LLLIO400/PSoC-Potentiostat/实验记录/软件端到端测试_硬件联机_20261013.md

# 软件端到端测试(硬件联机)· 2026-10-13

> 方式:驱动**真实 GUI 页面按钮**(非底层协议脚本),10 mM CuSO₄ 溶液、
> 真实设备联机(COM8)。覆盖全部六页的完整软件链路。
> 脚本:`tests/hw_gui_e2e.py`;settings 测试前后自动备份/还原。

## 结果:20/20 PASS

| 页面 | 扫描完成 | 取数 | 自动存档 |
|---|---|---|---|
| CV(1 圈) | ✓ | 2801 点 | ✓ +1 |
| LS | ✓ | 1401 点 | ✓ +1 |
| SWV | ✓ | 281 点 | ✓ +1 |
| DPV | ✓ | 281 点 | ✓ +1 |
| CV 2 圈(超容量降级弹窗正确弹出,软件逐圈) | ✓ | 5601 点(≈2×2801) | — |
| ASV(清洗→搅拌沉积 60 s→静置→SWV 溶出) | ✓ | 380 点 | ✓ +1 |
| 计时电流(10 s 后停止) | ✓ 1400 点 | — | ✓ 停止时自动存档 |
| 中途停止(4 s 后点停止) | ✓ 恢复正常,发出 X 复位 | — | — |

## 结论

- 六个方法页的**真实按钮全链路**(参数发送→静置→扫描→取数→画图→自动存档→按钮恢复)全部正常;
- 多圈超容量降级在 GUI 里按设计工作(弹窗提示 + 软件逐圈跑满);
- 停止功能(X 复位、界面恢复、迟到回调丢弃)正常;
- 计时电流停止时自动存档正常(当天新增功能);
- 测试期间无未处理弹窗阻塞、无 bgerror/TclError 噪音。

## 备注

- 首轮 5 个 FAIL 均为测试脚本自身问题(数据读取方式取反、CV2 超时余量不足),与被测软件无关,已修正后 20/20。
- 串口曾因残留进程句柄锁死(PermissionError),拔插 USB 复位后恢复——开发机注意事项,与固件/软件无关。
- 同日全量离线套件 80/80 通过(`test_report.txt`)。
