LLLIO400/PSoC-Potentiostat/layout_preview/about.png

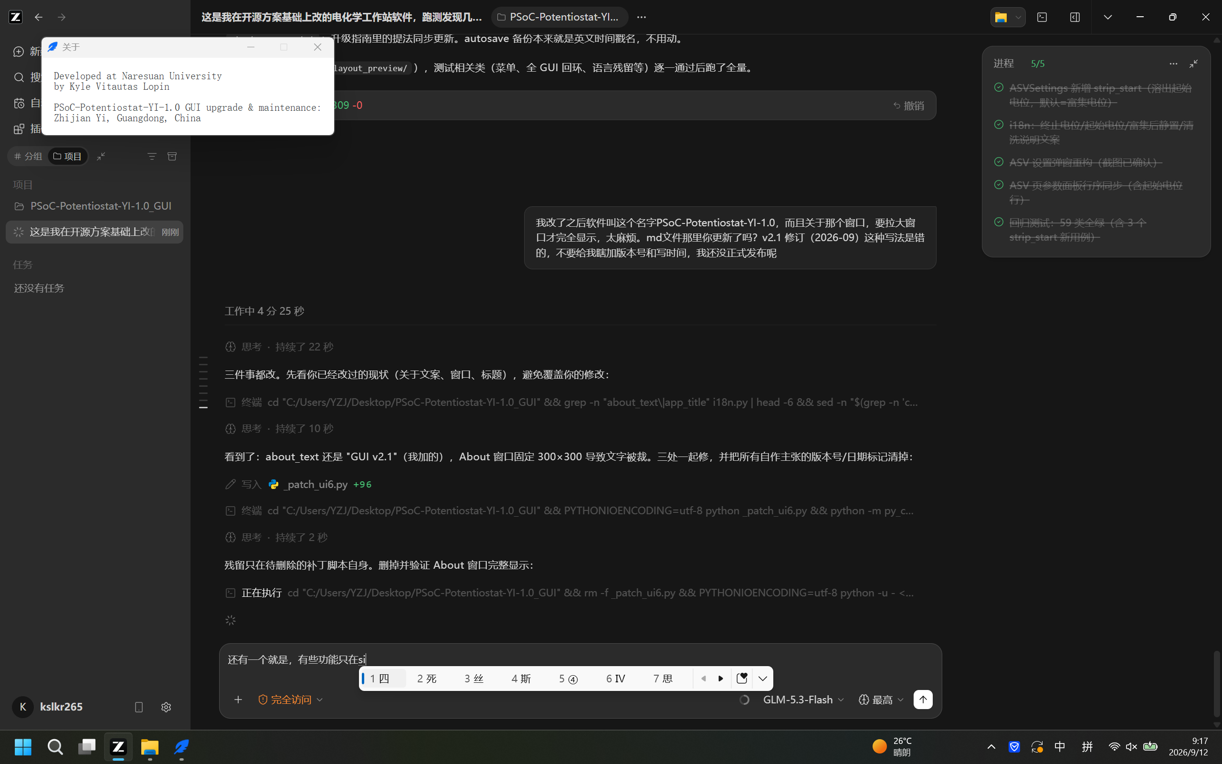
layout_preview/about.png
