LLLIO400/PSoC-Potentiostat/layout_preview/amp.png

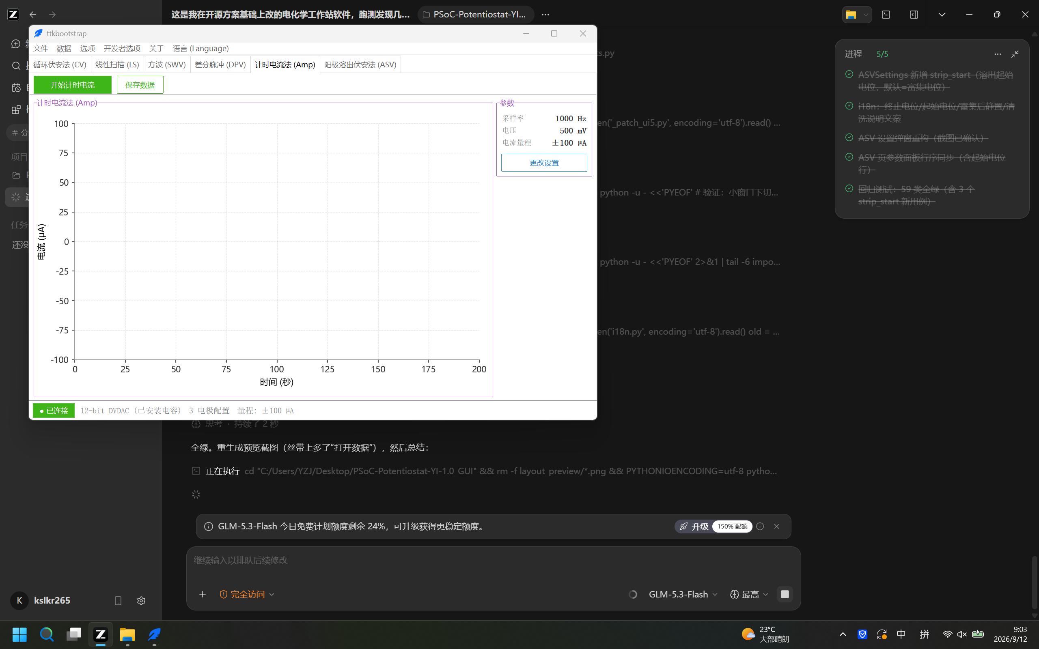
layout_preview/amp.png
