LLLIO400/PSoC-Potentiostat/实验记录/ASV_1000ppb_Bi.png

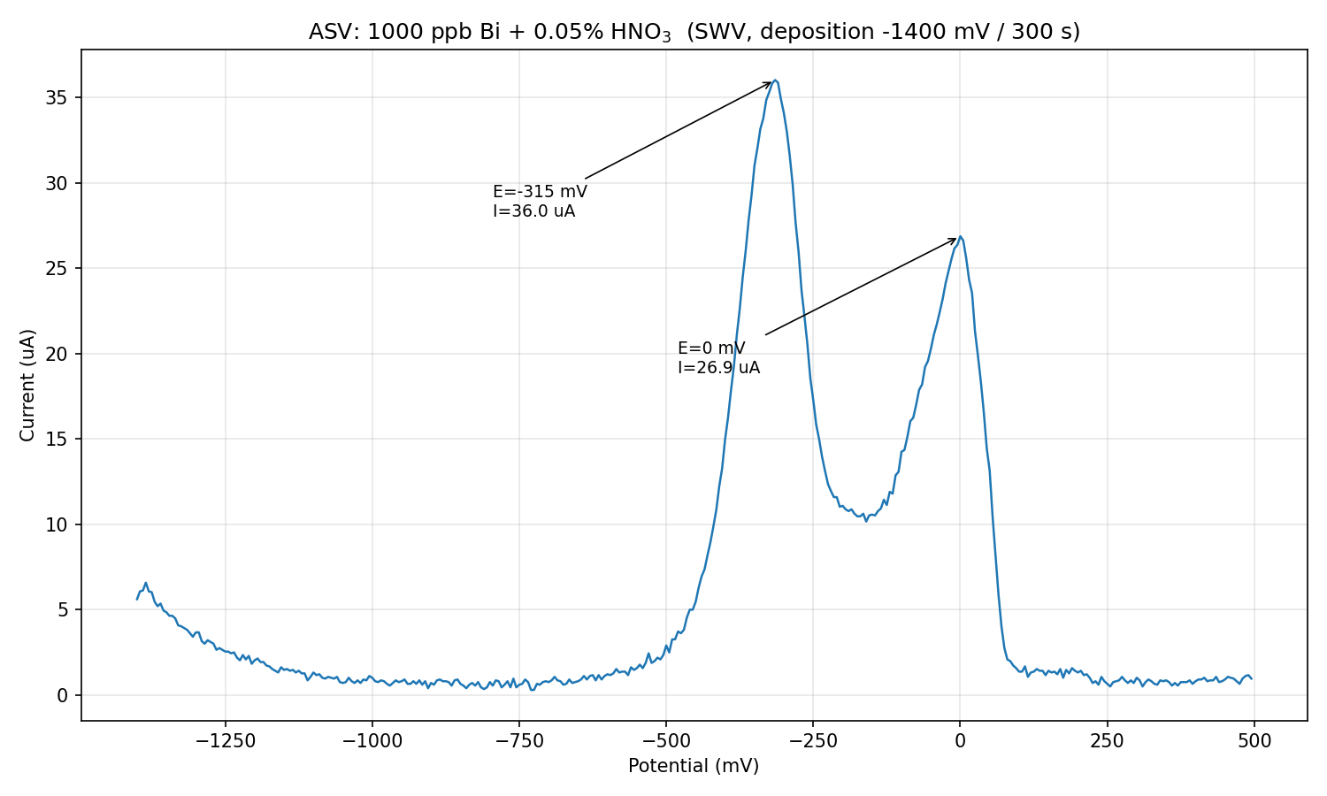
实验记录/ASV_1000ppb_Bi.png
