LLLIO400/PSoC-Potentiostat/实验记录/asv_panel_zoom.png

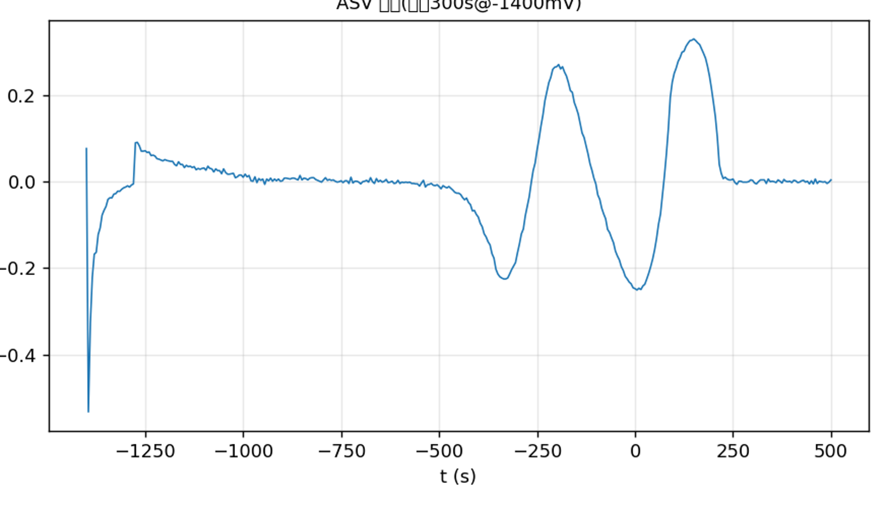
实验记录/asv_panel_zoom.png
