LLLIO400/PSoC-Potentiostat/实验记录/Bi200ppb_ASV寻峰复测.png

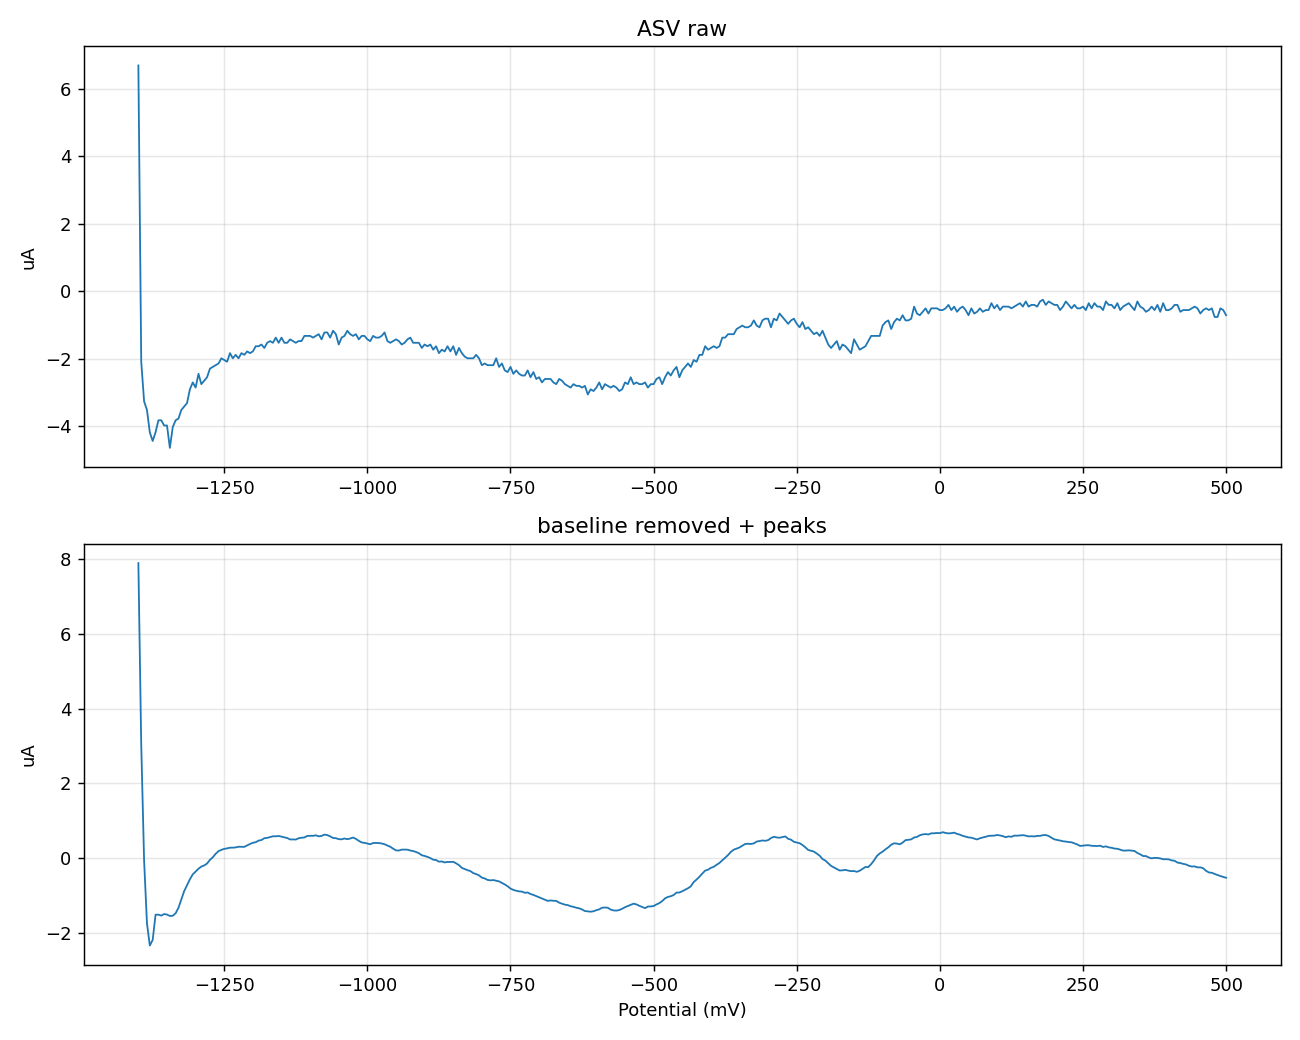
实验记录/Bi200ppb_ASV寻峰复测.png
