LLLIO400/PSoC-Potentiostat/实验记录/Bi200ppb_全功能验证_20261013.png

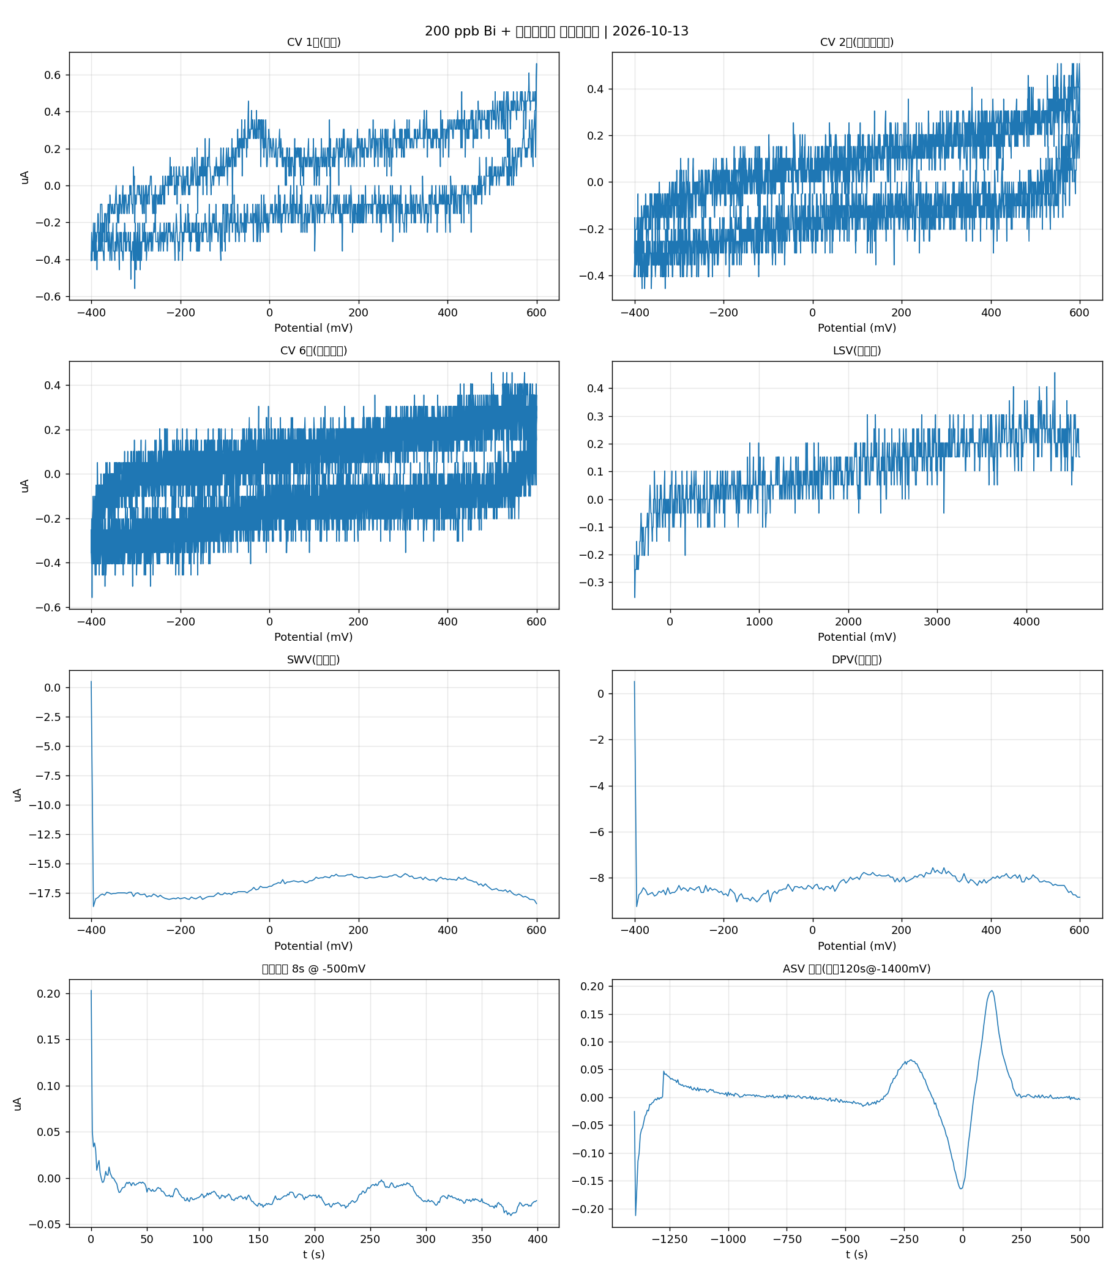
实验记录/Bi200ppb_全功能验证_20261013.png
