LLLIO400/PSoC-Potentiostat/实验记录/cu_swv_deposition_compare.png

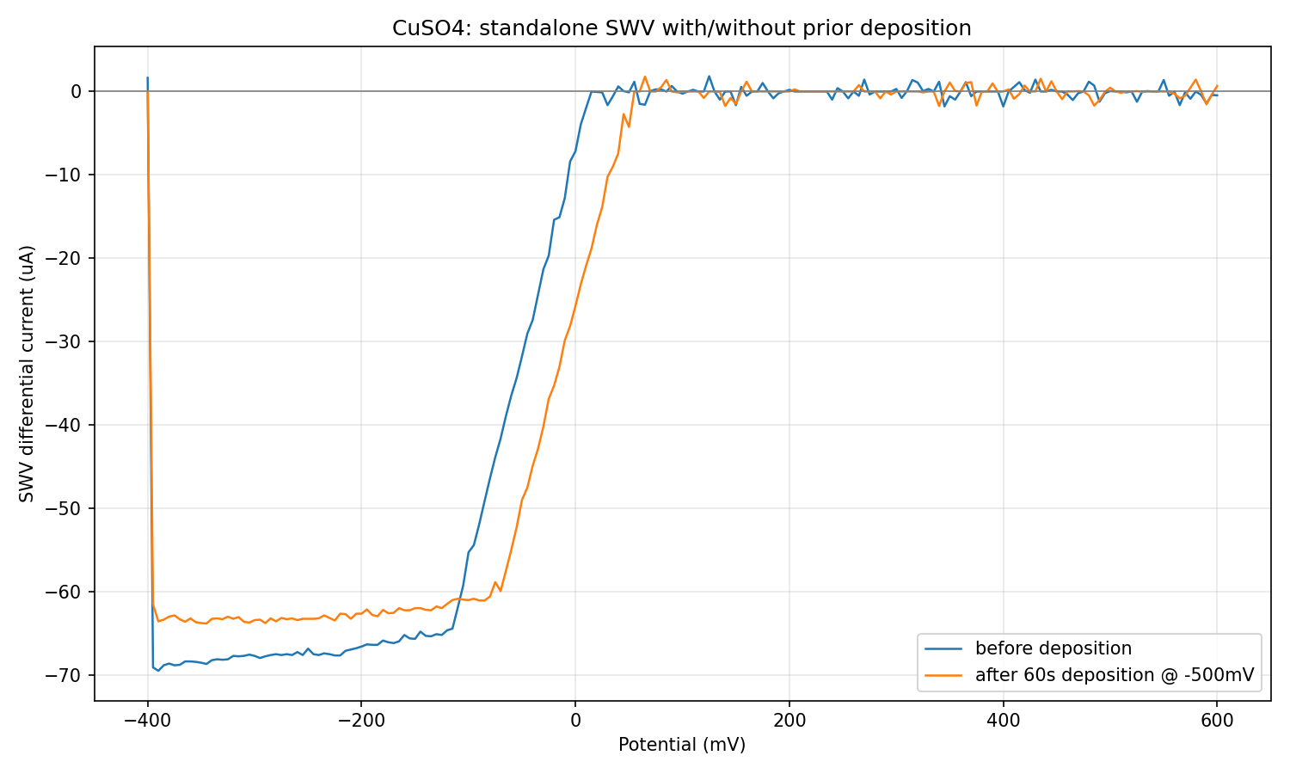
实验记录/cu_swv_deposition_compare.png
