LLLIO400/PSoC-Potentiostat/实验记录/全技术链路验证_20261013.png

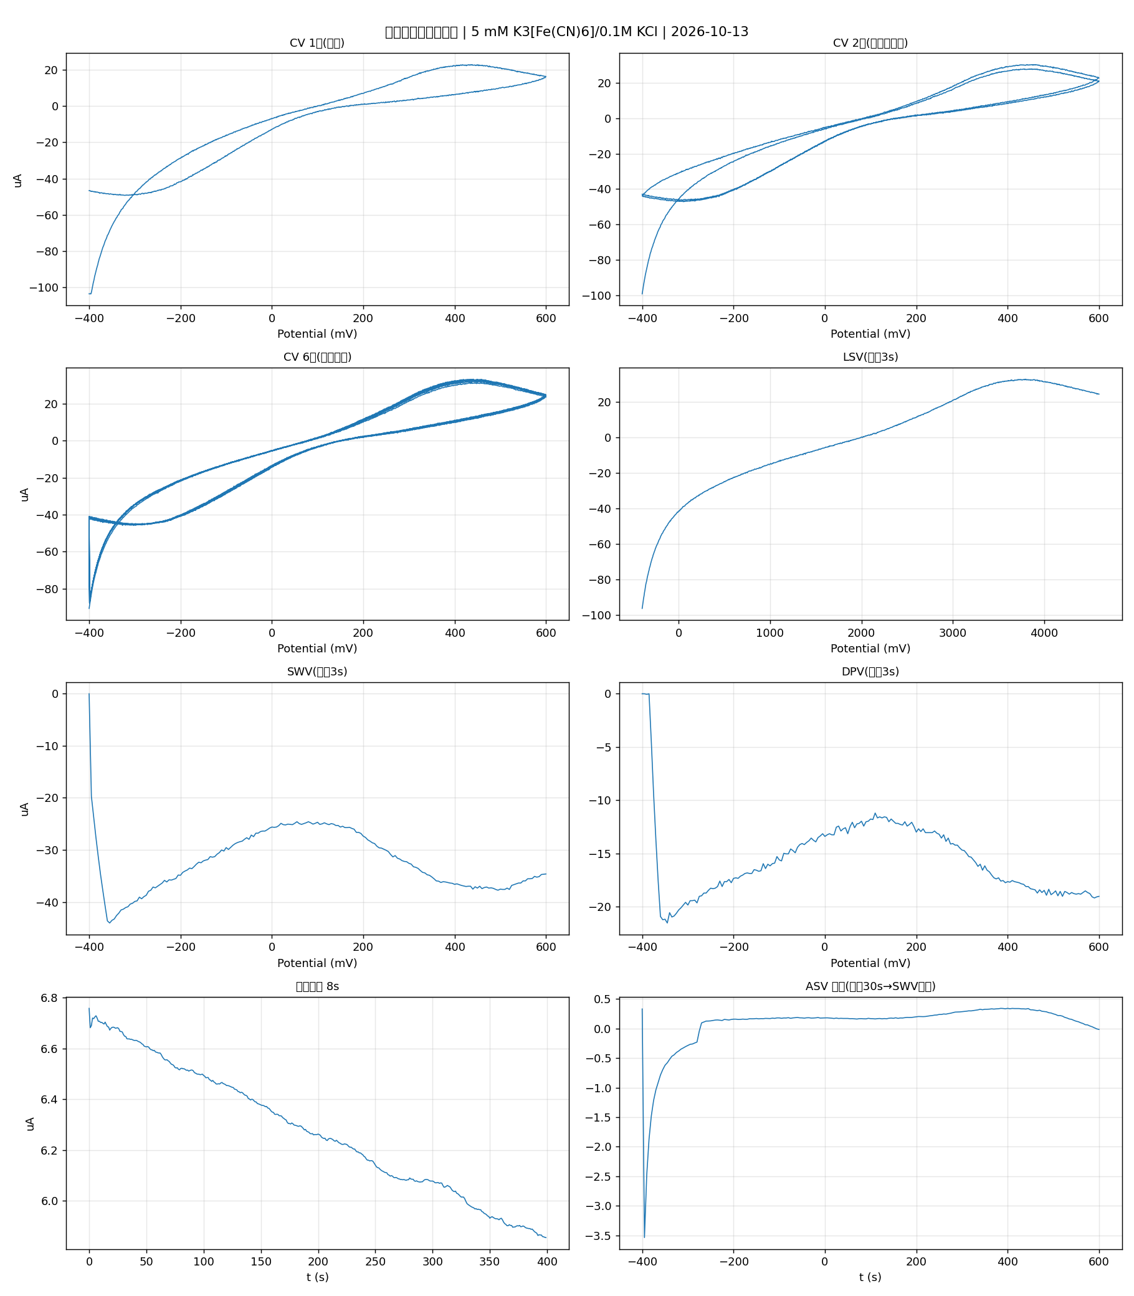
实验记录/全技术链路验证_20261013.png
