LLLIO400/PSoC-Potentiostat/硬件/PCB转接板打板文件/仿真图_(顶层).png

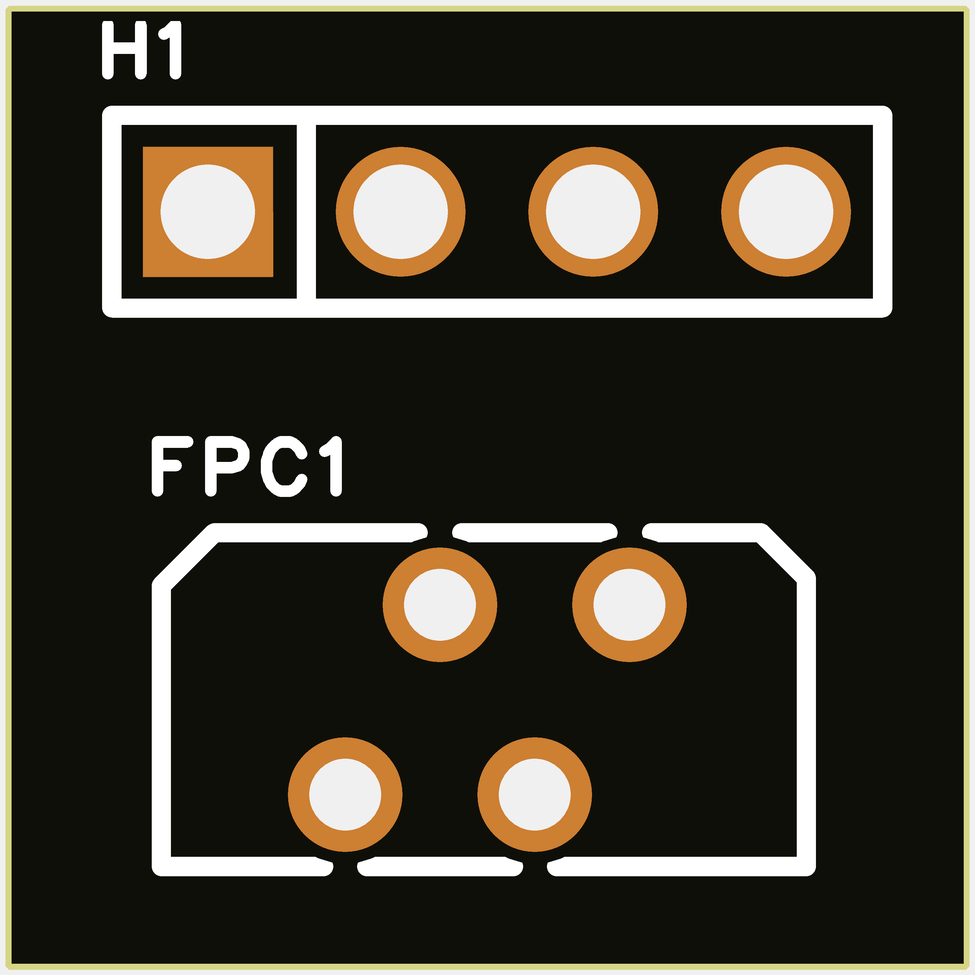
硬件/PCB转接板打板文件/仿真图_(顶层).png
