LLLIO400/PSoC-Potentiostat/硬件/PCB转接板打板文件/用来转接这种4pin的FPC座（插电极）和排针（接电线）.png

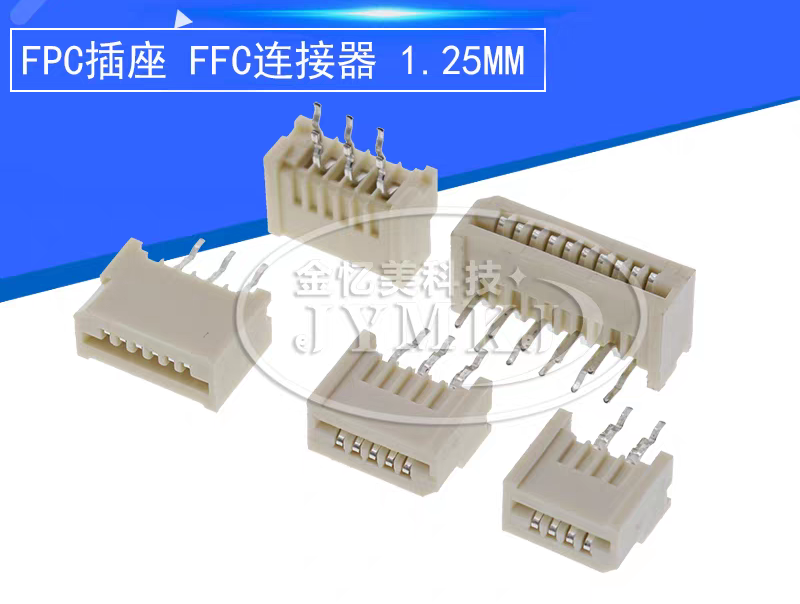
硬件/PCB转接板打板文件/用来转接这种4pin的FPC座（插电极）和排针（接电线）.png
