LLLIO400/PSoC-Potentiostat/硬件/3D打印外壳/ep管支架.step

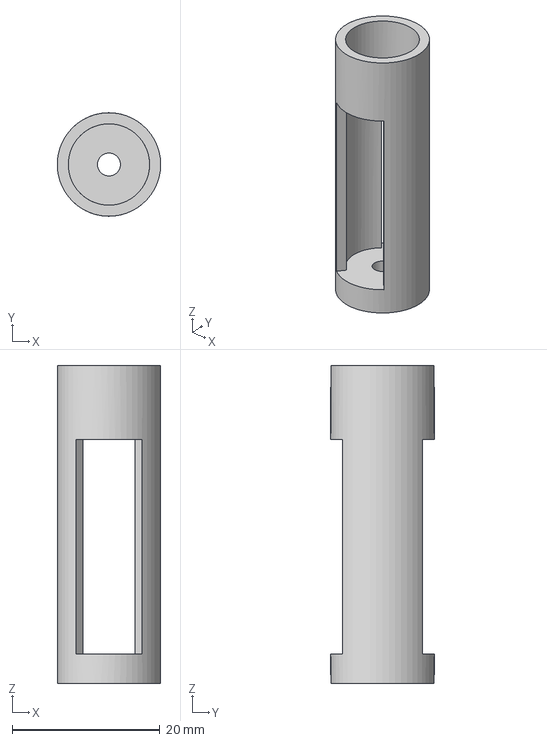
[picture p15: CAD file, 2026-11-03]
硬件/3D打印外壳/ep管支架.step
14.0 x 14.0 x 43.0 mm
