LLLIO400/PSoC-Potentiostat/硬件/3D打印外壳/恒电位仪电极转接板支架2.step

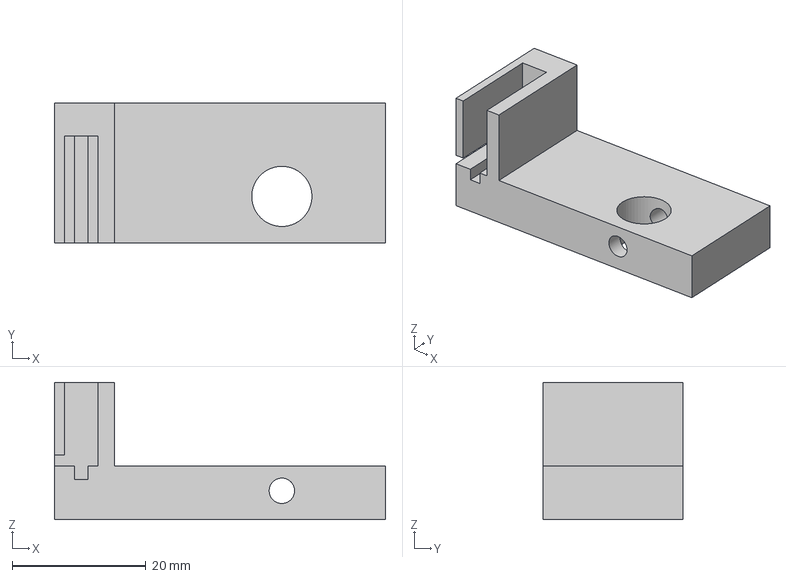
[picture p16: CAD file, 2026-11-03]
硬件/3D打印外壳/恒电位仪电极转接板支架2.step
49.5 x 21.0 x 20.5 mm
