LLLIO400/PSoC-Potentiostat/硬件/3D打印外壳/恒电位仪电极转接板支架1.step

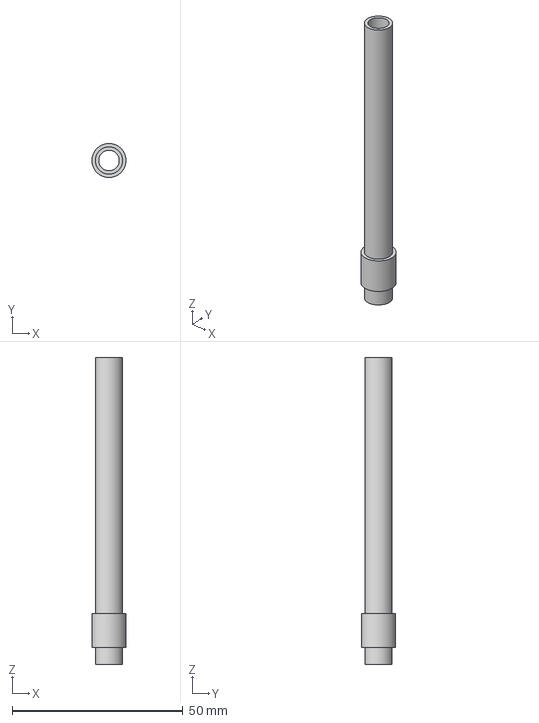
[picture p17: CAD file, 2026-11-03]
硬件/3D打印外壳/恒电位仪电极转接板支架1.step
9.99 x 10.00 x 90.0 mm
