LLLIO400/PSoC-Potentiostat/硬件/3D打印外壳/恒电位仪上盖.step

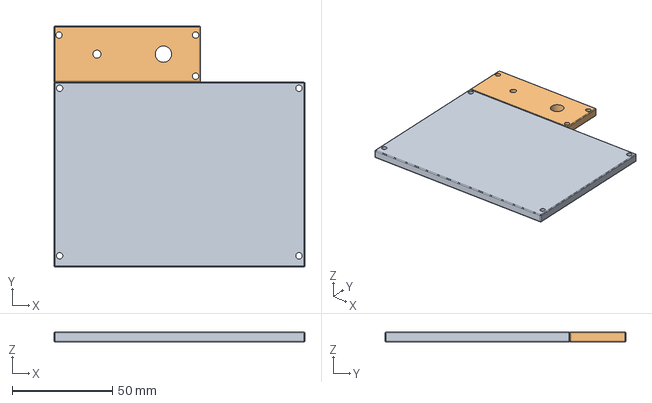
[picture p18: CAD file, 2026-11-03]
硬件/3D打印外壳/恒电位仪上盖.step
125.0 x 120.0 x 5.00 mm
