LLLIO400/PSoC-Potentiostat/硬件/3D打印外壳/恒电位仪外壳.step

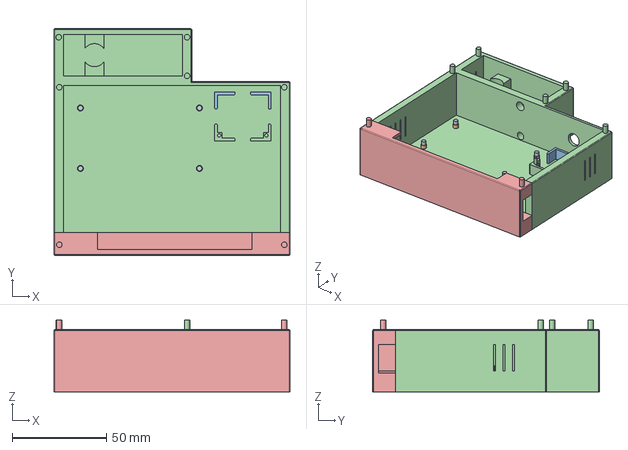
[picture p19: CAD file, 2026-11-03]
硬件/3D打印外壳/恒电位仪外壳.step
125.0 x 120.0 x 38.0 mm
