LLLIO400/PSoC-Potentiostat/PSoC-Potentiostat-YI-1.0_upgrade_guide.md

# PSoC-Potentiostat-YI-1.0 说明文档

> 基于 [Kyle Lopin 的 PSoC-Potentiostat](https://github.com/KyleLopin/PSoC-Potentiostat)（PSoC 5LP / CY8CKIT-059）的开源分支，原作者 Kyle Vitautas Lopin（Naresuan University），上游许可证 CC BY-SA 3.0。
> 本分支维护者：Zhijian Yi（中国广东），新增与修改部分沿用同一许可证。

## 一、项目概览

一套完整的三电极电化学工作站：上位机（Python 3）+ 固件（PSoC 5LP）+ 自动搅拌，围绕**阳极溶出伏安法（ASV）重金属检测**构建，同时覆盖 CV / LSV / SWV / DPV / 计时电流等常规方法。

| 类别 | 功能 |
|---|---|
| 实验方法 | CV（1–9 圈连续循环）、LSV、SWV、DPV、ASV（清洗→富集→静置→溶出→后清洗全流程，自动搅拌）、计时电流 |
| 数据分析 | Savitzky-Golay 平滑、多项式基线扣除、自动寻峰（峰位/峰高/半峰宽/峰面积/电量）、曲线运算（相减/平均/归一化）、峰结果导出 CSV、标准曲线定量（外标法 + 标准加入法） |
| 参数管理 | 方法文件：整套实验参数存为 .json 一键恢复；设置持久化 |
| 无硬件使用 | 模拟模式：内置模拟器跑全套界面（教学/演示/回归）；合成回归数据集 |
| 界面 | 中英双语、命令丝带 + 图区卡片 + 参数卡片、深浅主题、单行状态栏 |
| 质量保障 | 72 类软件测试（模拟器回归）、真机自动判定实测、统一测试报告 |

### 发布包结构

| 包 | 内容 | 用途 |
|---|---|---|
| `PSoC-Potentiostat-YI-1.0_GUI.zip` | 运行包：9 个核心 py、settings.txt、start_gui.bat、install_env.bat、本文档 | 只做实验，下这个 |
| `PSoC-Potentiostat-YI-1.0_test_pack.zip` | 测试包：`tests/` 文件夹（run_tests.bat 入口、run_tests.py、test_refactored.py、fake_device.py、hardware_tests.py、test_data/ 合成数据）+ `tools/`（界面预览脚本）+ **固件** `firmware_patch/`（含搅拌、真 DPV、CV 多圈三个功能增强，详见其内 firmware_guide.md） | 测试或刷固件，下这个 |

---

## 二、硬件方案

### 2.1 核心与信号链

| 功能 | 方案 | 说明 |
|---|---|---|
| 主控 | CY8CKIT-059 (PSoC 5LP) | 沿用原开发板 |
| 电位输出 | 内部 **DVDAC 12-bit**（~1 mV 步进） | P3.1↔GND 焊 100 nF 电容；发 `VS2` 切换量程 |
| 双极性偏置 | **内部 OpAmp 自动完成** | 不需要外部 LM358 偏移小板 |
| 电流测量 | 内部 TIA，8 档反馈电阻（20k~1MΩ） | 命令 `'A'` 配置，固定量程 |
| ADC | Delta-Sigma，**12 位 @ 50 kSPS** | Config1 ±2.048 V / Config2 ±1.024 V；20 位模式采样率过低，不采用 |
| SPE 接口 | 1.25 mm FPC 插座 + 自制转接板 | 引出 WE / RE / CE |

> 结论：**不外接 MCP4725 DAC、不外接 ADS1115 ADC**——内部 DVDAC + DelSig ADC 精度够用，外部模块属于多余。

### 2.2 搅拌系统（ASV 用）

**需求**：ASV 的富集阶段需要搅拌，且**搅拌时长必须严格等于程序设定的沉积时间**（如 60 s），沉积结束后立刻停止——搅拌必须由软件时序自动控制，不能靠手动开关。

**为什么用 ZK-TD2 延时继电器**：PSoC 的 GPIO 引脚（P2.0，3.3 V）电流很小，**不足以直接驱动电机**，必须有一个由 GPIO 控制的电子开关来通断电机回路；选用高电平触发的延时继电器，正好把"电机通断"与"沉积计时"解耦——程序只需给出高/低电平，继电器负责实际的功率切换。

**为什么加 PWM 调速器**：直流马达（GA12-N20）需要可调的驱动电源来设定转速；用现成的 PWM 调速模块可以**一次性旋钮设好转速**，PSoC 侧只输出开关信号，无需另写 PWM 固件或外加驱动三极管，是复用现成模块的最简方案。

**最终方案**：ZK-TD2（P2.0 直驱）+ PWM 调速器 + GA12-N20 电机。

**继电器工作模式**：设为 **P13（信号保持）**——P2.0 高电平期间继电器吸合，信号消失后经 OP（设为最小 0.1 s）断开。**搅拌时长完全由程序沉积时间决定**，改参数不用动模块；调速器的转速则靠模块上的电位器一次性设定，运行中不变。

### 2.3 EIS（预留，未实现）

AD9850 DDS 模块 + PSoC DFB 或 PC 端 FFT 锁相检测，列为下一阶段，暂无计划采购。

---

## 三、固件功能与刷机

### 3.1 命令总表

| 命令 | 功能 | 来源 |
|---|---|---|
| `'S\|XXXX\|YYYY\|ZZZZZ\|AB'` | CV / LSV 波形表（LUT） | 上游 |
| `'S\|…\|AB\|N'` | **CV 多圈**：LUT 生成 N 圈连续三角波（N = 1–9），零间隙循环 | 本分支 |
| `'G'` | SWV 波形表 | 上游 |
| `'P'` | **真 DPV** 波形表（上游无真 DPV，相关函数被注释） | 本分支 |
| `'O\|1'` / `'O\|0'` | 搅拌开关（P2.0 → 继电器） | 本分支 |
| `'g'` | 回读波形表长度（GUI 用于多圈能力探测） | 上游 |
| `'M'` / `'F'` | 计时电流采集 / 流式导出 | 上游 |
| `'B'` `'A'` `'C'` `'T'` `'D'` `'E'` `'H'` `'s'` `'d'` `'X'` | 标定 / TIA 配置 / PWM / 采样率 / 电位 / 数据导出 / 唤醒 / TIA 短接 / 复位 | 上游 |

> **CV 多圈兼容性**：GUI 发参数后用 `'g'` 回读 LUT 长度自动判断固件能力——新固件（含多圈补丁）零间隙连续循环；旧固件自动改用软件逐圈调度（圈间电极停在起始电位约 0.2–1 s，对 CV 无碍）。**不刷新固件也能做多圈 CV**。

### 3.2 实验方法与固件命令对照

| 方法 | 固件命令 | 来源 | 状态 |
|---|---|---|---|
| CV / LSV | `'S'`（多圈：尾缀 `\|N`） | 上游 + 本分支 | ✅ 可用 |
| 计时电流 CA | `'M'` / `'F0'` 流式 | 上游 | ✅ 可用 |
| SWV | `'G'`（LUT 生成器） | 上游自带 | ✅ 可用 |
| DPV | `'P'` | 本分支 | ✅ 已烧录 |
| ASV | 原始 + `'O'` 搅拌 | 上游 + 本分支 | ✅ 可用 |
| EIS | — | — | 未开始 |

### 3.3 时序与数据格式约定

- **SWV / DPV**：每步 2 个采样点成对输出。SWV 为 [E−h, E+h] 两个半周；DPV 为 [脉冲电平, 基线电平]（50% 占空比）。上位机按扫描方向成对差分（上行"后减前"、下行"前减后"），保证阳极峰朝上（IUPAC：氧化电流为正）。
- **扫描分段**：`'L'` 型（LS/SWV/DPV）单段 start→end；`'C'` 型（CV）按圈数分段。上位机的时间估算、采样点数、x 轴均按此对齐。
- **终止码**：数据流以 `-16384`（0xC000）结尾，上位机据此截断。
- **电流符号约定**：遵循 IUPAC（氧化电流为正）。个别焊装反相的机器可在 开发者选项 → 电流符号（诊断） 一键反相，无需改代码。
- **峰方向由反应种类决定**：上行扫过**还原**区（如直接 SWV/DPV 扫 Cu²⁺ 溶液）得到**向下**的还原峰；扫过**氧化**区（ASV 溶出，或电极上已有沉积金属时经过溶出电位）得到**向上**的氧化峰。两者同现属正常，与 CHI 规则一致（2026-10-13 CuSO₄ 实测确认）。

### 3.4 刷机

J10 接 KitProg + PSoC Programmer 烧录；目标芯片刷坏不影响 KitProg，可随时重刷。合并固件（搅拌 + 真 DPV + CV 多圈一次生效）、`Pin_Stir` 引脚添加、时钟配置排错等完整步骤见 `firmware_patch/firmware_guide.md`；手把手图文版见同仓库 `刷固件图文说明`（2026-10-13 按此流程真机刷入并验证：CV 多圈连续循环、波形表长度探测、全链路数据均正常）。

---

## 四、上位机功能

### 4.1 界面布局

- 每页自上而下：**顶部命令丝带**（运行 | 保存/删除 | 数据分析组：框选峰区域/平滑/基线扣除/自动寻峰/还原曲线 | 右侧：打开数据/更改数据样式/添加工具栏）→ 分隔线 → **图区卡片**（带技术名标题）+ 右侧**两列参数卡片**；
- matplotlib 图区与界面主题联动（浅色白底/深色深底浅字），坐标轴去顶右脊线、虚线网格；
- 底部**单行状态栏**：`● 连接状态`（绿/黄/红）│ 电压源 │ 电极制式 │ 电流量程；
- 扫描运行中"运行"按钮变红色"停止"，结束恢复绿色；有扫描进行中时切换模拟模式会被拒绝并提示；
- **界面主题**（选项 → 主题）：浅色 Cosmo / 深色 Darkly / 深色 Superhero，即时切换并记住选择；
- 语言：中英双语全界面覆盖（含图区标题、丝带、弹窗），菜单重建式刷新；
- 预览截图：`python tools\layout_preview.py` 生成四页截图到 `layout_preview/`。

### 4.2 实验方法

- **CV**：起始/终止电位、扫速、起始方式（起点/零点）、**循环圈数 1–9**——容量内由固件波形表零间隙连续循环；超出波形表容量（约 5000 点）时自动改用软件逐圈调度跑满设定圈数（弹窗提示，圈间约停 1 秒），不会拒绝设置；
- **扫描前静置**：CV/LS/SWV/DPV 四页通用，运行时先跳到起始电位等待"静置时间"（默认 3 秒，设置窗口可调，0 = 关闭）再开始扫描——消除电位跳变暂态造成的起点负漂/削顶（等效 CHI 静置时间；ASV 页由富集后静置覆盖）；
- **LS / SWV / DPV**：独立页，脉冲参数（高度/增量/周期）三页同一套含义——周期 = 每一步总时长（脉冲与基底各占一半）；
- **ASV**：设置按实验流程分组——
  - 清洗步骤：清洗电压、清洗时间、启用开关、**溶出后自动清洗**（沿用本组清洗参数）；
  - 富集步骤：富集电压、富集时间、搅拌开关、**富集后静置**；
  - 溶出步骤：溶出方式（LS/DPV/SWV）、**起始电位与终止电位**（电位范围，起始缺省等于富集电位）、扫描速率；
  - 运行时序自动执行：清洗（可选搅拌）→ 富集（搅拌）→ 静置 → 溶出扫描 →（可选）后清洗；
- **计时电流**：电位、采样率，流式接收绘图。

### 4.3 数据分析工具

- **寻峰**：平滑 → 基线扣除（框选区域或自动）→ 峰检测，结果含峰位/峰高/半峰宽/**峰面积（µA·mV）/电量（µC = 面积÷1000÷扫速）**，可在图上标注并**导出峰结果 CSV**；
- **曲线运算**：当前页多条曲线相减（A−B，如扣背景）、平均、归一化，结果作为新曲线叠加；
- **标准曲线 / 定量分析**：标准点可手动录入或从曲线 CSV 批量导入（自动寻峰取峰面积/峰高）；最小二乘拟合 y = k·x + b（R²）；**外标法**由未知样信号反算浓度，可选**标准加入法**（外推信号 0，抗基体干扰）——替代 Origin 手工拟合；
- **采样饱和提示**：数据触及 ADC 量程极限（曲线平头）时自动弹窗，提示更换更大量程重扫（调显示范围无法恢复削顶数据）。

### 4.4 方法文件与数据存取

- **方法文件**（文件 → 保存/加载方法文件…）：整套 CV / ASV / 计时电流参数 + 电流量程 + 模拟模式存为 .json；加载后所有页面参数与横轴立即刷新，并在下次运行强制重发固件参数；
- **CSV 存取**：保存带 `# key: value` 元数据头（实验类型/参数），打开时自动路由到对应实验页（CV/LS/SWV/DPV/ASV/计时电流），老文件无元数据按表头推断；编码 utf-8-sig 保存、读取失败自动回退 GBK；
- **自动备份**：每次扫描完成（或手动停止）自动备份到 `autosave_backup/`，全部方法页覆盖——含计时电流（`_AMP.csv`，time/current 两列，可直接载回）；
- **数据菜单与丝带对齐**：删除当前页、曲线运算、导出峰结果、更改样式、标准曲线均可从菜单进入。

### 4.5 模拟模式（无需硬件）

选项 → 模拟模式（勾选即时生效）：整套界面跑在内置模拟器上，包含 CV 多圈与各方法合成峰形，连接状态显示"● 模拟模式"。用途：教学演示、无硬件核对参数与流程、截图写文档、回归验证。需测试包的 `tests/fake_device.py`；有扫描进行中时不可切换。

### 4.6 开发者选项

ADC 通道选择、数据类型（换算电流/原始计数）、导出 LUT、PWM 比较值、**电流符号（诊断）反相开关**（模拟前端输出反相的机器用）。

---

## 五、接线总表

### 5.1 电极与电容

- **WE → P0.0 (J2_11)，RE → P3.4 (J2_21)，CE → P3.6 (J2_19)**；SPE 三合一电极触点对应接。
- 三电极对照：WE = Working Electrode = 工作电极；RE = Reference Electrode = 参比电极；CE = Counter Electrode = 对电极/辅助电极。**液滴必须覆盖 SPE 三段，参比段最易漏。**
- DVDAC 需在 **P3.1↔GND 焊 100 nF**。
- 避开 KitProg 占用脚：P12.0 / P12.1 (I2C)、P12.6 / P12.7 (UART)。

### 5.2 搅拌接线

| 从 | 到 | 说明 |
|---|---|---|
| J2_01 (VDD) | ZK-TD2 左侧 DC+ | 5 V |
| J1_25 (GND) | ZK-TD2 左侧 DC- | 地 |
| J1_01 (P2.0) | ZK-TD2 左侧 SIGN | 触发信号 |
| J1_26 (VDDIO) | ZK-TD2 右侧 COM | 第二路 5 V（一脚只接一线） |
| ZK-TD2 右侧 NO | 调速器 V+ → 马达 | 开关输出串入马达回路 |
| J2_02 (GND) | 调速器 V- | J2_26 已焊电容，勿用 |

> **接线要点**：高电平触发须 **SIGN + DC- 两根线**（共地线回路），只接一根不工作；马达接继电器 **COM/NO**（开关输出），**不可接 DC+/DC-**（模块电源）。

---

## 六、使用方式

```bat
install_env.bat        :: 安装依赖（pyserial / ttkbootstrap / scipy / matplotlib）
start_gui.bat          :: 启动 GUI
tests\run_tests.bat    :: 环境诊断 + 全量测试（可选真机实测）
```

**ASV 典型流程**：清洗（可选）→ 富集（搅拌）→ 静置 10–15 s → 溶出（LS/DPV/SWV）→ 可选溶出后清洗。富集即恒电位电解（非 CV），溶出用扫描法。

**定量流程**：标准曲线（数据 → 标准曲线 / 定量分析）→ 从曲线文件导入各浓度标准点 → 拟合（看 R²）→ 测未知样 → 输入信号反算浓度。

**推荐验证试剂**（已配制）：

| 用途 | 配方 | 建议条件 |
|---|---|---|
| CV 验证 | 5 mM K₃[Fe(CN)₆] + 0.1 M KCl（82 mg + 0.373 g，定容 50 mL） | −0.2~+0.6 V，峰电位差应趋近 59 mV |
| ASV 验证 | CuSO₄ 100 mM 母液（0.80 g / 50 mL），0.1 M 乙酸缓冲液 pH 4.5 稀释 | 富集 −600 mV / 60 s 开搅拌，静置 15 s，LS 溶出峰约 0 V；1 µM Cu²⁺ ≈ 0.064 ppm |

---

## 七、测试与质量保障

- **软件测试**：`tests/fake_device.py` 模拟固件（覆盖 LS/CV 分段与多圈、`Done\x00` 结尾、首点、终止码、CA 流式协议等），共 **80 个测试类**（位于 `tests/`），逐类独立子进程运行（单类超时保护）。真机复检脚本：`tests/verify_multicycle_cv.py`（多圈全链路）与 `tests/verify_patched_multicycle.py`（多圈固件 LUT 连续循环），结果与图输出到 `实验记录/`。
- **真机实测**：可选 9 项自动判定——连接识别、标定合理性、小 LS 全链路、大 LUT CV、小 SWV、小 DPV、连续 3 次重复扫描、中途 X 复位恢复、计时电流；实测与理论耗时偏差过大记 WARN，超时/无 Done/点数异常判 FAIL。
- **统一报告**：环境诊断 + 全部测试汇总输出 `test_report.txt`（utf-8-sig + CRLF，记事本可直接读），失败时提示附报告给开发者。

---

## 八、已知局限与注意事项

- **CA 计时电流（上游 4 通道轮采设计）**：固件让 ADC 在 4 个通道间轮流各采一段，本机只接 1 个通道，GUI 只取自己那 1/4 的数据。因此：① 有效采样率是固件标称值的 1/4，图中折线只是把离散采样点连起来，段与段之间的连线不代表中间有测量（慢信号无影响，信号突变瞬间有微小失真）；② 通道通知消息偶尔会丢一条——丢别的通道无影响，丢自己通道就缺一小段数据、下一段自动接上，不会错位或崩溃。根治需改固件为单通道采集（上游核心设计，暂不动）。
- **EIS**：尚未实现，列为下一阶段。
- **固件 Sleep/Wakeup（已修复并已刷入，2026-10-13 真机验证）**：上游 `'X'`（停止/复位）会让硬件休眠且无对应唤醒，导致"停止后重连标定失败、扫描无响应"。本分支固件已改为 `'X'` 只关中断不休眠硬件（见 `firmware_patch/firmware_guide.md` 功能 4）；当日实测：多次 `'X'`/扫描收尾后重连，标定正常、扫描正常，验证清单 4 步闭环。GUI 侧的 `'H'` 唤醒与自然收尾规避保留，用于兼容未重刷的旧固件。
- **自定义 TIA 电阻**（选项菜单，默认置灰前的旧入口）：需配合外部电阻硬件实测后再启用，当前不建议作为准确量程使用。
- **模拟模式**：依赖测试包的 `tests/fake_device.py`；扫描进行中不可切换。

---

## 九、开源链接与许可

- 上游固件：https://github.com/KyleLopin/PSoC-Potentiostat
- 上游 GUI：https://github.com/KyleLopin/Potentiostat_GUI
- 原始论文：Lopin, P.; Lopin, K. V. *PLoS ONE* **2018**, *13*(7), e0201353（DOI: 10.1371/journal.pone.0201353）

**许可**：上游代码 Copyright (c) 2015-2023 Kyle Lopin，CC BY-SA 3.0；本分支新增与修改文件 Copyright (c) Zhijian Yi，同一许可证。再分发请保留上游版权头。
