LLLIO400/PSoC-Potentiostat/实验记录/实拍素材_20261103/装配内部_数显与继电器模块.jpg

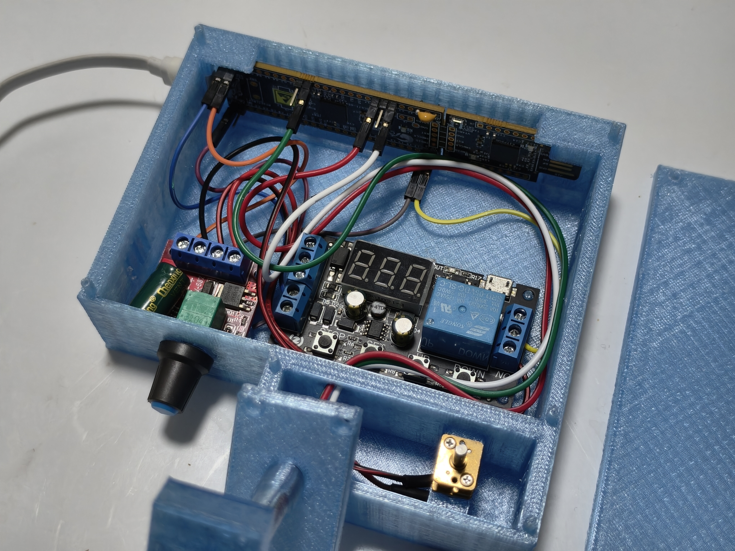
实验记录/实拍素材_20261103/装配内部_数显与继电器模块.jpg
