LLLIO400/PSoC-Potentiostat/实验记录/实拍素材_20261103/装配内部_电路模块与接线.jpg

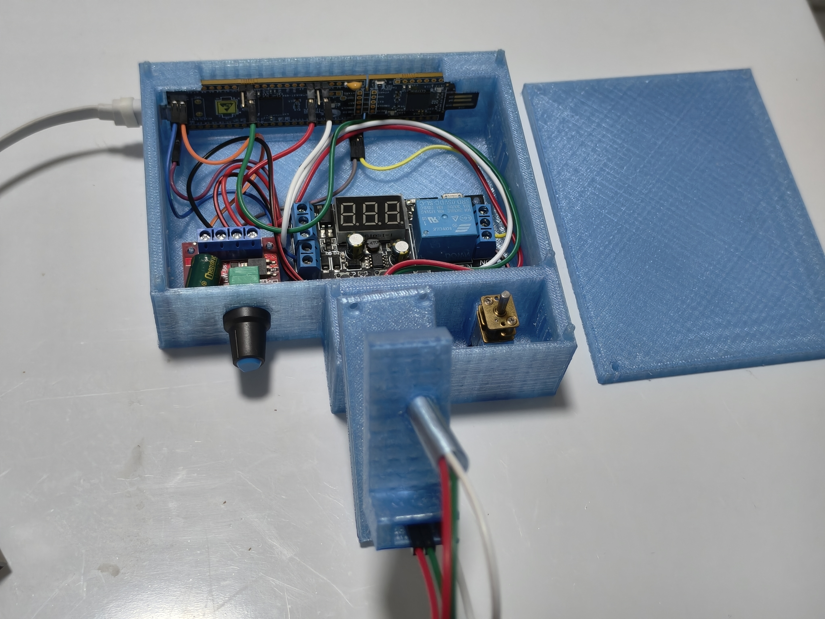
实验记录/实拍素材_20261103/装配内部_电路模块与接线.jpg
