LLLIO400/PSoC-Potentiostat/tests/test_data/AMP_cottrell_120s.csv

# experiment: AMP
# sampling_rate_Hz: 20
# voltage_mV: 500
time | current (合成数据)
0.05 | 19.9107
0.1 | 14.5371
0.15 | 12.0996
0.2 | 10.6963
0.25 | 9.5057
0.3 | 8.7873
0.35 | 8.1934
0.4 | 7.7583
0.45 | 7.5312
0.5 | 7.0288
0.55 | 6.8727
0.6 | 6.5363
0.65 | 6.3479
0.7 | 6.1994
0.75 | 6.151
0.8 | 5.9283
0.85 | 5.6099
0.9 | 5.5599
0.95 | 5.4031
1.0 | 5.5114
1.05 | 5.3917
1.1 | 5.2964
1.15 | 5.2144
1.2 | 5.1075
1.25 | 5.0914
1.3 | 4.9718
1.35 | 4.7418
1.4 | 4.8546
1.45 | 4.6839
1.5 | 4.7058
1.55 | 4.5928
1.6 | 4.4993
1.65 | 4.429
1.7 | 4.4002
1.75 | 4.319
1.8 | 4.2157
1.85 | 4.3838
1.9 | 4.3365
1.95 | 4.3534
2.0 | 4.2271
2.05 | 4.1497
2.1 | 4.1728
2.15 | 3.9548
2.2 | 4.0847
2.25 | 3.983
2.3 | 3.8724
2.35 | 3.8506
2.4 | 3.9179
2.45 | 3.8093
2.5 | 3.8442
2.55 | 3.8618
2.6 | 3.7735
2.65 | 3.6693
2.7 | 3.7533
2.75 | 3.6533
2.8 | 3.6307
2.85 | 3.5962
2.9 | 3.6263
2.95 | 3.5173
3.0 | 3.6702
3.05 | 3.741
3.1 | 3.5523
3.15 | 3.6321
3.2 | 3.6778
3.25 | 3.3927
3.3 | 3.4045
3.35 | 3.5865
3.4 | 3.5792
3.45 | 3.5029
3.5 | 3.3429
3.55 | 3.4032
3.6 | 3.5241
3.65 | 3.5142
3.7 | 3.4744
3.75 | 3.2798
3.8 | 3.4607
3.85 | 3.3029
3.9 | 3.3917
3.95 | 3.2044
4.0 | 3.4414
4.05 | 3.318
4.1 | 3.341
4.15 | 3.1752
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
