LLLIO400/PSoC-Potentiostat/tests/test_data/CV_K3FeCN6_3cycles.csv

# experiment: CV
# start_voltage_mV: -400
# end_voltage_mV: 700
# sweep_rate_V/s: 0.1
# cycles: 3
voltage | CV (合成数据)
 | regression mock
-400 | -0.2114
-395 | -0.419
-390 | 0.1811
-385 | -0.5131
-380 | 0.0431
-375 | -0.1612
-370 | -0.5304
-365 | 0.0089
-360 | -0.555
-355 | -0.0796
-350 | -0.5162
-345 | -0.4911
-340 | -0.0906
-335 | 0.3922
-330 | -0.4514
-325 | -0.3321
-320 | 0.1529
-315 | 0.5373
-310 | 0.0925
-305 | -0.124
-300 | 0.5715
-295 | -0.5441
-290 | 0.4302
-285 | -0.2525
-280 | -0.4269
-275 | -0.4586
-270 | -0.2298
-265 | 0.3794
-260 | -0.3831
-255 | 0.0979
-250 | 0.1667
-245 | -0.1531
-240 | 0.0573
-235 | -0.5247
-230 | -0.5285
-225 | -0.3528
-220 | 0.2165
-215 | -0.0869
-210 | -0.223
-205 | 0.1027
-200 | -0.0562
-195 | -0.2403
-190 | 0.3533
-185 | 0.2388
-180 | -0.3071
-175 | 0.0893
-170 | 0.0302
-165 | 0.4502
-160 | 0.2753
-155 | -0.2545
-150 | 0.5761
-145 | -0.4584
-140 | -0.0985
-135 | 0.3082
-130 | -0.4183
-125 | -0.0143
-120 | -0.5547
-115 | 0.199
-110 | 0.3129
-105 | 0.0804
-100 | 0.4392
-95 | -0.2412
-90 | 0.2073
-85 | 0.0723
-80 | 0.0347
-75 | -0.1428
-70 | 0.2765
-65 | 0.3444
-60 | -0.3001
-55 | -0.1807
-50 | -1.0511
-45 | -0.4759
-40 | -0.7946
-35 | -0.7064
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
