LLLIO400/PSoC-Potentiostat/tests/test_data/DPV_ferri_pulse.csv

# experiment: DPV
# pulse_height_mV: 50
# pulse_inc_mV: 5
# pulse_period_ms: 100
voltage | DPV (合成数据)
 | regression mock
-600 | 0.3286
-595 | 0.2412
-590 | 0.2051
-585 | 0.6565
-580 | 0.4577
-575 | 0.5277
-570 | 0.4482
-565 | 0.3492
-560 | 0.5608
-555 | 0.4704
-550 | 0.596
-545 | 0.5269
-540 | 0.6363
-535 | 0.3991
-530 | 0.2312
-525 | 0.2308
-520 | 0.5775
-515 | 0.2469
-510 | 0.5419
-505 | 0.5243
-500 | 0.1902
-495 | 0.6279
-490 | 0.1798
-485 | 0.6829
-480 | 0.6701
-475 | 0.2977
-470 | 0.6067
-465 | 0.613
-460 | 0.2514
-455 | 0.5811
-450 | 0.2561
-445 | 0.7325
-440 | 0.6006
-435 | 0.778
-430 | 0.2248
-425 | 0.3861
-420 | 0.5701
-415 | 0.5658
-410 | 0.3129
-405 | 0.739
-400 | 0.717
-395 | 0.3927
-390 | 0.3021
-385 | 0.6179
-380 | 0.4643
-375 | 0.6207
-370 | 0.5214
-365 | 0.4651
-360 | 0.2439
-355 | 0.3146
-350 | 0.5114
-345 | 0.676
-340 | 0.4972
-335 | 0.6912
-330 | 0.5711
-325 | 0.7782
-320 | 0.6458
-315 | 0.4486
-310 | 0.3415
-305 | 0.3003
-300 | 0.2874
-295 | 0.7839
-290 | 0.7938
-285 | 0.7226
-280 | 0.3401
-275 | 0.6736
-270 | 0.3566
-265 | 0.8162
-260 | 0.6787
-255 | 0.738
-250 | 0.6564
-245 | 0.5447
-240 | 0.8054
-235 | 0.8761
-230 | 0.4469
-225 | 0.567
-220 | 0.7474
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
