LLLIO400/PSoC-Potentiostat/tests/test_data/LS-ASV_Pb_100ppb.csv

# experiment: ASV
# sweep_type: LS
# low_voltage_mV: -1500
# high_voltage_mV: 500
# plate_volt_mV: -1500
# plate_time_s: 60
# conc_ppb: 100
voltage | ASV (合成数据)
 | regression mock
-1500 | 0.4148
-1484 | 0.3539
-1468 | 0.2413
-1452 | 0.3157
-1436 | 0.3844
-1420 | 0.2325
-1404 | 0.4279
-1388 | 0.2397
-1372 | 0.2573
-1356 | 0.3626
-1340 | 0.3547
-1324 | 0.4133
-1308 | 0.3954
-1292 | 0.329
-1276 | 0.3531
-1260 | 0.2965
-1244 | 0.2527
-1228 | 0.4761
-1212 | 0.3227
-1196 | 0.3706
-1180 | 0.4597
-1164 | 0.3242
-1148 | 0.2984
-1132 | 0.3858
-1116 | 0.4885
-1100 | 0.4974
-1084 | 0.3551
-1068 | 0.5076
-1052 | 0.4349
-1036 | 0.4949
-1020 | 0.3485
-1004 | 0.3069
-988 | 0.4286
-972 | 0.4745
-956 | 0.3809
-940 | 0.5564
-924 | 0.3638
-908 | 0.5619
-892 | 0.4487
-876 | 0.5106
-860 | 0.4025
-844 | 0.4041
-828 | 0.3739
-812 | 0.5856
-796 | 0.562
-780 | 0.4435
-764 | 0.592
-748 | 0.5058
-732 | 0.391
-716 | 0.5787
-700 | 0.4269
-684 | 0.4142
-668 | 0.5167
-652 | 0.4513
-636 | 0.6049
-620 | 0.5026
-604 | 0.4882
-588 | 0.5583
-572 | 0.4356
-556 | 0.4437
-540 | 0.5257
-524 | 0.5795
-508 | 0.5333
-492 | 0.6766
-476 | 0.8888
-460 | 1.2272
-444 | 1.6482
-428 | 2.7165
-412 | 3.9901
-396 | 6.1138
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
