LLLIO400/PSoC-Potentiostat/tests/test_data/LS-ASV_Pb_20ppb.csv

# experiment: ASV
# sweep_type: LS
# low_voltage_mV: -1500
# high_voltage_mV: 500
# plate_volt_mV: -1500
# plate_time_s: 60
# conc_ppb: 20
voltage | ASV (合成数据)
 | regression mock
-1500 | 0.207
-1484 | 0.2949
-1468 | 0.2853
-1452 | 0.2351
-1436 | 0.3833
-1420 | 0.3443
-1404 | 0.2915
-1388 | 0.3331
-1372 | 0.2782
-1356 | 0.2897
-1340 | 0.3183
-1324 | 0.3317
-1308 | 0.2389
-1292 | 0.4107
-1276 | 0.2802
-1260 | 0.3807
-1244 | 0.2739
-1228 | 0.2848
-1212 | 0.4395
-1196 | 0.3819
-1180 | 0.4104
-1164 | 0.264
-1148 | 0.3633
-1132 | 0.3142
-1116 | 0.3025
-1100 | 0.493
-1084 | 0.4785
-1068 | 0.5088
-1052 | 0.3476
-1036 | 0.3854
-1020 | 0.5097
-1004 | 0.4345
-988 | 0.3545
-972 | 0.3334
-956 | 0.4413
-940 | 0.4634
-924 | 0.367
-908 | 0.5651
-892 | 0.5598
-876 | 0.5519
-860 | 0.4041
-844 | 0.4432
-828 | 0.5325
-812 | 0.3897
-796 | 0.4279
-780 | 0.3868
-764 | 0.4489
-748 | 0.4468
-732 | 0.3986
-716 | 0.4031
-700 | 0.6141
-684 | 0.5178
-668 | 0.427
-652 | 0.4709
-636 | 0.543
-620 | 0.6153
-604 | 0.5828
-588 | 0.5983
-572 | 0.5326
-556 | 0.6028
-540 | 0.546
-524 | 0.5849
-508 | 0.5481
-492 | 0.6661
-476 | 0.6117
-460 | 0.5597
-444 | 0.7876
-428 | 1.0919
-412 | 1.3527
-396 | 1.7835
-380 | 2.1921
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
