LLLIO400/PSoC-Potentiostat/tests/test_data/LS-ASV_Pb_50ppb.csv

# experiment: ASV
# sweep_type: LS
# low_voltage_mV: -1500
# high_voltage_mV: 500
# plate_volt_mV: -1500
# plate_time_s: 60
# conc_ppb: 50
voltage | ASV (合成数据)
 | regression mock
-1500 | 0.2573
-1484 | 0.3305
-1468 | 0.2958
-1452 | 0.2753
-1436 | 0.3944
-1420 | 0.4102
-1404 | 0.2451
-1388 | 0.3935
-1372 | 0.4087
-1356 | 0.3185
-1340 | 0.4476
-1324 | 0.368
-1308 | 0.2468
-1292 | 0.2553
-1276 | 0.4661
-1260 | 0.3537
-1244 | 0.3514
-1228 | 0.432
-1212 | 0.4474
-1196 | 0.3323
-1180 | 0.4582
-1164 | 0.3117
-1148 | 0.4027
-1132 | 0.387
-1116 | 0.3927
-1100 | 0.511
-1084 | 0.3472
-1068 | 0.4799
-1052 | 0.532
-1036 | 0.5083
-1020 | 0.4087
-1004 | 0.5416
-988 | 0.3239
-972 | 0.4347
-956 | 0.4595
-940 | 0.5018
-924 | 0.5627
-908 | 0.409
-892 | 0.5343
-876 | 0.4823
-860 | 0.4289
-844 | 0.4374
-828 | 0.4814
-812 | 0.5503
-796 | 0.4762
-780 | 0.5405
-764 | 0.4257
-748 | 0.4731
-732 | 0.6008
-716 | 0.4382
-700 | 0.3953
-684 | 0.5464
-668 | 0.6182
-652 | 0.6076
-636 | 0.412
-620 | 0.5785
-604 | 0.5475
-588 | 0.5968
-572 | 0.5722
-556 | 0.4323
-540 | 0.5165
-524 | 0.4943
-508 | 0.5652
-492 | 0.7103
-476 | 0.7164
-460 | 0.814
-444 | 1.0549
-428 | 1.6584
-412 | 2.3959
-396 | 3.4479
-380 | 4.591
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
