LLLIO400/PSoC-Potentiostat/layout_preview/calibration.png

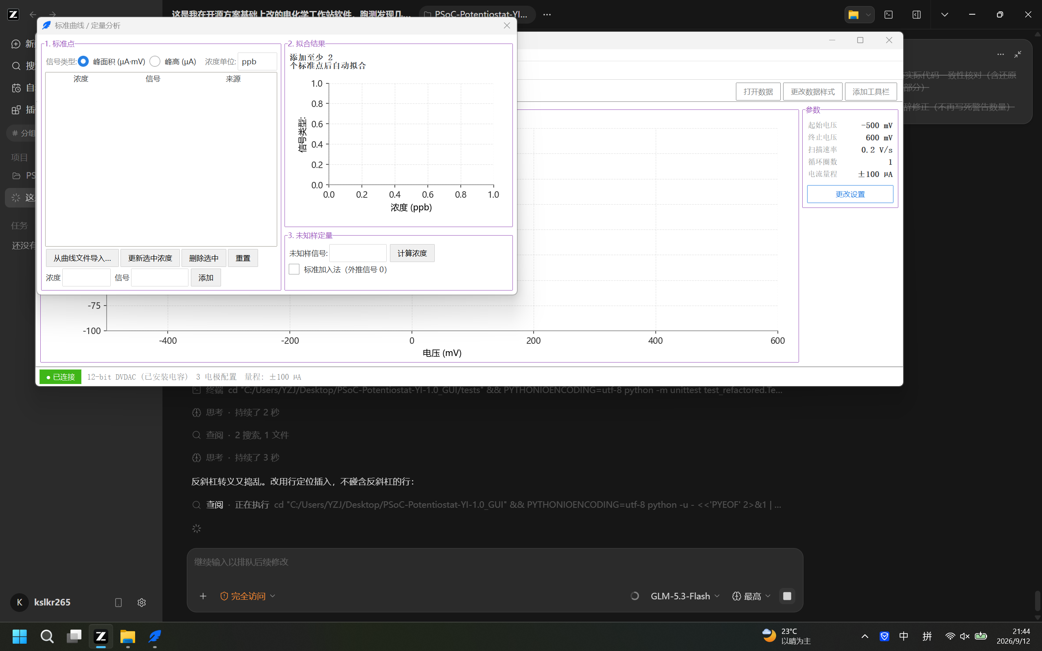
layout_preview/calibration.png
