LLLIO400/PSoC-Potentiostat/实验记录/verify_multicycle_20261013_111652.png

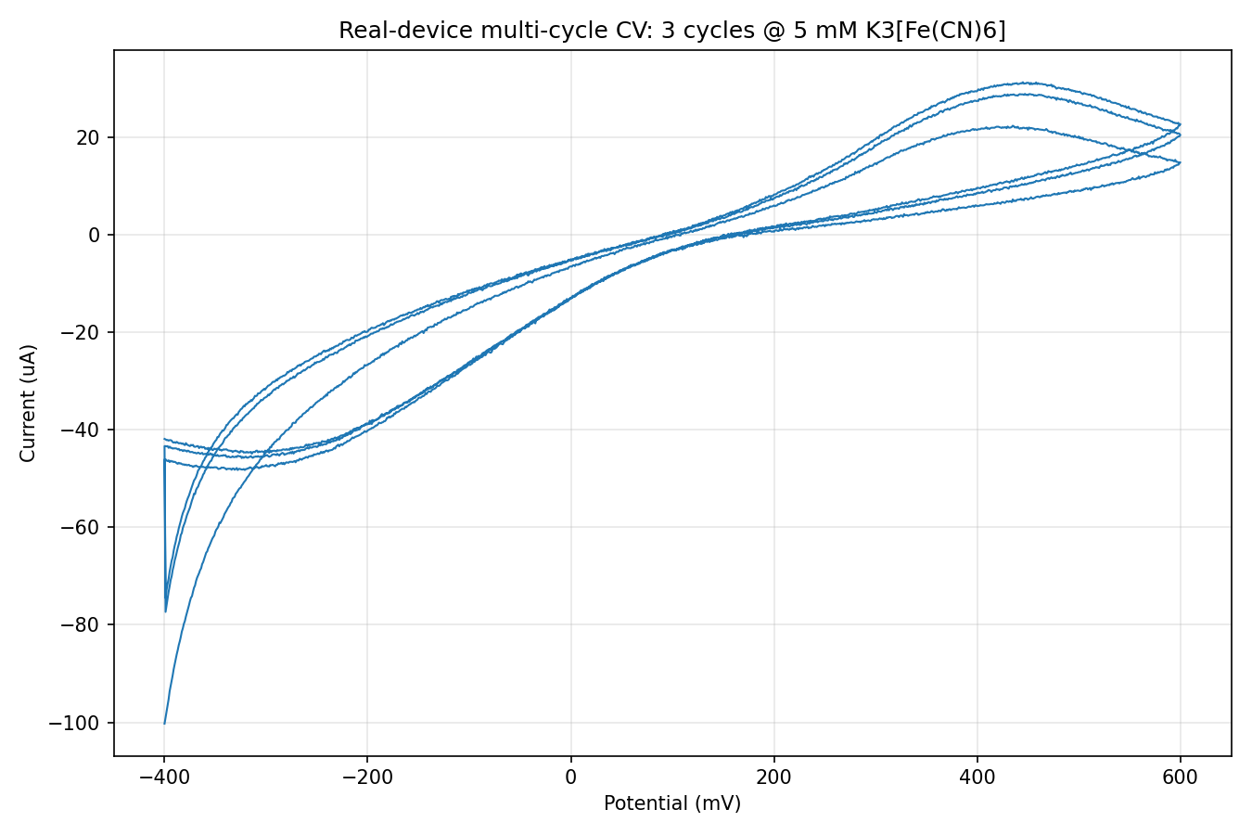
实验记录/verify_multicycle_20261013_111652.png
