LLLIO400/PSoC-Potentiostat/实验记录/verify_patched_20261013_123048.png

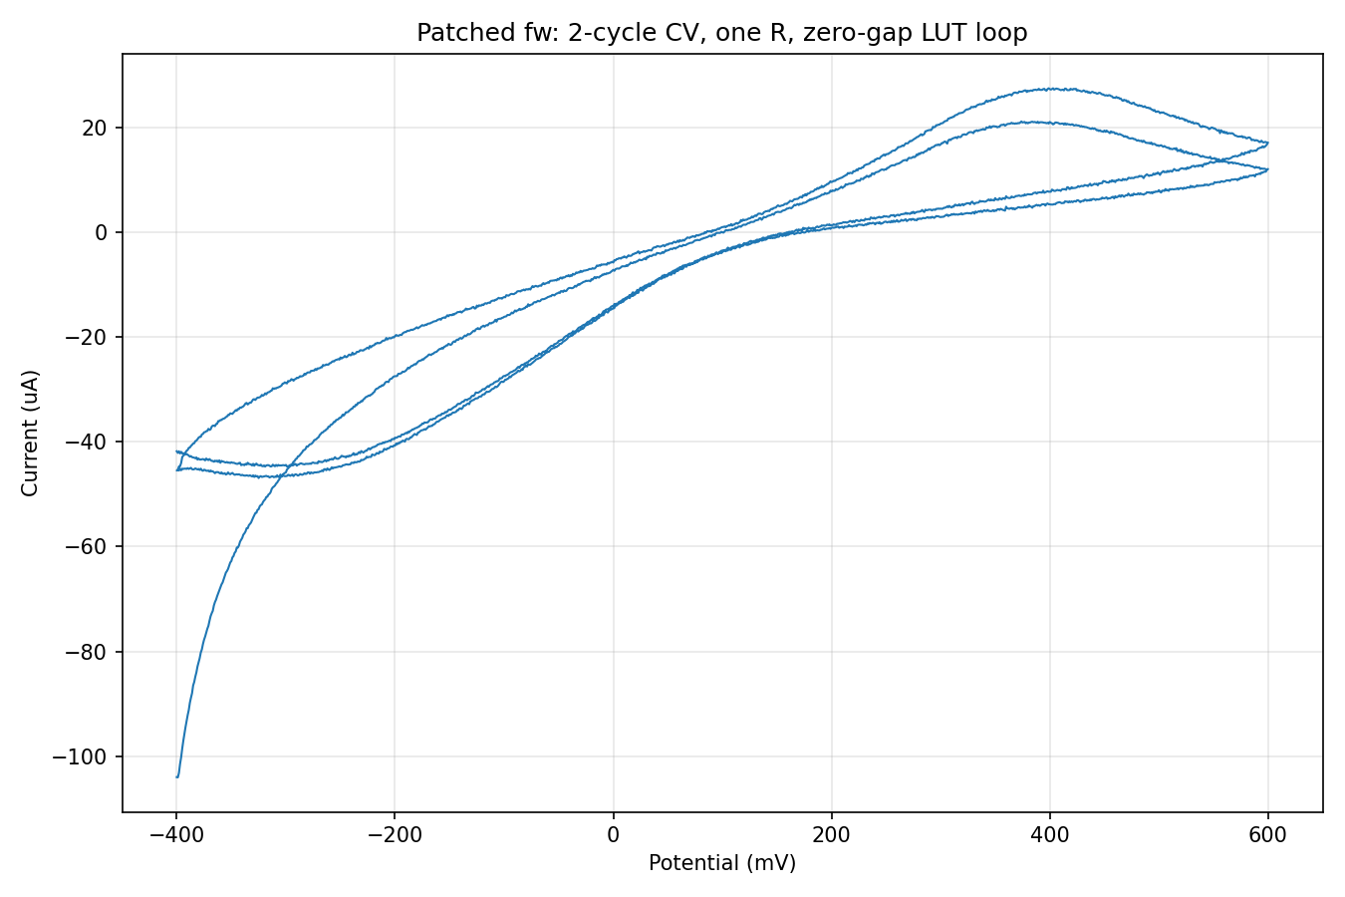
实验记录/verify_patched_20261013_123048.png
