LLLIO400/PSoC-Potentiostat/firmware_patch/globals.h

/*******************************************************************************
* File Name: globals.h
*
* Description:
*  Global variables, unions and structures to use in the project
*
**********************************************************************************
 * Copyright Naresuan University, Phitsanulok Thailand
 * Released under Creative Commons Attribution-ShareAlike  3.0 (CC BY-SA 3.0 US)
*********************************************************************************/

#if !defined(GLOBALS_H)
#define GLOBALS_H
    
#include "cytypes.h"
#include "stdio.h"  // gets rid of the type errors

/**************************************
*        USB INPUT OPTIONS
**************************************/ 
    
#define EXPORT_LUT_LENGTH               'g'
#define EXPORT_LUT                      'l'
#define EXPORT_STREAMING_DATA           'F'
#define EXPORT_ADC_ARRAY                'E'
#define CALIBRATE_TIA_ADC               'B'
#define SET_PWM_TIMER_COMPARE           'C'
#define SET_PWM_TIMER_PERIOD            'T'
#define SET_TIA_ADC                     'A'
#define CHECK_VOLTAGE_SOURCE            'V'
#define START_CYCLIC_VOLTAMMETRY        'R'
#define RESET_DEVICE                    'X'
#define DEVICE_IDENTIFY                 'I'
#define CHANGE_NUMBER_ELECTRODES        'L'
#define CHRONOAMPEROMETRY_HACK          'Q'
#define MAKE_LOOK_UP_TABLE              'S'
#define SET_DAC_VALUE                   'D'
#define RUN_AMPEROMETRY                 'M'
#define START_HARDWARE                  'H'
#define SHORT_TIA                       's'
#define STOP_SHORTING_TIA               'd'
#define DPV_LUT                         'G'
#define STIRRING_CONTROL                'O'
#define DPV_PULSE_LUT                   'P'
    
// index of start of different parts of input string
#define INDEX_START_VALUE               2
#define INDEX_END_VALUE                 7
#define INDEX_TIMER_VALUE               12
#define INDEX_SWEEP_TYPE                18
#define INDEX_START_VOLT_TYPE           19
// Square wave voltammertry options
#define INDEX_SWV_INC                   12
#define INDEX_SWV_PULSE_HEIGHT          17
#define INDEX_SWV_TIMER_VALUE           23
#define INDEX_SWV_SWEEP_TYPE            28
#define INDEX_SWV_START_VOLT_TYPE       29


/**************************************
*           ADC Constants
**************************************/  
    
// define how big to make the arrays for the lut for dac and how big
// to make the adc data array     
#define MAX_LUT_SIZE 5000
#define ADC_CHANNELS 4
 
    
/**************************************
*           API Constants
**************************************/
#define true                        1
#define false                       0
    
#define VIRTUAL_GROUND              2048  // TODO: make variable

// Define the AMux channels
#define two_electrode_config_ch     0
#define three_electrode_config_ch   1 
#define AMux_V_VDAC_source_ch       0
#define AMux_V_DVDAC_source_ch      1
#define AMux_TIA_working_electrode_ch 1

/**************************************
*        EEPROM API Constants
**************************************/

#define VDAC_NOT_SET 0
#define VDAC_IS_VDAC 1
#define VDAC_IS_DVDAC 2
    
#define VDAC_ADDRESS 0
    
#define EEPROM_READ_TEMPERATURE_CORRECT        0
    
    
/**************************************
*        AMuX API Constants
**************************************/
    
//#define DVDAC_channel 1
//#define VDAC_channel 0
    
    
/**************************************
*        Global Variables
**************************************/   
    
uint16_t dac_ground_value;  // value to load in the DAC
    
/* Make global variables needed for the DAC/ADC interrupt service routines */
uint16_t lut_value;  // value need to load DAC
// add 5 to the lut to add a buffer cause a few functions go over the MAX_LUT_SIZE
// by 1, and will use MAX_LUT_SIZE to check for over runs
uint16_t waveform_lut[MAX_LUT_SIZE+5];  // look up table to store waveform for variable potential experiments
union waveform_lut_union {
    uint8_t usb[2*(MAX_LUT_SIZE+5)];
    int16_t data[MAX_LUT_SIZE+5];
};
    
uint16_t lut_index;  // look up table index

/* Global structs */

union data_usb_union {
    uint8_t usb[2*MAX_LUT_SIZE];
    int16_t data[MAX_LUT_SIZE];
};
union data_usb_union ADC_array[ADC_CHANNELS];  // allocate space to put adc measurements
    
struct TIAMux {  // not used currently
    uint8_t use_extra_resistor;
    uint8_t user_channel;
};
struct TIAMux tia_mux;

//struct RunParams {
//    uint16_t start_value;
//    uint16_t end_value;
//    uint8 sweep_type;  // Can be C - cyclic voltammetry, or L for linear sweep
//    // Can be S for start voltage (triange shape sweep) or Z for starting at zero volts
//    uint8 start_volt_type;  
//    uint8 use_swv;
//    uint16_t swv_inc;
//    uint16_t swv_pulse_height;
//    uint16_t timer_period;
//};// run_params_default = {500, 1000, 'C', 'S', false, 10, 100, 20000};
//
//struct RunParams run_params;

struct RunParams {
    uint16_t start_value;
    uint16_t end_value;
    uint8_t sweep_type;  // Can be C - cyclic voltammetry, or L for linear sweep
    // Can be S for start voltage (triange shape sweep) or Z for starting at zero volts
    uint8_t start_volt_type;
    uint8_t use_swv;
    uint16_t swv_inc;
    uint16_t swv_pulse_height;
    uint16_t timer_period;
};

struct RunParams run_params;

// Use the print statements in the tests, but not on the hardware
#ifndef TESTING
    #define printf(fmt, ...) (0)
#endif


#endif    
/* [] END OF FILE */
