LLLIO400/PSoC-Potentiostat/i18n.py

# Copyright (c) 2026 Zhijian Yi (Guangdong, China) — PSoC-Potentiostat-YI-1.0
# Licensed under CC BY-SA 3.0 (same as the upstream PSoC-Potentiostat project)

"""Internationalization (i18n) support
Default language: Chinese (zh)
Supported: Chinese (zh), English (en)
"""

TEXTS = {
    "zh": {
        # 应用
        "app_title": "电化学工作站",

        # 菜单
        "menu_file": "文件",
        "menu_data": "数据",
        "menu_options": "选项",
        "menu_developers": "开发者选项",
        "menu_about": "关于",
        "menu_language": "语言 (Language)",
        "menu_language_zh": "中文",
        "menu_language_en": "English",

        # 文件菜单
        "file_open": "打开",
        "file_save_all": "保存当前页所有数据",
        "file_select_save": "选择数据保存",
        "file_quit": "退出",
        "file_csv": "逗号分隔值",
        "file_all": "所有文件",
        "open_failed_title": "无法打开文件",
        "open_failed_msg": "无法识别该文件的数据格式。\n请打开本软件保存的 CSV 数据文件，\n或包含 voltage/current 两列表头的 CSV 文件。",

        # 数据菜单
        "data_delete_all": "删除当前页数据轨迹",
        "data_set_label": "扫描后设置数据标签",

        # 选项菜单
        "options_add_tia": "添加自定义 TIA 电阻",

        # 标签页
        "tab_cv": "循环伏安法 (CV)",
        "tab_ls": "线性扫描 (LS)",
        "tab_swv": "方波 (SWV)",
        "tab_dpv": "差分脉冲 (DPV)",
        "tab_amp": "计时电流法 (Amp)",
        "tab_asv": "阳极溶出伏安法 (ASV)",

        # CV 面板
        "cv_title": "循环伏安法设置:",
        "ls_title": "线性扫描设置:",
        "cv_run": "运行 CV 扫描",
        "ls_run": "运行 LS 扫描",
        "swv_run": "运行 SWV 扫描",
        "dpv_run": "运行 DPV 扫描",
        # 扫描进行中的通用「停止」按钮（各页共用，勿用 asv_stop——那是 ASV 页专属）
        "stop": "停止",
        "cv_save": "保存数据",
        "cv_change_style": "更改数据样式",
        "cv_delete": "删除数据",
        "cv_add_toolbar": "添加工具栏",
        "cv_read_msg": "读取消息",
        "cv_chronoamp": "计时电流",
        "cv_change_settings": "更改设置",

        # Amp 面板
        "amp_title": "计时电流法设置:",
        "amp_start": "开始计时电流",
        "amp_stop": "停止计时电流",
        "amp_save": "保存数据",
        "amp_change_settings": "更改设置",

        # ASV 面板
        "asv_title": "阳极溶出伏安法设置:",
        "asv_run": "运行 ASV",
        "asv_stop": "停止 ASV",
        "asv_change_settings": "更改设置",

        # 设置对话框
        "settings_title": "设置",
        "settings_sweep_type": "扫描类型",
        "settings_sweep_ls": "线性扫描 (LS)",
        "settings_sweep_dpv": "差分脉冲 (DPV)",
        "settings_sweep_swv": "方波 (SWV)",
        "settings_start_voltage": "起始电压 (mV)",
        "settings_end_voltage": "终止电压 (mV)",
        "settings_sweep_rate": "扫描速率 (V/s)",
        "settings_sample_rate": "采样率 (Hz)",
        "settings_ok": "确定",
        "settings_cancel": "取消",

        # 电压源
        "vsource_vdac": "8-bit VDAC (未安装电容)",
        "vsource_dvdac": "12-bit DVDAC (已安装电容)",
        "vsource_unknown": "不确定 (默认)",

        # 电极配置
        "electrode_3": "3 电极配置",
        "electrode_2": "2 电极配置",
        "electrode_config_msg": "{0} 电极配置",

        # 状态
        "status_connected": "已连接",
        "status_found_not_connected": "找到但未连接",
        "status_not_found": "未找到设备",
        "status_no_device": "无设备",

        # 时间提示
        "time_cleaning_left": "清洗时间剩余: {0}（搅拌中）",
        "time_plating_left": "富集时间剩余: {0}（搅拌中）",
        "time_resting_left": "静置时间剩余: {0}（搅拌已停止）",
        "time_total_left": "总时间剩余: {0}",

        # 数据标签
        "data_label": "数据 {}",
        "data_no_voltage": "尚未选择电压",
        "data_default": "默认",
        "data_save_options": "保存数据选项",
        "data_series_title": "数据系列",
        "data_select_delete": "选择要删除的数据",
        "confirm_delete": "删除选中的数据?",

        # 其他
        "toplevel": "顶层窗口",
        "true": "是",
        "false": "否",

        # 开发者菜单
        "dev_choose_channel": "选择导出通道",
        "dev_choose_data": "选择数据导出",
        "dev_converted_data": "转换后数据",
        "dev_raw_data": "原始 ADC 数据",
        "dev_get_channel": "获取通道数据（未启用）",
        "lut_title": "查找表 (LUT) 内容",
        "lut_empty": "未读到 LUT 数据（设备未连接或固件未应答）",
        "dev_channel": "通道 ",
        "dev_export_lut": "导出查找表",
        "dev_change_pwm": "更改 PWM 比较值",

        # 选项菜单
        "opt_electrode_config": "设置电极配置",
        "opt_2electrode": "双电极模式",
        "opt_3electrode": "三电极模式",
        "opt_voltage_source": "设置电压源",
        "opt_vdac": "VDAC (无外部电容)",
        "opt_dvdac": "DVDAC (已安装外部电容)",
        "opt_logging_comments": "输入日志注释",
        "opt_smooth_data": "平滑数据",
        "opt_values": "{0} 个值",

        # ASV 面板参数
        "asv_clean_volt": "清洗电压",
        "asv_clean_time": "清洗时间",
        "asv_plate_volt": "富集电压",
        "asv_plate_time": "富集时间",
        "asv_peak_volt": "终止电位",
        "asv_strip_start": "起始电位",
        "asv_sweep_rate": "扫描速率",
        "asv_rest_time": "富集后静置",
        "asv_stirring": "自动搅拌",
        "asv_stirring_on": "开",
        "asv_stirring_off": "关",
        "asv_enable_clean": "启用清洗步骤（一次性电极可不选）",
        "asv_clean_off": "清洗步骤: 已关闭",
        "asv_enable_stirring": "富集/清洗时搅拌 (P2.0)",
        "asv_clean_after_strip": "溶出后自动清洗（沿用上方清洗电压/时间）",
        "btn_select_region": "框选峰区域",
        "btn_smooth": "平滑 (SG)",
        "btn_baseline": "基线扣除",
        "btn_find_peaks": "自动寻峰",
        "title_peak_analysis": "峰分析结果",
        "peak_result": "峰位: {0} mV，峰高: {1} µA，半峰宽: {2} mV",
        "peak_result_full": "峰{0}: 峰位 {1} mV，峰高 {2} µA，半峰宽 {3} mV，面积 {4:.3g} µA·mV，电量 {5:.3g} µC",
        "curve_math": "曲线运算…",
        "curve_op_subtract": "相减 (A − B)",
        "curve_op_average": "平均 ((A + B) / 2)",
        "curve_op_normalize": "归一化 (A / max|A|)",
        "curve_a": "曲线 A:",
        "curve_b": "曲线 B:",
        "curve_need": "该运算需要当前页至少 {0} 条曲线",
        "curve_result": "结果",
        "no_peak_found": "未检测到峰",
        "btn_restore": "还原曲线",
        "restore_none": "当前曲线没有被修改过，无需还原。\n（只有对最新一条曲线做过平滑/基线扣除后才能还原）",
        "restore_done": "已还原为原始数据。",
        "region_hint_title": "框选峰区域",
        "region_hint": "已进入框选模式：在图上按住左键横向拖出峰所在的电压区间，\n"
                       "松开后区间即生效（蓝色阴影区域）。\n\n"
                       "该区间的作用：\n"
                       "• 基线扣除：只用区间外的数据拟合基线，峰不会被当成基线\n"
                       "• 自动寻峰：只在区间内找峰\n\n"
                       "再点一次“框选峰区域”按钮可退出框选模式。",
        "data_delete_hint": "勾选要删除的曲线，再点“是”确认删除：",
        "grp_basic": "基本参数",
        "grp_sweep": "扫描设置",
        "grp_swv": "方波参数",
        "grp_clean": "清洗步骤",
        "grp_plate": "富集步骤",
        "grp_strip": "溶出步骤",
        "grp_pulse": "脉冲参数（DPV/SWV）",
        "grp_general": "通用",
        "scan_progress_title": "扫描进行中",
        "scan_progress_msg": "正在扫描，请稍候（约 {0} 秒）…\n扫描完成后曲线将自动显示。",
        "scan_progress_left": "正在扫描，剩余约 {0} 秒",
        "scan_finishing": "扫描完成，正在处理数据…",
        "asv_data_error_title": "数据读取失败",
        "asv_data_error_msg": "读取或显示扫描数据时出错：\n{0}\n\n请检查设备连接后重试。",
        "title_invalid_params": "参数无效",
        "err_pulse_height": "脉冲高度必须大于 0 mV",
        "err_pulse_inc": "脉冲增量必须大于 0 mV",
        "err_pulse_width": "脉冲周期必须不小于 10 ms",
        "err_scan_range": "扫描范围（|峰值电压 − 富集电压|）必须不小于脉冲增量",
        "err_invalid_number": "存在无法解析的数字输入，请检查各参数",
        "asv_current_range": "电流范围",
        "asv_sweep_type": "扫描类型",

        # CV 面板参数
        "cv_start_volt": "起始电压",
        "cv_end_volt": "终止电压",
        "cv_sweep_rate": "扫描速率",
        "cv_sample_rate": "采样率",

        # Amp 面板参数
        "amp_voltage": "电压",
        "amp_sample_rate": "采样率",

        # 图表标题
        "chart_cv_title": "循环伏安法",
        "chart_ls_title": "线性扫描",
        "chart_swv_title": "方波伏安法",
        "chart_amp_title": "计时电流法",
        "chart_asv_title": "阳极溶出伏安法",

        # 坐标轴
        "axis_current": "电流 (μA)",
        "axis_voltage": "电压 (mV)",
        "axis_time": "时间 (秒)",
        "cv_current_range": "电流范围: ± {0:.1f} μA",
        "cv_use_swv": "使用方波伏安法: {0}",
        "cv_pulse_height": "脉冲高度: {0} mV",
        "cv_step_increment": "步进增量: {0} mV",
        "cv_pulse_period": "脉冲周期: {0} ms",
        "cv_settings_title": "更改循环伏安法设置",
        "ls_settings_title": "更改线性扫描设置",
        "swv_settings_title": "更改方波伏安法设置",
        "dpv_settings_title": "更改差分脉冲伏安法设置",
        "swv_title": "方波伏安法设置:",
        "dpv_title": "差分脉冲伏安法设置:",
        "amp_current_range": "电流范围: ± {0:.1f} μA",
        "amp_settings_title": "更改计时电流法设置",
        "asv_change_settings_btn": "更改设置",
        "amp_change_settings_btn": "更改设置",
        "asv_settings_title": "更改阳极溶出伏安法设置",
        "asv_stripping_ls": "扫描类型: 线性扫描",
        "asv_stripping_dpv": "扫描类型: 差分脉冲",
        "asv_stripping_swv": "扫描类型: 方波",
        "settings_current_range": "电流范围: ",
        "settings_use_swv": "使用方波",
        "settings_swv_height": "方波高度: ",
        "settings_swv_increment": "方波增量: ",
        "settings_swv_period": "方波周期: ",
        "settings_preview": "预览电压波形",
        "settings_save": "保存更改",
        "settings_exit": "退出",
        "settings_sweep_type_label": "扫描类型: ",
        "settings_start_zero": "0 V",
        "settings_start_start": "起始电压",
        "btn_save": "保存",
        "btn_exit": "退出",
        "btn_yes": "是",
        "btn_no": "否",
        "btn_quit": "退出",
        "btn_delete": "删除",
        "label_color": "选择颜色:",
        "label_change_label": "更改数据标签:",
        "label_data_label": "数据标签: ",
        "label_notes": "备注:",
        "title_delete_all": "删除当前页数据",
        "msg_delete_all": "确定要删除当前页面记录的数据吗？",
        "btn_dont_delete": "不删除",
        "title_logging": "日志信息",
        "msg_logging": "输入要记录的信息",
        "title_custom_tia": "使用自定义 TIA 电阻",
        "title_pwm_compare": "更改 PWM 定时比较值",
        "msg_pwm_compare": "输入要放入定时 PWM 比较寄存器的值",
        "msg_pwm_current": "当前值为 ",
        "title_restart": "需要重启",
        "msg_restart1": "程序需要重启",
        "msg_restart2": "以应用更改",
        "timer_toplevel": "计时器",
        "custom_tia_desc": "输入自定义 TIA 电阻值和连接的通道",
        "custom_tia_value": "输入自定义 TIA 电阻值 (kΩ)",
        "msg_pwm_range": "值必须在 500 和 {0} 之间",
        "data_legend_title": "配置数据图例",
        "voltage_profile_title": "电压波形",
        "pulse_height": "脉冲高度:",
        "pulse_increment": "脉冲增量:",
        "pulse_width": "脉冲宽度/周期:",
        "pulse_period": "脉冲周期:",
        # ---- 本轮新增：CV 多圈 / 数据饱和提示 / 溶出参数对齐 / 布局改版 ----
        "grp_params": "参数",
        "settings_cycles": "循环圈数",
        "settings_cycles_hint": "CV 三角波循环圈数（1–9）：容量内零间隙连续循环，超出容量自动改用软件逐圈衔接（圈间约 1 s）",
        "cv_capacity_fallback_title": "多圈调度提示",
        "cv_capacity_fallback_msg": "循环圈数 {0} 超出当前电位范围的波形表容量（最多约 {1} 圈），本次将改用软件逐圈调度自动跑满 {0} 圈，圈间约停 1 秒，无需手动操作。",
        "settings_quiet_time": "扫描前静置 (秒)",
        "settings_quiet_time_hint": "先跳到起始电位等待暂态衰减再开扫，消除起点负漂/削顶；0 = 关闭",
        "err_lut_capacity": "循环圈数超出波形表容量：当前电位范围最多约 {0} 圈，请减小圈数或电位范围",
        "err_strip_range": "溶出起始电位必须低于终止电位（阳极方向扫描）",
        "saturation_title": "数据饱和提示",
        "saturation_msg": "本次扫描有 {0}% 的采样点触及 ADC 量程极限。\n曲线平头是数据被量程削平，调显示范围无法恢复。\n请在设置中选择更大的电流量程（更不敏感）后重新扫描。",
        "asv_stripping_method": "溶出方式",
        "asv_pulse_hint": "与独立 DPV/SWV 页同一套参数，周期 = 每步总时长",
        "settings_dpv_height": "脉冲幅度: ",
        "settings_dpv_increment": "脉冲增量: ",
        "settings_dpv_period": "脉冲周期: ",
        "param_current_range": "电流量程",
        "ribbon_open": "打开数据",
        "simulate_mode": "模拟模式（无需硬件，即时生效）",
        "opt_theme": "主题",
        "theme_cosmo": "浅色 Cosmo",
        "theme_darkly": "深色 Darkly",
        "theme_superhero": "深色 Superhero",
        "file_json": "JSON 方法文件",
        "method_save": "保存方法文件…",
        "method_load": "加载方法文件…",
        "status_simulate": "模拟模式",
        "simulate_device": "模拟器（无硬件）",
        "simulate_need_tests": "模拟模式需要测试包文件 tests/fake_device.py，当前未找到。",
        "simulate_busy": "有扫描或计时正在进行，请先停止后再切换模拟模式。",
        "simulate_on": "已切换到模拟模式（无需硬件）。",
        "simulate_off": "已切换到真实设备模式。",
        "export_peaks": "导出峰结果…",
        "calibration_title": "标准曲线 / 定量分析",
        "calibration_signal": "信号类型:",
        "calibration_signal_area": "峰面积 (µA·mV)",
        "calibration_signal_height": "峰高 (µA)",
        "calibration_unit": "浓度单位:",
        "calibration_conc": "浓度",
        "calibration_signal_head": "信号",
        "calibration_import": "从曲线文件导入…",
        "calibration_import_done": "已导入 {0} 条曲线的标准点，请补填各点浓度",
        "calibration_delete": "删除选中",
        "calibration_add": "添加",
        "calibration_points_group": "1. 标准点",
        "calibration_fit_group": "2. 拟合结果",
        "calibration_unknown_group": "3. 未知样定量",
        "calibration_source": "来源",
        "calibration_update_conc": "更新选中浓度",
        "calibration_pending": "待填",
        "calibration_pending_hint": "（{0} 个点待补浓度：选中行，在左侧输入浓度，点「更新选中浓度」）",
        "calibration_bad_format": "无法识别的文件格式（需要两列数值的曲线 CSV）",
        "calibration_no_data": "未读取到数据",
        "calibration_relaxed": "（峰不明显，取基线扣除后最大值，请核对）",
        "calibration_import_summary": "导入 {0} 个文件：成功 {1}，失败 {2}\n{3}",
        "calibration_pick_row": "请先在表中选择一行",
        "calibration_need_fit": "添加至少 2 个标准点后自动拟合",
        "calibration_fit_text": "y = {0:.6g}·x + {1:.6g}    R² = {2:.5f}",
        "calibration_unknown": "未知样信号:",
        "calibration_calc": "计算浓度",
        "calibration_addition": "标准加入法（外推信号 0）",
        "calibration_points": "标准点",
        "peak_half_width": "半峰宽",
        "export_peaks_none": "请先执行自动寻峰（或打开含峰的曲线）。",
        "data_delete_page": "删除当前页数据…",
        "menu_analysis": "数据分析（当前页）",
        "analysis_unavailable": "当前页面没有曲线分析功能",
        "data_none": "当前页没有可删除的数据",
        "strip_ls": "线性扫描",
        "strip_dpv": "差分脉冲",
        "strip_swv": "方波",
        "dev_current_sign": "电流符号（诊断）",
        "dev_sign_normal": "正常（氧化电流为正，默认）",
        "dev_sign_inverted": "反相（前端输出反相的机器用）",
        "status_current_range": "量程",
        "about_text": "Developed at Naresuan University\nby Kyle Vitautas Lopin\n\nPSoC-Potentiostat-YI-1.0 GUI upgrade & maintenance:\nZhijian Yi, Guangdong, China",
        "amp_start_btn": "开始计时电流",
        "amp_stop_btn": "停止计时电流",
        "amp_save_btn": "保存数据",
        "asv_start_btn": "运行 ASV",
        "asv_stop_btn": "停止 ASV",
        "cv_start_btn": "运行 CV 扫描",
        "cv_save_btn": "保存数据",
        "cv_change_style_btn": "更改数据样式",
        "cv_delete_btn": "删除数据",
        "cv_add_toolbar_btn": "添加工具栏",
        "cv_change_settings_btn": "更改设置",

        # 工具栏悬停提示 (matplotlib NavigationToolbar)
        "toolbar_home": "复位到初始视图",
        "toolbar_back": "返回上一个视图",
        "toolbar_forward": "前进到下一个视图",
        "toolbar_pan": "左键平移，右键缩放\nx/y 锁定坐标轴，CTRL 锁定纵横比",
        "toolbar_zoom": "框选缩放\nx/y 锁定坐标轴",
        "toolbar_subplots": "调整子图边距",
        "toolbar_save": "保存图像",

        # 子图边距调整窗口 (matplotlib SubplotTool)
        "subplot_tool_title": "子图边距调整",
        "subplot_tool_hint": "拖动滑块调整子图布局",
        "subplot_left": "左",
        "subplot_bottom": "下",
        "subplot_right": "右",
        "subplot_top": "上",
        "subplot_wspace": "水平间距",
        "subplot_hspace": "垂直间距",
        "btn_reset": "重置",
        "mode_pan_zoom": "平移/缩放",
        "mode_zoom_rect": "框选缩放",
        "save_figure_title": "保存图像",
        "save_error_title": "保存文件出错",
    },

    "en": {
        # App
        "app_title": "Amperometry Device",

        # Menu
        "menu_file": "File",
        "menu_data": "Data",
        "menu_options": "Options",
        "menu_developers": "Developer Options",
        "menu_about": "About",
        "menu_language": "Language (语言)",
        "menu_language_zh": "中文",
        "menu_language_en": "English",

        # File menu
        "file_open": "Open",
        "file_save_all": "Save Current Page Data",
        "file_select_save": "Select Data to Save",
        "file_quit": "Quit",
        "file_csv": "Comma separate values",
        "file_all": "All files",
        "open_failed_title": "Cannot Open File",
        "open_failed_msg": "Unrecognized data format.\nPlease open a CSV file saved by this program,\nor a CSV with a voltage/current two-column header.",

        # Data menu
        "data_delete_all": "Delete current page data traces",
        "data_set_label": "Set data label after a scan",

        # Options menu
        "options_add_tia": "Add custom TIA resistor",

        # Tabs
        "tab_cv": "Cyclic Voltammetry",
        "tab_ls": "Linear Sweep (LS)",
        "tab_swv": "Square Wave (SWV)",
        "tab_dpv": "Pulse (DPV)",
        "tab_amp": "Amperometry",
        "tab_asv": "Anode Stripping Voltammetry",

        # CV panel
        "cv_title": "Cyclic Voltammetry settings:",
        "ls_title": "Linear Sweep settings:",
        "cv_run": "Run CV Scan",
        "ls_run": "Run LS Scan",
        "swv_run": "Run SWV Scan",
        "dpv_run": "Run DPV Scan",
        # Generic "Stop" while a scan is running (shared by all tabs;
        # do not reuse asv_stop — that is ASV-tab specific)
        "stop": "Stop",
        "cv_save": "Save data",
        "cv_change_style": "Change data style",
        "cv_delete": "Delete Data",
        "cv_add_toolbar": "Add toolbar",
        "cv_read_msg": "Read Message",
        "cv_chronoamp": "Chronoamp",
        "cv_change_settings": "Change Settings",

        # Amp panel
        "amp_title": "Amperometry settings:",
        "amp_start": "Start Amperometry",
        "amp_stop": "Stop Amperometry",
        "amp_save": "Save Data",
        "amp_change_settings": "Change Settings",

        # ASV panel
        "asv_title": "Anode Stripping Voltammetry settings:",
        "asv_run": "Run ASV",
        "asv_stop": "Stop ASV",
        "asv_change_settings": "Change Settings",

        # Settings dialog
        "settings_title": "Settings",
        "settings_sweep_type": "Sweep type",
        "settings_sweep_ls": "Linear Sweep (LS)",
        "settings_sweep_dpv": "Differential Pulse (DPV)",
        "settings_sweep_swv": "Square Wave (SWV)",
        "settings_start_voltage": "Start voltage (mV)",
        "settings_end_voltage": "End voltage (mV)",
        "settings_sweep_rate": "Sweep rate (V/s)",
        "settings_sample_rate": "Sample rate (Hz)",
        "settings_ok": "OK",
        "settings_cancel": "Cancel",

        # Voltage source
        "vsource_vdac": "8-bit VDAC (no capacitor)",
        "vsource_dvdac": "12-bit DVDAC (capacitor installed)",
        "vsource_unknown": "Not sure (default)",

        # Electrode config
        "electrode_3": "3 electrode configuration",
        "electrode_2": "2 electrode configuration",
        "electrode_config_msg": "{0} electrode configuration",

        # Status
        "status_connected": "Connected",
        "status_found_not_connected": "Found but not connected",
        "status_not_found": "Device Not Found",
        "status_no_device": "No Device",

        # Time hints
        "time_cleaning_left": "Cleaning time left: {0} (stirring)",
        "time_plating_left": "Plating time left: {0} (stirring)",
        "time_resting_left": "Resting time left: {0} (stirring stopped)",
        "time_total_left": "Total time left: {0}",

        # Data labels
        "data_label": "data {}",
        "data_no_voltage": "No voltage selected yet",
        "data_default": "Default",
        "data_save_options": "Save data options",
        "data_series_title": "Data series",
        "data_select_delete": "Select data to delete",
        "confirm_delete": "Delete selected data?",

        # Other
        "toplevel": "toplevel",
        "true": "True",
        "false": "False",

        # Developer menu
        "dev_choose_channel": "Choose channel to export",
        "dev_choose_data": "Choose data export",
        "dev_converted_data": "Converted data",
        "dev_raw_data": "Raw ADC data",
        "dev_get_channel": "Get channel data (not enabled)",
        "lut_title": "Lookup Table (LUT) Contents",
        "lut_empty": "No LUT data read (device not connected or no firmware response)",
        "dev_channel": "channel ",
        "dev_export_lut": "Export the look up table",
        "dev_change_pwm": "Change timing PWM compare value",

        # Options menu
        "opt_electrode_config": "Set Electrode Configuration",
        "opt_2electrode": "Two electrode setting",
        "opt_3electrode": "Three electrode setting",
        "opt_voltage_source": "Set voltage source",
        "opt_vdac": "VDAC (no external capacitor)",
        "opt_dvdac": "DVDAC (external capacitor added)",
        "opt_logging_comments": "Enter comments into logging file",
        "opt_smooth_data": "Smooth data",
        "opt_values": "{0} values",

        # ASV panel parameters
        "asv_clean_volt": "Cleaning voltage",
        "asv_clean_time": "Cleaning time",
        "asv_plate_volt": "Plating voltage",
        "asv_plate_time": "Plating time",
        "asv_peak_volt": "End potential",
        "asv_strip_start": "Start potential",
        "asv_sweep_rate": "Sweep rate",
        "asv_rest_time": "Rest after deposition",
        "asv_stirring": "Auto stirring",
        "asv_stirring_on": "On",
        "asv_stirring_off": "Off",
        "asv_enable_clean": "Enable cleaning step (optional for disposable SPE)",
        "asv_clean_off": "Cleaning step: Off",
        "asv_enable_stirring": "Stir during plating/cleaning (P2.0)",
        "asv_clean_after_strip": "Auto-clean after stripping (uses cleaning params above)",
        "btn_select_region": "Select peak region",
        "btn_smooth": "Smooth (SG)",
        "btn_baseline": "Baseline subtract",
        "btn_find_peaks": "Find peaks",
        "title_peak_analysis": "Peak analysis",
        "peak_result": "Peak: {0} mV, height: {1} µA, half width: {2} mV",
        "peak_result_full": "Peak {0}: E {1} mV, Ip {2} µA, W1/2 {3} mV, area {4:.3g} µA·mV, charge {5:.3g} µC",
        "curve_math": "Curve Math…",
        "curve_op_subtract": "Subtract (A − B)",
        "curve_op_average": "Average ((A + B) / 2)",
        "curve_op_normalize": "Normalize (A / max|A|)",
        "curve_a": "Curve A:",
        "curve_b": "Curve B:",
        "curve_need": "This operation needs at least {0} curves on the page",
        "curve_result": "Result",
        "no_peak_found": "No peak detected",
        "btn_restore": "Restore curve",
        "restore_none": "The latest curve has not been modified.\n(Restore is available after smoothing/baseline subtraction.)",
        "restore_done": "Original data restored.",
        "region_hint_title": "Select Peak Region",
        "region_hint": "Region selection is ON: drag horizontally on the graph\n"
                       "to mark the voltage range containing the peak.\n\n"
                       "The region is used by:\n"
                       "• Baseline subtraction: fits baseline only outside the region\n"
                       "• Peak finding: searches only inside the region\n\n"
                       "Click the button again to exit selection mode.",
        "data_delete_hint": "Check the curves to delete, then click Yes:",
        "grp_basic": "Basic parameters",
        "grp_sweep": "Sweep settings",
        "grp_swv": "Square wave parameters",
        "grp_clean": "Cleaning step",
        "grp_plate": "Plating step",
        "grp_strip": "Stripping step",
        "grp_pulse": "Pulse parameters (DPV/SWV)",
        "grp_general": "General",
        "scan_progress_title": "Scanning",
        "scan_progress_msg": "Scan in progress, please wait (~{0} s)…\nThe curve will appear automatically when done.",
        "scan_progress_left": "Scanning, ~{0} s remaining",
        "scan_finishing": "Scan complete, processing data…",
        "asv_data_error_title": "Data Read Error",
        "asv_data_error_msg": "Failed to read or display scan data:\n{0}\n\nCheck the device connection and retry.",
        "title_invalid_params": "Invalid parameters",
        "err_pulse_height": "Pulse height must be > 0 mV",
        "err_pulse_inc": "Pulse increment must be > 0 mV",
        "err_pulse_width": "Pulse period must be >= 10 ms",
        "err_scan_range": "Scan range (|end - plating|) must be >= pulse increment",
        "err_invalid_number": "Some parameter is not a valid number",
        "asv_current_range": "Current range",
        "asv_sweep_type": "Sweep type",

        # CV panel parameters
        "cv_start_volt": "Start voltage",
        "cv_end_volt": "End voltage",
        "cv_sweep_rate": "Sweep rate",
        "cv_sample_rate": "Sample rate",

        # Amp panel parameters
        "amp_voltage": "Voltage",
        "amp_sample_rate": "Sample rate",

        # Chart titles
        "chart_cv_title": "Cyclic Voltammetry",
        "chart_ls_title": "Linear Sweep",
        "chart_swv_title": "Square Wave Voltammetry",
        "chart_amp_title": "Amperometry",
        "chart_asv_title": "Anodic Stripping Voltammetry",

        # Axes
        "axis_current": "Current (μA)",
        "axis_voltage": "Voltage (mV)",
        "axis_time": "Time (seconds)",
        "cv_current_range": "Current range: ± {0:.1f} μA",
        "cv_use_swv": "Use SWV: {0}",
        "cv_pulse_height": "Pulse height: {0} mV",
        "cv_step_increment": "Step increment: {0} mV",
        "cv_pulse_period": "Pulse period: {0} ms",
        "cv_settings_title": "Change Cyclic Voltammetry Settings",
        "ls_settings_title": "Change Linear Sweep Settings",
        "swv_settings_title": "Change Square Wave Settings",
        "dpv_settings_title": "Change Differential Pulse Settings",
        "swv_title": "Square Wave Voltammetry settings:",
        "dpv_title": "Differential Pulse Voltammetry settings:",
        "amp_current_range": "Current range: ± {0:.1f} μA",
        "amp_settings_title": "Change Amperometry Settings",
        "asv_change_settings_btn": "Change Settings",
        "amp_change_settings_btn": "Change Settings",
        "asv_settings_title": "Change Anode Stripping Voltammetry Settings",
        "asv_stripping_ls": "Sweep type: Linear Sweep",
        "asv_stripping_dpv": "Sweep type: Differential Pulse",
        "asv_stripping_swv": "Sweep type: Square Wave",
        "settings_current_range": "Current Range: ",
        "settings_use_swv": "Use square waves",
        "settings_swv_height": "Square wave height: ",
        "settings_swv_increment": "Square wave increment: ",
        "settings_swv_period": "Square wave period: ",
        "settings_preview": "Preview voltage protocol",
        "settings_save": "Save Changes",
        "settings_exit": "Exit",
        "settings_sweep_type_label": "Voltage Sweep type: ",
        "settings_start_zero": "0 V",
        "settings_start_start": "Start Voltage",
        "btn_save": "Save",
        "btn_exit": "Exit",
        "btn_yes": "Yes",
        "btn_no": "No",
        "btn_quit": "Quit",
        "btn_delete": "Delete",
        "label_color": "Choose color:",
        "label_change_label": "Change data label:",
        "label_data_label": "Data label: ",
        "label_notes": "Notes:",
        "title_delete_all": "Delete current page data",
        "msg_delete_all": "Do you really want to delete the data on the current page?",
        "btn_dont_delete": "Don't Delete",
        "title_logging": "Logging info",
        "msg_logging": "Enter information to log",
        "title_custom_tia": "Use a custom TIA resistor",
        "title_pwm_compare": "Change PWM timing compare value",
        "msg_pwm_compare": "Enter value to place in timing PWM compare register",
        "msg_pwm_current": "Current value is ",
        "title_restart": "Program needs to be restarted",
        "msg_restart1": "Program needs to be restarted",
        "msg_restart2": "to implement changes",
        "timer_toplevel": "Timer",
        "custom_tia_desc": "Enter the custom resistor value used and the channel it is connected to",
        "custom_tia_value": "Enter custom resistor value (kohms)",
        "msg_pwm_range": "Value must be between 500 and {0}",
        "data_legend_title": "Configure Data Legend",
        "voltage_profile_title": "Voltage profile",
        "pulse_height": "Pulse height:",
        "pulse_increment": "Pulse increment:",
        "pulse_width": "Pulse width/period:",
        "pulse_period": "Pulse period:",
        # ---- New keys: CV cycles / saturation hint / ASV alignment / layout ----
        "grp_params": "Parameters",
        "settings_cycles": "Cycles",
        "settings_cycles_hint": "CV triangle cycles (1-9): zero-gap loop within waveform-table capacity, auto per-cycle chaining beyond it (~1 s between cycles)",
        "cv_capacity_fallback_title": "Multi-cycle Scheduling",
        "cv_capacity_fallback_msg": "Cycles {0} exceed the waveform-table capacity for this potential range (max ~{1} cycles). This run falls back to software per-cycle scheduling: all {0} cycles run automatically with ~1 s pause between cycles, no action needed.",
        "settings_quiet_time": "Quiet time before scan (s)",
        "settings_quiet_time_hint": "Hold at the start potential for this many seconds before scanning so jump transients decay; 0 = off",
        "err_lut_capacity": "Cycles exceed waveform table capacity: at most about {0} cycles for this potential range",
        "err_strip_range": "Stripping start potential must be below the end potential (anodic scan)",
        "saturation_title": "Data saturation",
        "saturation_msg": "{0}% of samples hit the ADC limit in this scan.\nFlat tops are clipped data - adjusting display range cannot recover them.\nSelect a larger current range (less sensitive) and rescan.",
        "asv_stripping_method": "Stripping method",
        "asv_pulse_hint": "Same set of parameters as the standalone DPV/SWV pages; period = total time per step",
        "settings_dpv_height": "Pulse amplitude: ",
        "settings_dpv_increment": "Pulse increment: ",
        "settings_dpv_period": "Pulse period: ",
        "param_current_range": "Current range",
        "ribbon_open": "Open Data",
        "simulate_mode": "Simulation mode (no hardware, applies instantly)",
        "opt_theme": "Theme",
        "theme_cosmo": "Light Cosmo",
        "theme_darkly": "Dark Darkly",
        "theme_superhero": "Dark Superhero",
        "file_json": "JSON method file",
        "method_save": "Save Method File…",
        "method_load": "Load Method File…",
        "status_simulate": "Simulation",
        "simulate_device": "Simulator (no hardware)",
        "simulate_need_tests": "Simulation mode requires tests/fake_device.py from the test pack.",
        "simulate_busy": "A scan or amperometry is running. Stop it before switching.",
        "simulate_on": "Switched to simulation mode (no hardware).",
        "simulate_off": "Switched to real device mode.",
        "export_peaks": "Export Peak Results…",
        "calibration_title": "Calibration Curve / Quantification",
        "calibration_signal": "Signal:",
        "calibration_signal_area": "Peak area (µA·mV)",
        "calibration_signal_height": "Peak height (µA)",
        "calibration_unit": "Concentration unit:",
        "calibration_conc": "Concentration",
        "calibration_signal_head": "Signal",
        "calibration_import": "Import from curve files…",
        "calibration_import_done": "Imported {0} standard points from curves; please fill in concentrations",
        "calibration_delete": "Delete selected",
        "calibration_add": "Add",
        "calibration_points_group": "1. Standard points",
        "calibration_fit_group": "2. Fit",
        "calibration_unknown_group": "3. Quantify unknown",
        "calibration_source": "Source",
        "calibration_update_conc": "Update selected conc.",
        "calibration_pending": "pending",
        "calibration_pending_hint": " ({0} point(s) pending: select a row, enter concentration, click Update)",
        "calibration_bad_format": "Unrecognized format (need a two-column numeric curve CSV)",
        "calibration_no_data": "no data read",
        "calibration_relaxed": " (weak peak: using baseline-corrected max, please verify)",
        "calibration_import_summary": "Imported {0} file(s): {1} ok, {2} failed\n{3}",
        "calibration_pick_row": "Select a row in the table first",
        "calibration_need_fit": "Add at least 2 standard points to fit",
        "calibration_fit_text": "y = {0:.6g}·x + {1:.6g}    R² = {2:.5f}",
        "calibration_unknown": "Unknown signal:",
        "calibration_calc": "Calculate",
        "calibration_addition": "Standard addition (extrapolate to zero)",
        "calibration_points": "Standards",
        "peak_half_width": "Half width",
        "export_peaks_none": "Run peak detection first (or open a curve with peaks).",
        "data_delete_page": "Delete Current Page Data…",
        "menu_analysis": "Data Analysis (Current Page)",
        "analysis_unavailable": "This page has no curve analysis functions",
        "data_none": "No data to delete on this page",
        "strip_ls": "Linear Sweep",
        "strip_dpv": "Differential Pulse",
        "strip_swv": "Square Wave",
        "dev_current_sign": "Current sign (diagnostics)",
        "dev_sign_normal": "Normal (oxidation positive, default)",
        "dev_sign_inverted": "Inverted (for reversed analog front-ends)",
        "status_current_range": "Range",
        "about_text": "Developed at Naresuan University\nby Kyle Vitautas Lopin\nfor comments or suggestions\nemail: kylel@nu.ac.th\n\nPSoC-Potentiostat-YI-1.0 GUI upgrade & maintenance:\nZhijian Yi, Guangdong, China",
        "amp_start_btn": "Start Amperometry",
        "amp_stop_btn": "Stop Amperometry",
        "amp_save_btn": "Save Data",
        "asv_start_btn": "Run ASV",
        "asv_stop_btn": "Stop ASV",
        "cv_start_btn": "Run CV Scan",
        "cv_save_btn": "Save Data",
        "cv_change_style_btn": "Change data style",
        "cv_delete_btn": "Delete Data",
        "cv_add_toolbar_btn": "Add toolbar",
        "cv_change_settings_btn": "Change Settings",

        # Toolbar tooltips (matplotlib NavigationToolbar)
        "toolbar_home": "Reset original view",
        "toolbar_back": "Back to previous view",
        "toolbar_forward": "Forward to next view",
        "toolbar_pan": "Left button pans, Right button zooms\nx/y fixes axis, CTRL fixes aspect",
        "toolbar_zoom": "Zoom to rectangle\nx/y fixes axis",
        "toolbar_subplots": "Configure subplots",
        "toolbar_save": "Save the figure",

        # Subplot configuration window (matplotlib SubplotTool)
        "subplot_tool_title": "Subplot configuration tool",
        "subplot_tool_hint": "Click on slider to adjust subplot param",
        "subplot_left": "left",
        "subplot_bottom": "bottom",
        "subplot_right": "right",
        "subplot_top": "top",
        "subplot_wspace": "wspace",
        "subplot_hspace": "hspace",
        "btn_reset": "Reset",
        "mode_pan_zoom": "pan/zoom",
        "mode_zoom_rect": "zoom rect",
        "save_figure_title": "Save the figure",
        "save_error_title": "Error saving file",
    }
}

# Global language setting
_current_lang = "zh"


def set_language(lang):
    """Set the current language"""
    global _current_lang
    if lang in TEXTS:
        _current_lang = lang


def get_language():
    """Get the current language code"""
    return _current_lang


def get_text(key, *args):
    """Get translated text by key
    :param key: text key
    :param args: format arguments (optional)
    :return: translated string
    """
    text = TEXTS.get(_current_lang, TEXTS["zh"]).get(key, key)
    if args:
        return text.format(*args)
    return text


# Shortcut
_ = get_text
