LLLIO400/PSoC-Potentiostat/tests/test_refactored.py

# Copyright (c) 2023 Kyle Lopin (Naresuan University)
# Modified by Zhijian Yi (Guangdong, China), 2026 — PSoC-Potentiostat-YI-1.0
"""
Refactored unit tests for the 7-file structure.
Run: python test_refactored.py
"""

import os as _os
import sys as _sys
import re
import tempfile

# 测试位于 tests/ 子目录：无论从哪里启动，都把项目根加进模块搜索路径
_ROOT = _os.path.dirname(_os.path.dirname(_os.path.abspath(__file__)))
if _ROOT not in _sys.path:
    _sys.path.insert(0, _ROOT)

import os
import struct
import time
import unittest
from unittest import mock
import tkinter as tk

# Import from refactored modules
from config import DeviceParameters, GraphProps, CURRENT_OPTION_LIST
from comm import AmpUsb, SerialComm, get_tia_settings
import comm as comm_module
from plotting import PyplotEmbed
from experiments import CVFrame, AmpFrame, ASVFrame
from dialogs import CVSettingChanges
from utils import open_file, check_display_type, make_voltage_profile

# 参数文件隔离：整套测试只读写临时目录，绝不碰真实的 settings*.txt。
# （必须在任何 DeviceParameters 实例化之前生效；否则保存类测试会把
#  用户真实配置覆盖成测试值——这本身就是一类要防的回归）
import config as config_module
config_module.SETTINGS_DIR_OVERRIDE = tempfile.mkdtemp(
    prefix="psoc_gui_test_settings_")


def _unbind_configure(widget):
    """递归解绑 <Configure>：Windows 上销毁窗口过程中尺寸事件异步到达，
    回调打到正在销毁的部件就会 bgerror（Linux 复现不了，真机报告噪音）。"""
    try:
        widget.unbind('<Configure>')
    except tk.TclError:
        pass
    for child in widget.winfo_children():
        _unbind_configure(child)


def _safe_destroy(root):
    """销毁 tk root：先解绑 <Configure>、取消所有挂起的 after 回调再销毁，
    最后重置 ttkbootstrap 样式单例。不做的话，Windows 上延迟回调/尺寸事件
    会在 root 销毁后触发，bgerror 打 "can't invoke tk command:
    application has been destroyed"（测试报告里的噪音行）。"""
    try:
        _unbind_configure(root)
    except tk.TclError:
        pass
    try:
        for after_id in root.tk.call('after', 'info'):
            try:
                root.after_cancel(after_id)
            except tk.TclError:
                pass
    except tk.TclError:
        pass
    try:
        root.update_idletasks()
        root.update()
    except tk.TclError:
        pass
    try:
        root.destroy()
    except tk.TclError:
        pass
    from ttkbootstrap.style.engine import Style
    Style.instance = None


# ===== Test AmpUSB =====
class TestAmpUSB(unittest.TestCase):
    # 注意：必须打桩 SerialComm。真机测试时常插着 PSoC，AmpUsb.__init__
    # 会自动连上并跑 calibrate()，把 counts_to_current 改成真机标定值，
    # 本测试的 0.05 预期就被覆盖了（真机踩坑：插着设备跑测试必挂）
    def _make_usb(self):
        mocked_root = mock.Mock()
        mocked_root.data_save_type = "Converted"
        device_params = DeviceParameters()
        device_params.adc_tia.shift = 0
        device_params.adc_tia.counts_to_current = 0.05
        with mock.patch('comm.SerialComm') as mock_serial_cls:
            mock_serial_cls.return_value.connected = False
            usb = AmpUsb(mocked_root, device_params)
        return usb

    def test_process_data(self):
        usb = self._make_usb()
        device_params = usb.device_params
        device_params.adc_tia.counts_to_current = 0.05
        _input = [5, 0, 10, 5, 15, 10, 20, 15, 25, 20,
                  20, 15, 15, 10, 10, 5, 5, 0]
        output = usb.process_data(_input, swv=True)
        correct_output = [0.25] * 9
        self.assertListEqual(output, correct_output)

    def test_process_data_swv_odd_length(self):
        """SWV 差分：奇数个采样时丢弃落单的最后一个，不再抛 IndexError。"""
        usb = self._make_usb()
        output = usb.process_data([10, 5, 15, 10, 20], swv=True)  # 5 个（奇数）
        self.assertListEqual(output, [0.25, 0.25])


# ===== Test SerialComm =====
mock_data1 = b'\xc8\x00d\x00\x00\x00d\x00\xc8\x00\xd5\x01\xea\x00\xfb\xff\x0b\xff \xfe'

class TestSerialComm(unittest.TestCase):
    @mock.patch('comm.SerialComm.auto_find_com_port')
    def setUp(self, mock_serial) -> None:
        self.serial_comm = SerialComm()

    @mock.patch('serial.Serial')
    def test_read_data(self, mock_serial):
        self.serial_comm.device = mock.Mock()
        self.serial_comm.device.read.return_value = mock_data1
        data = self.serial_comm.read_data(20, 'int16')
        self.assertListEqual(data, [200, 100, 0, 100, 200, 469, 234, -5, -245, -480])


# ===== Test CVFrame =====
class TestCVFrameUSB(unittest.TestCase):
    @classmethod
    def setUpClass(cls) -> None:
        with mock.patch("experiments.CVFrame.make_graph_area") as mocked_graph:
            cls.mocked_root = mock.Mock()
            cls.mocked_root.frames = [mock.Mock()]
            cls.mocked_root.device_params = DeviceParameters()
            cls.mocked_root.device.get_data.return_value = [5, 0, 10, 5, 15, 10, 20, 15, 25, 20,
                                                            20, 15, 15, 10, 10, 5, 5, 0]
            cls.mocked_root.device.process_data.return_value = [0.25] * 9
            settings = cls.mocked_root.device_params.cv_settings
            settings.start_voltage = 0
            settings.end_voltage = 20
            settings.use_swv = True
            graph_props = GraphProps()
            # SWV 页面固定 use_swv=True（页面模式优先于全局设置）
            cls._cv_frame = CVFrame(cls.mocked_root, None, graph_props, mode='SWV')
            cls._cv_frame.device.run_button = mock.Mock()

    @mock.patch("experiments.CVFrame.make_graph_area")
    def test_get_and_display_data(self, mocked_graph):
        settings = self.mocked_root.device_params.cv_settings
        device = self.mocked_root.device
        mocked_canvas = mock.Mock()
        self._cv_frame.device.get_and_display_data(mocked_canvas)
        args = device.process_data.call_args.args
        kwargs = device.process_data.call_args.kwargs
        self.assertEqual(args, ([5, 0, 10, 5, 15, 10, 20, 15, 25, 20,
                                 20, 15, 15, 10, 10, 5, 5, 0],))  # SWV 不丢首点，保持成对
        # 差分方向随扫描方向（上行扫描时后减前，阳极峰朝上）
        self.assertEqual({'swv': True, 'ascending': True}, kwargs)


# ===== Test CV Settings =====
class TestCVSettingChanges(unittest.TestCase):
    def setUp(self) -> None:
        self.gui = tk.Tk()
        self.gui.device_params = DeviceParameters()
        self.top_level = CVSettingChanges(None, self.gui, None, None)
        self.initial_state = self.gui.device_params.cv_settings.use_swv

    def test_load_correctly(self):
        self.assertEqual(self.initial_state, self.top_level.use_swv.get())

    def tearDown(self):
        self.gui.destroy()
        # 重置 ttkbootstrap 样式单例：否则它指向已销毁的 root，
        # 同进程里后续测试新建 root 会炸 "application has been destroyed"
        from ttkbootstrap.style.engine import Style
        Style.instance = None


# ===== 三页面模式（CV / LS / SWV 共用 CVFrame） =====
class TestCVFrameModes(unittest.TestCase):
    def test_apply_mode(self):
        """_apply_mode 把页面对应的 (sweep_type, use_swv) 写入共享设置。"""
        from experiments import CVFrame
        for mode, (sweep, use_swv) in [('CV', ('CV', False)),
                                       ('LS', ('LS', False)),
                                       ('SWV', ('LS', True))]:
            frame = CVFrame.__new__(CVFrame)
            frame.mode = mode
            frame.settings = DeviceParameters().cv_settings
            frame._apply_mode()
            self.assertEqual(frame.settings.sweep_type, sweep)
            self.assertEqual(frame.settings.use_swv, use_swv)

    def test_mode_settings_dialog_mapping(self):
        """对话框的页面映射与 CVFrame 一致。"""
        from dialogs import CVSettingChanges
        from experiments import CVFrame
        for mode in ('CV', 'LS', 'SWV'):
            sweep, use_swv, title_key = CVSettingChanges.MODE_SETTINGS[mode]
            self.assertEqual((sweep, use_swv), CVFrame.MODE_SETTINGS[mode])

    def test_swv_dialog_shows_swv_group(self):
        """SWV 模式的设置窗口标题为方波设置，保存时 use_swv 固定为 True。"""
        gui = tk.Tk()
        gui.device_params = DeviceParameters()
        try:
            dlg = CVSettingChanges(None, gui, None, None, mode='SWV')
            self.assertTrue(dlg.use_swv.get())
            self.assertEqual(dlg.sweep_type.get(), 'LS')
            dlg.destroy()
            dlg = CVSettingChanges(None, gui, None, None, mode='LS')
            self.assertFalse(dlg.use_swv.get())
            self.assertEqual(dlg.sweep_type.get(), 'LS')
            dlg.destroy()
        finally:
            gui.destroy()


    def test_run_scan_resends_params_per_mode(self):
        """页面模式与固件当前配置不同时必须重发参数（LS 页不能再沿用 CV 配置）。"""
        from experiments import CVFrame
        from unittest import mock as _m
        device = _m.Mock()
        device.last_experiment = 'CV'  # 固件里当前是 CV 参数
        device.set_last_run.side_effect = \
            lambda m: setattr(device, 'last_experiment', m)
        device.connected = True
        master = _m.Mock()
        master.device_params = DeviceParameters()
        after_cbs = []
        master.after.side_effect = lambda ms, cb=None: after_cbs.append(cb)
        handler = CVFrame.USBHandler(_m.Mock(), device, master, _m.Mock(), mode='LS')
        handler.run_scan(_m.Mock(), _m.Mock())
        after_cbs.pop(0)()  # 触发静置结束回调 → 真正写 'R'
        sent = [c.args[0] for c in device.usb_write.call_args_list]
        # 重发 LS 的 S 命令 → 静置跳起始电位（-900 mV → D|2948）→ R
        self.assertEqual(sent, ['S|2948|1148|02399|LS', 'D|2948', 'R'])
        self.assertEqual(device.last_experiment, 'LS')
        # 同页再跑一次：参数未变，不应重发 S 命令
        after_cbs.clear()  # 丢弃第一圈遗留的轮询回调，再跑第二轮
        device.reset_mock()
        handler.run_scan(_m.Mock(), _m.Mock())
        after_cbs.pop(0)()
        sent2 = [c.args[0] for c in device.usb_write.call_args_list]
        self.assertEqual(sent2, ['D|2948', 'R'])

    def test_run_scan_quiet_time_zero_skips_hold(self):
        """静置 0 秒：不写 D| 电位指令，直接同步写 R（关闭预处理）。"""
        from experiments import CVFrame
        from unittest import mock as _m
        device = _m.Mock()
        device.last_experiment = 'LS'
        device.connected = True
        master = _m.Mock()
        master.device_params = DeviceParameters()
        master.device_params.cv_settings.sweep_type = 'LS'
        master.device_params.cv_settings.use_swv = False
        master.device_params.cv_settings.quiet_time_s = 0.0
        handler = CVFrame.USBHandler(_m.Mock(), device, master, _m.Mock(), mode='LS')
        handler.run_scan(_m.Mock(), _m.Mock())
        sent = [c.args[0] for c in device.usb_write.call_args_list]
        self.assertEqual(sent, ['R'])

    def test_run_scan_quiet_time_holds_at_start(self):
        """静置 >0：先写 D| 起始电位再 R，静置时长计入进度窗估算。"""
        from experiments import CVFrame
        from unittest import mock as _m
        device = _m.Mock()
        device.last_experiment = 'SWV'
        device.connected = True
        master = _m.Mock()
        master.device_params = DeviceParameters()
        s = master.device_params.cv_settings
        s.start_voltage, s.end_voltage = -400, 600
        s.sweep_type, s.use_swv = 'LS', False
        s.quiet_time_s = 2.5
        after_cbs = []
        master.after.side_effect = lambda ms, cb=None: after_cbs.append(cb)
        handler = CVFrame.USBHandler(_m.Mock(), device, master, _m.Mock(), mode='SWV')
        with _m.patch.object(CVFrame.USBHandler, '_show_progress') as m_prog:
            handler.run_scan(_m.Mock(), _m.Mock())
            m_prog.assert_called_once_with(2.5)  # 静置计入倒计时总时长
            after_cbs.pop(0)()                   # 静置结束 → 写 'R'
        sent = [c.args[0] for c in device.usb_write.call_args_list]
        self.assertEqual(sent, ['D|2448', 'R'])  # 先 -400 mV 静置，后 R


# ===== CV 多圈 GUI 逐圈调度（回归：设 N 圈只出 N-1 圈） =====
class TestCVMultiCycleLoop(unittest.TestCase):
    """固件不支持多圈 LUT（探测到单圈长度）时，GUI 逐圈调度必须跑满设定的圈数。

    真机踩坑（2026-10-13）：_loop_cycles_left 被初始化成 cycles - 1，
    首圈 Done 抓完计数即归零、直接出图——设 2 圈只出 1 圈
    （日志：x_line 期待 4001 点 vs 数据 2001 点，被截断保存）。
    """

    def _run_multicycle(self, cycles):
        from utils import make_cv_x_line
        device = mock.Mock()
        device.last_experiment = 'CV'          # 命中"参数未变"分支，不重发 S
        device.connected = True
        device.usb_read_data.return_value = 'Done '   # 每次轮询都报告扫完
        cycle_raw = [0] + [100] * 2001         # 首点为上电残留，抓取时被丢弃
        device.get_data.side_effect = lambda n: list(cycle_raw)
        device.process_data.side_effect = [
            [1.0] * 2001, [2.0] * 2001, [3.0] * 2001]

        master = mock.Mock()
        master.device_params = DeviceParameters()
        s = master.device_params.cv_settings
        s.start_voltage, s.end_voltage = -400, 600
        s.sweep_rate, s.delay_time = 0.2, 10000.0
        s.sweep_type, s.use_swv = 'CV', False
        s.cycles = cycles

        after_cbs = []
        master.after.side_effect = lambda ms, fn=None: after_cbs.append(fn)

        handler = CVFrame.USBHandler(mock.Mock(), device, master,
                                     mock.Mock(), mode='CV')
        handler._fw_multi_cycle = False
        canvas = mock.Mock()
        with mock.patch('experiments.messagebox'):
            handler.run_scan(canvas, mock.Mock())
            self.assertTrue(handler.is_running)
            # 首次回调 = 静置结束发 R；此后每圈一次 Done 轮询回调
            for i in range(cycles + 1):
                self.assertTrue(after_cbs, '第 %d 次回调丢失' % (i + 1))
                after_cbs.pop(0)()
        # 命令序列：D| 静置跳起始电位 → R 首圈；之后每圈 抓取(E0)→再启动(R)
        sent = [c.args[0] for c in device.usb_write.call_args_list]
        self.assertEqual(sent, ['D|2448', 'R'] + ['E0', 'R'] * (cycles - 1) + ['E0'])
        self.assertEqual(canvas.update_data.call_count, 1)
        x_line, data = canvas.update_data.call_args.args[:2]
        expected_x = make_cv_x_line(s.start_voltage, s.end_voltage,
                                    master.device_params.dac.voltage_step_size,
                                    s.sweep_start_type, cycles, per_cycle=True)
        self.assertEqual(len(x_line), len(expected_x))
        self.assertEqual(len(data), len(expected_x))   # 不允许再出现截断
        return data

    def test_two_cycles(self):
        """设 2 圈必须出 2 圈（真机翻车的最小场景）。

        圈间重复的起始电位点拼前去掉：第 2 圈贡献 2001-1 = 2000 点，
        总点数与 x 轴（4001）严格一致。"""
        data = self._run_multicycle(2)
        self.assertEqual(data[:2001], [1.0] * 2001)
        self.assertEqual(data[2001:], [2.0] * 2000)

    def test_three_cycles(self):
        """设 3 圈必须出 3 圈（旧 bug 下只出 2 圈的场景）。"""
        data = self._run_multicycle(3)
        self.assertEqual(data, ([1.0] * 2001 + [2.0] * 2000 + [3.0] * 2000))


# ===== 回归：圈数不再按容量拒绝，超容量自动降级逐圈调度 =====
class TestCyclesCapacityGate(unittest.TestCase):
    """任意圈数都必须能保存并跑满：容量内走固件零间隙连续循环，
    超容量时发送端自动降级 GUI 逐圈调度（圈间停约 1 s）。

    历史：对话框曾按波形表容量一刀切拒绝圈数——旧固件时期挡下合法
    的 3 圈（"最多约 2 圈"），刷入多圈固件后又会挡下 6 圈。
    """

    def _save_cycles(self, fw_multi, cycles):
        from config import CURRENT_OPTION_LIST
        gui = tk.Tk()
        gui.device_params = DeviceParameters()
        gui.device_params.fw_cv_multi_cycle = fw_multi
        device = mock.Mock()
        try:
            display = CVSettingChanges(None, gui, None, device)
            display.start_volt.set(-400)
            display.end_volt.set(600)
            display.freq.set(0.2)
            display.cycles.set(cycles)
            before = gui.device_params.cv_settings.cycles
            master = mock.Mock()
            master.device_params = gui.device_params
            with mock.patch('dialogs.messagebox') as mb:
                display.save_cv_changes(CURRENT_OPTION_LIST[0], master,
                                        mock.Mock(), mock.Mock())
            # 先快照保存结果：finally 的恢复会原地改写同一 settings 对象
            saved_cycles = gui.device_params.cv_settings.cycles
            return mb, saved_cycles, device, before
        finally:
            # 恢复默认设置并回写，避免污染共享临时目录里后续测试的基线
            try:
                gui.device_params.cv_settings.update_settings(
                    -900, 900, 0.2, 'CV', 'Start', 100, 5, 100, False,
                    cycles=1)
            except Exception:
                pass
            gui.destroy()
            # ttkbootstrap 的 Style 单例仍指向刚销毁的 root，同进程里
            # 后续测试新建 root 会炸 "application has been destroyed"；
            # 重置后下次组件创建自动按新 root 重建（与 _safe_destroy 一致）
            try:
                from ttkbootstrap.style import Style
                Style.instance = None
            except Exception:
                pass

    def test_over_capacity_cycles_saved_on_old_firmware(self):
        """旧固件（fw_cv_multi_cycle=False）：3 圈 > 容量 2 圈照常保存。"""
        mb, saved, device, _ = self._save_cycles(False, 3)
        self.assertFalse(mb.showerror.called, "不应按 LUT 容量拦截圈数")
        self.assertEqual(saved, 3)
        self.assertTrue(device.send_cv_parameters.called)

    def test_over_capacity_cycles_saved_on_patched_firmware(self):
        """固件多圈（True）：6 圈超容量也必须保存，运行时自动降级逐圈。"""
        mb, saved, device, _ = self._save_cycles(True, 6)
        self.assertFalse(mb.showerror.called, "不应按 LUT 容量拦截圈数")
        self.assertEqual(saved, 6)
        self.assertTrue(device.send_cv_parameters.called)

    def test_unknown_firmware_saved(self):
        """未探测（None）：照常保存。"""
        mb, saved, device, _ = self._save_cycles(None, 3)
        self.assertFalse(mb.showerror.called)
        self.assertEqual(saved, 3)


# ===== 发送端圈数路由：容量内带 |N 固件多圈，超容量发单圈走 GUI 循环 =====
class TestCycleSendRouting(unittest.TestCase):
    """send_cv_parameters 必须按容量选择实现方式：
      N ≤ 容量 → 'S|...|CS|N'（固件 LUT 连续循环）；
      N > 容量 → 'S|...|CS'（单圈命令，无尾缀），由 GUI 逐圈调度跑满。
    绝不能把超容量的 |N 发给固件（LUT 截尾会悄悄少扫圈数）。
    """

    def _send(self, cycles):
        device = mock.Mock()
        device.last_experiment = 'CV'
        device.get_lut_length.return_value = 4002  # 2 圈 LUT（模拟多圈固件）
        master = mock.Mock()
        master.device_params = DeviceParameters()
        s = master.device_params.cv_settings
        s.start_voltage, s.end_voltage = -400, 600   # 容量 = 2 圈
        s.sweep_rate, s.delay_time = 0.2, 2000.0
        s.sweep_type, s.use_swv = 'CV', False
        s.cycles = cycles
        handler = CVFrame.USBHandler(mock.Mock(), device, master,
                                     mock.Mock(), mode='CV')
        handler.format_voltage_with_gnd = lambda mv: ('{0:04d}'.format(2048 - mv),
                                                      2048 - mv)
        handler.format_divider = lambda rate: ('02399', 3840)
        with mock.patch('experiments.time.sleep'):
            handler.send_cv_parameters()
        sent = [c.args[0] for c in device.usb_write.call_args_list]
        s_msg = next(m for m in sent if m.startswith('S|'))
        return s_msg, handler, device

    def test_within_capacity_uses_fw_multicycle(self):
        """2 圈 = 容量上限：带 |2 尾缀，探测命中固件多圈。"""
        s_msg, handler, device = self._send(2)
        self.assertTrue(s_msg.endswith('|CS|2'), s_msg)
        self.assertTrue(handler._fw_multi_cycle)
        self.assertTrue(device.get_lut_length.called)

    def test_over_capacity_falls_back_to_gui_loop(self):
        """6 圈 > 容量 2 圈：显式发 '|1'（固件缓冲残留会继承旧圈数，真机实测），
        不探测，走 GUI 循环跑满 6 圈。"""
        s_msg, handler, device = self._send(6)
        self.assertEqual(s_msg, 'S|2448|1448|02399|CS|1')
        self.assertFalse(handler._fw_multi_cycle)
        self.assertFalse(device.get_lut_length.called)
        self.assertEqual(handler.settings.cycles, 6, "不得私自改写用户圈数")

    def test_capacity_fallback_notice_shown(self):
        """超容量逐圈调度时必须弹双语提示（用户要求，勿静默降级）。"""
        device = mock.Mock()
        device.last_experiment = 'CV'
        device.connected = True
        device.usb_read_data.return_value = 'Done '
        cycle_raw = [0] + [100] * 2001
        device.get_data.side_effect = lambda n: list(cycle_raw)
        device.process_data.side_effect = [[1.0] * 2001] * 7

        master = mock.Mock()
        master.device_params = DeviceParameters()
        s = master.device_params.cv_settings
        s.start_voltage, s.end_voltage = -400, 600
        s.sweep_rate, s.delay_time = 0.2, 2000.0
        s.sweep_type, s.use_swv = 'CV', False
        s.cycles = 3
        after_cbs = []
        master.after.side_effect = lambda ms, fn=None: after_cbs.append(fn)

        handler = CVFrame.USBHandler(mock.Mock(), device, master,
                                     mock.Mock(), mode='CV')
        handler._fw_multi_cycle = False
        handler._cycles_over_capacity = True   # 超容量降级（send 阶段已定）
        canvas = mock.Mock()
        with mock.patch('experiments.messagebox') as mb:
            handler.run_scan(canvas, mock.Mock())
            # 提示在启动扫描时弹出一次，带圈数与容量上限
            self.assertTrue(mb.showinfo.called)
            title = mb.showinfo.call_args.args[0]
            text = mb.showinfo.call_args.args[1]
            self.assertTrue(title, "标题不能为空")
            self.assertIn('3', text)
            after_cbs.pop(0)()                     # 静置结束 → 写 'R'
            for _ in range(3):                     # 每圈一次 Done 轮询回调
                self.assertTrue(after_cbs)
                after_cbs.pop(0)()
        sent = [c.args[0] for c in device.usb_write.call_args_list]
        self.assertEqual(sent, ['D|2448', 'R'] + ['E0', 'R'] * 2 + ['E0'])


# ===== 回归：CA 平滑等长 + 计时电流自动存档 =====
class TestRollingMean(unittest.TestCase):
    """rolling_mean 旧实现把前 N-1 点原样透传（未平滑）：段式采集时
    每段开头混入生数据、段边界出现台阶毛刺——计时电流页用户报告的
    "重复点"。新实现为因果滑动均值，输出与输入等长、头部同样平滑。"""

    def test_output_same_length(self):
        from comm import rolling_mean
        out = rolling_mean(list(range(100)), 50)
        self.assertEqual(len(out), 100)

    def test_constant_input_constant_output(self):
        from comm import rolling_mean
        out = rolling_mean([7.0] * 200, 50)
        self.assertTrue(all(abs(v - 7.0) < 1e-9 for v in out))

    def test_head_is_smoothed_not_raw_passthrough(self):
        from comm import rolling_mean
        out = rolling_mean([100.0] + [0.0] * 99, 50)
        self.assertAlmostEqual(out[1], 50.0)        # 旧实现这里是原始 0
        self.assertAlmostEqual(out[10], 100.0 / 11)
        self.assertAlmostEqual(out[49], 2.0)        # 满窗起点 100/50
        self.assertAlmostEqual(out[99], 0.0)


class TestAmpAutosave(unittest.TestCase):
    """计时电流页此前是唯一没有自动存档的方法页，现与手动保存同格式。"""

    def test_autosave_amp_writes_csv(self):
        import tempfile
        from experiments import AmpFrame
        device = mock.Mock()
        device.settings.sampling_rate = 400
        device.settings.voltage = -500
        device.time = [0.0, 0.5, 1.0]
        device.data = [1.5, 2.5, 3.5]
        tmpdir = tempfile.mkdtemp(prefix="amp_autosave_")
        path = AmpFrame.autosave_amp(device, backup_dir=tmpdir)
        self.assertTrue(path and os.path.exists(path))
        text = open(path, encoding='utf-8-sig').read()
        self.assertIn("# experiment: AMP", text)
        self.assertIn("# sampling_rate_Hz: 400", text)
        self.assertIn("# voltage_mV: -500", text)
        self.assertIn("time,current", text)
        self.assertIn("0.5, 2.5", text)

    def test_autosave_amp_skips_empty(self):
        import tempfile
        from experiments import AmpFrame
        device = mock.Mock()
        device.settings.sampling_rate = 400
        device.settings.voltage = -500
        device.time = []
        device.data = []
        tmpdir = tempfile.mkdtemp(prefix="amp_autosave_empty_")
        path = AmpFrame.autosave_amp(device, backup_dir=tmpdir)
        self.assertIsNone(path)
        self.assertEqual(os.listdir(tmpdir), [])


# ===== Test ASV Settings (LS-ASV 修复 + 搅拌联动) =====
class TestASVSettings(unittest.TestCase):
    def test_delay_time_units_ms(self):
        """LS 溶出延时: |end-plate| mV / (V/s) 数值上等于毫秒, tk after() 直接用。"""
        asv = DeviceParameters().asv_settings
        # 默认: |500-(-1500)| mV / 0.5 V/s = 4000 ms, +500 ms 余量
        self.assertEqual(asv.delay_time, 500 + 2000 / 0.5)

    def test_new_params_default(self):
        asv = DeviceParameters().asv_settings
        self.assertEqual(asv.rest_time, 15)
        self.assertTrue(asv.stirring_enabled)
        self.assertTrue(asv.clean_enabled)
        self.assertFalse(asv.clean_after_strip)

    def test_update_settings_stirring(self):
        asv = DeviceParameters().asv_settings
        asv.update_settings(800, 2, -1500, 300, 500, 0.5,
                            rest_time=20, stirring_enabled=False,
                            clean_after_strip=True, clean_enabled=False)
        self.assertEqual(asv.rest_time, 20)
        self.assertFalse(asv.stirring_enabled)
        self.assertFalse(asv.clean_enabled)
        self.assertTrue(asv.clean_after_strip)
        self.assertEqual(asv.delay_time, 500 + 2000 / 0.5)

    def test_dpv_delay_time(self):
        asv = DeviceParameters().asv_settings
        asv.update_settings(800, 2, -1500, 300, 500, 0.5, sweep_type=1,
                            pulse_height=100, pulse_inc=10, pulse_width=20)
        self.assertEqual(asv.sweep_type, "DPV")
        # 脉冲宽度(ms) * 步数, 仍是毫秒
        self.assertEqual(asv.delay_time, 500 + 20 * 2000 / 10)


# ===== Test stirring GPIO command =====
class TestStirringCommand(unittest.TestCase):
    @mock.patch('comm.SerialComm.auto_find_com_port', return_value=None)
    def setUp(self, mock_port):
        mocked_root = mock.Mock()
        mocked_root.data_save_type = "Converted"
        self.usb = AmpUsb(mocked_root, DeviceParameters())
        self.usb.device = mock.Mock()
        self.usb.device.connected = True
        self.usb.connected = True

    def test_stirring_on(self):
        self.usb.set_stirring(True)
        self.usb.device.write_data.assert_called_with("O|1")

    def test_stirring_off(self):
        self.usb.set_stirring(False)
        self.usb.device.write_data.assert_called_with("O|0")


# ===== Test ASV timing chain =====
class TestASVTimingChain(unittest.TestCase):
    def setUp(self):
        self.master = mock.Mock()
        self.master.device_params = DeviceParameters()
        self.device = mock.Mock()
        self.handler = ASVFrame.USBHandler(mock.Mock(), self.device, self.master, None)
        self.handler.run_button = mock.Mock()

    def test_done_with_null_terminator_accepted(self):
        """真机固件的完成消息是 'Done\\x00'（带空字符），必须识别为完成并取数。
        回归守护：2026-08-25 真机实测 ASV 用 == 比较导致永远等不到完成。"""
        self.device.usb_read_message.return_value = 'Done\x00'
        self.handler.get_and_display_data = mock.Mock()
        self.handler.timer_window = mock.Mock()
        self.handler.is_running = True
        self.handler.run_scan_continue()
        self.handler.get_and_display_data.assert_called_once()

    def test_none_message_does_not_crash(self):
        """设备未就绪时读到 None/空串，不应崩溃也不应误判为完成。"""
        self.device.usb_read_message.return_value = None
        self.handler.get_and_display_data = mock.Mock()
        self.handler.is_running = True
        self.handler._scan_deadline = 0  # 截止时间已过 → 走超时分支
        with mock.patch('experiments.messagebox.showerror'):
            self.handler.run_scan_continue()
        self.handler.get_and_display_data.assert_not_called()
        self.assertFalse(self.handler.is_running)  # 超时后界面恢复

    @mock.patch('dialogs.TimerToplevel')
    def test_full_chain_clean_plate_rest(self, mock_timer):
        settings = self.master.device_params.asv_settings
        self.handler.asv_run(self.handler.graph, self.handler.run_button)
        self.device.start_hardware.assert_called_once()
        self.device.short_tia_resistor.assert_called_once()
        self.device.set_anode_voltage.assert_called_with(settings.clean_volt)
        self.master.after.assert_called_with(
            int(settings.clean_time * 1000), self.handler.change_to_plating_voltage)

        self.handler.change_to_plating_voltage()
        self.device.set_anode_voltage.assert_called_with(settings.plate_volt)
        self.device.set_stirring.assert_called_with(True)
        self.master.after.assert_called_with(
            int(settings.plate_time * 1000), self.handler.start_rest_period)

        self.handler.start_rest_period()
        self.device.set_stirring.assert_called_with(False)
        self.master.after.assert_called_with(
            int(settings.rest_time * 1000), self.handler.give_stripping_step)

    @mock.patch('dialogs.TimerToplevel')
    def test_stirring_disabled_skips_gpio(self, mock_timer):
        self.master.device_params.asv_settings.stirring_enabled = False
        self.handler.change_to_plating_voltage()
        self.device.set_stirring.assert_not_called()
        self.handler.start_rest_period()
        self.device.set_stirring.assert_not_called()

    def test_rest_zero_goes_straight_to_strip(self):
        self.master.device_params.asv_settings.rest_time = 0
        self.handler.give_stripping_step = mock.Mock()
        self.handler.start_rest_period()
        self.handler.give_stripping_step.assert_called_once()

    @mock.patch('dialogs.TimerToplevel')
    def test_clean_disabled_goes_straight_to_plating(self, mock_timer):
        """一次性丝网印刷电极：关闭清洗后应直接进入富集，并立刻开搅拌。"""
        settings = self.master.device_params.asv_settings
        settings.clean_enabled = False
        self.handler.asv_run(self.handler.graph, self.handler.run_button)
        # 直接加富集电压，而不是清洗电压
        self.device.set_anode_voltage.assert_called_with(settings.plate_volt)
        self.device.set_stirring.assert_called_with(True)
        self.master.after.assert_called_with(
            int(settings.plate_time * 1000), self.handler.start_rest_period)
        # 计时弹窗收到的清洗时间应为 0
        timer_args = mock_timer.call_args.args
        self.assertEqual(timer_args[1], 0)

    def test_stop_turns_off_stirring(self):
        # 模拟富集中途（搅拌开启中）点停止
        self.handler._stirring_on = True
        self.handler.after_function = 123
        self.handler.stop()
        self.device.set_stirring.assert_called_with(False)
        self.device.reset.assert_called_once()
        self.master.after_cancel.assert_called_with(123)


# ===== Test ASV with fake device (固件模拟器集成测试) =====
class TestFakeDeviceIntegration(unittest.TestCase):
    """用 FakeSerialComm 走完整 ASV 流程：命令序列 + 数据导出 + 显示。"""

    def setUp(self):
        from fake_device import FakeSerialComm, make_fake_ampusb
        self.master = mock.Mock()
        self.master.device_params = DeviceParameters()
        self.master.data_save_type = "Converted"
        self.fake = FakeSerialComm()
        self.usb = make_fake_ampusb(self.master, self.fake)
        self.handler = ASVFrame.USBHandler(mock.Mock(), self.usb, self.master, None)
        self.handler.run_button = mock.Mock()

    @mock.patch('dialogs.TimerToplevel')
    def test_asv_full_command_and_data_flow(self, _timer):
        self.handler.asv_run(self.handler.graph, self.handler.run_button)
        self.handler.change_to_plating_voltage()
        self.handler.start_rest_period()
        self.handler.give_stripping_step()   # 发扫描参数 + 'R'，after 安排 run_scan_continue
        self.handler.run_scan_continue()     # 假设备已就绪 -> 读数据 -> 显示
        cmds = self.fake.received
        self.assertIn('H', cmds)                          # start hardware
        self.assertIn('s', cmds)                          # short TIA
        self.assertIn('O|1', cmds)                        # 搅拌开
        self.assertIn('O|0', cmds)                        # 搅拌关
        self.assertTrue(any(c.startswith('S|') for c in cmds))  # 扫描 LUT
        self.assertIn('R', cmds)                          # 开始扫描
        self.assertIn('E0', cmds)                         # 导出数据
        # 顺序约束：先开搅拌后关搅拌，关搅拌后才扫描
        self.assertLess(cmds.index('O|1'), cmds.index('O|0'))
        self.assertLess(cmds.index('O|0'), cmds.index('R'))
        # 搅拌日志与电压日志
        self.assertEqual(self.fake.stirring_log, ['on', 'off'])
        self.assertGreaterEqual(len(self.fake.voltage_log), 2)  # 清洗电压 + 富集电压
        # 图形收到非空数据且 x/y 等长
        self.handler.graph.update_data.assert_called_once()
        x, y, _raw = self.handler.graph.update_data.call_args.args
        self.assertGreater(len(x), 10)
        self.assertEqual(len(x), len(y))

    @mock.patch('dialogs.TimerToplevel')
    def test_asv_clean_disabled_flow(self, _timer):
        """关闭清洗：不应发送清洗电压，直接进入富集。"""
        settings = self.master.device_params.asv_settings
        settings.clean_enabled = False
        self.handler.asv_run(self.handler.graph, self.handler.run_button)
        self.handler.start_rest_period()
        self.handler.give_stripping_step()
        self.handler.run_scan_continue()
        # 无清洗阶段 -> 只加过一次电压（富集电压）
        self.assertEqual(len(self.fake.voltage_log), 1)
        self.handler.graph.update_data.assert_called_once()


class TestASVEndToEnd(unittest.TestCase):
    """真实 tk 事件循环 + 假设备的端到端测试（ASV 全流程自动走完）。"""

    def test_run_with_fake_device(self):
        import ttkbootstrap as tb
        from fake_device import FakeSerialComm, make_fake_ampusb
        root = tk.Tk()
        root.withdraw()
        root.device_params = DeviceParameters()
        root.data_save_type = "Converted"
        settings = root.device_params.asv_settings
        # 压缩时间参数，让全流程在 ~1.5 秒内跑完
        settings.clean_time = 0.05
        settings.plate_time = 0.05
        settings.rest_time = 0.05
        settings.sweep_rate = 10.0   # delay_time = 500 + 2000/10 = 700 ms
        settings.update_settings(settings.clean_volt, settings.clean_time,
                                 settings.plate_volt, settings.plate_time,
                                 settings.end_voltage, settings.sweep_rate)
        fake = FakeSerialComm()
        usb = make_fake_ampusb(root, fake)
        handler = ASVFrame.USBHandler(mock.Mock(), usb, root, None)
        graph = handler.graph
        button = tb.Button(root)
        handler.asv_run(graph, button)
        root.after(4000, lambda: _safe_destroy(root))
        root.mainloop()
        # 全流程结束后应已取到并显示数据
        graph.update_data.assert_called_once()
        x, y, _raw = graph.update_data.call_args.args
        self.assertGreater(len(x), 10)
        # 搅拌完整开关一次
        self.assertEqual(fake.stirring_log, ['on', 'off'])
        self.assertIn('E0', fake.received)

    def tearDown(self):
        # E2E 测试销毁了自己的 tk root，重置 ttkbootstrap 样式单例，
        # 避免后续测试拿到指向已销毁 root 的 Style
        from ttkbootstrap.style.engine import Style
        Style.instance = None


# ===== Test algorithms (Phase 7: SG 平滑 / 基线扣除 / 自动寻峰) =====
class TestAlgorithms(unittest.TestCase):
    """用 fake_device 生成的合成 Pb 溶出峰 CSV 验证算法。"""

    @classmethod
    def setUpClass(cls):
        from algorithms import analyze_stripping_peak
        from utils import load_csv_file_full
        cls.results = {}   # conc -> (peaks, processed, voltage, current)
        for conc in (20, 50, 100):
            path = os.path.join(os.path.dirname(__file__),
                                "test_data", f"LS-ASV_Pb_{conc}ppb.csv")
            _meta, header, rows = load_csv_file_full(path)
            v = [float(r[0]) for r in rows]
            c = [float(r[1]) for r in rows]
            peaks, processed = analyze_stripping_peak(v, c)
            cls.results[conc] = (peaks, processed, v, c)

    def test_peak_detected_at_lead_position(self):
        """三个浓度都应在铅溶出峰位（-300 mV 附近 ±80 mV）检出唯一主峰。"""
        for conc, (peaks, _p, _v, _c) in self.results.items():
            self.assertTrue(peaks, f"{conc} ppb 未检出峰")
            self.assertAlmostEqual(peaks[0]['voltage'], -300, delta=80)

    def test_peak_height_linear_with_concentration(self):
        """峰高应随浓度单调递增，且 100ppb/20ppb ≈ 5 倍（±30%）。"""
        h20 = self.results[20][0][0]['height']
        h50 = self.results[50][0][0]['height']
        h100 = self.results[100][0][0]['height']
        self.assertLess(h20, h50)
        self.assertLess(h50, h100)
        self.assertAlmostEqual(h100 / h20, 5.0, delta=1.5)

    def test_baseline_flattened(self):
        """基线扣除后，远离峰区域的电流均值应接近 0。"""
        for conc, (peaks, processed, v, _c) in self.results.items():
            far = [c for vv, c in zip(v, processed) if vv < -1000 or vv > 200]
            self.assertAlmostEqual(sum(far) / len(far), 0, delta=1.0)

    def test_sg_smooth_short_and_even(self):
        """边界情况：短数据原样返回；偶数窗口自动调整不报错。"""
        from algorithms import sg_smooth
        self.assertEqual(sg_smooth([1, 2, 3]), [1, 2, 3])
        out = sg_smooth(list(range(50)), window=10)
        self.assertEqual(len(out), 50)

    def test_detect_peaks_empty(self):
        from algorithms import detect_peaks
        self.assertEqual(detect_peaks([1, 2], [1, 2]), [])
        flat = [5.0] * 100
        self.assertEqual(detect_peaks(list(range(100)), flat), [])


# ===== 算法按钮的图侧集成（Phase 7 GUI 集成） =====
class TestAnalysisGraphOps(unittest.TestCase):
    """验证 PyplotEmbed 的框选/平滑/基线/寻峰标注，以及 CVFrame.get_metadata / ASVFrame.get_metadata。"""

    def setUp(self):
        self.root = tk.Tk()
        self.root.withdraw()
        from config import GraphProps
        from plotting import PyplotData
        fake_frame = tk.Frame(self.root)  # master 必须是真实 tk 组件
        fake_frame.data = PyplotData()
        self.graph = PyplotEmbed(self.root, GraphProps().cv_plot,
                                 fake_frame, 50, -1500, 500)
        # 跳过数据标签弹窗
        self.graph.user_sets_labels_after_run = False

    def tearDown(self):
        _safe_destroy(self.root)
        import matplotlib.pyplot as plt
        plt.close('all')  # 防止 pyplot 注册表累积 figure 导致内存膨胀

    def _load_curve(self):
        from utils import load_csv_file_full
        path = os.path.join(os.path.dirname(__file__),
                            "test_data", "LS-ASV_Pb_50ppb.csv")
        _meta, header, rows = load_csv_file_full(path)
        v = [float(r[0]) for r in rows]
        c = [float(r[1]) for r in rows]
        self.graph.update_data(v, c, label="Pb 50ppb")

    def test_smooth_baseline_peak_workflow(self):
        """完整流程：上数据 -> 框选区域 -> 平滑 -> 基线扣除 -> 寻峰标注。"""
        from algorithms import sg_smooth, subtract_baseline, analyze_stripping_peak
        self._load_curve()
        # 无数据时 transform_latest 应返回 False（另起一个空图验证）
        self.assertTrue(self.graph.toggle_region_selector())
        self.assertFalse(self.graph.toggle_region_selector())
        # 框选峰区域
        self.graph._on_region_selected(-400, -200)
        self.assertEqual(self.graph.peak_region, (-400, -200))
        # 平滑
        line_before = list(self.graph.get_latest_line().get_ydata())
        ok = self.graph.transform_latest(lambda v, c: (v, sg_smooth(c)))
        self.assertTrue(ok)
        line_after = list(self.graph.get_latest_line().get_ydata())
        self.assertNotEqual(line_before, line_after)
        # 基线扣除（区域外拟合）
        ok = self.graph.transform_latest(
            lambda v, c: (v, subtract_baseline(v, c, peak_region=self.graph.peak_region)))
        self.assertTrue(ok)
        # 寻峰 + 标注
        line = self.graph.get_latest_line()
        peaks, _ = analyze_stripping_peak(list(line.get_xdata()),
                                          list(line.get_ydata()),
                                          peak_region=self.graph.peak_region)
        self.assertTrue(peaks)
        self.graph.annotate_peaks(peaks)
        self.assertEqual(len(self.graph._peak_annotations), 2 * len(peaks))
        self.graph.clear_peak_annotations()
        self.assertEqual(self.graph._peak_annotations, [])

    def test_transform_latest_no_data(self):
        self.assertFalse(self.graph.transform_latest(lambda v, c: (v, c)))
        self.assertIsNone(self.graph.get_latest_line())

    def test_restore_latest(self):
        """平滑/基线后可还原为原始数据；未修改的曲线还原返回 False。"""
        from algorithms import sg_smooth
        self._load_curve()
        line = self.graph.get_latest_line()
        orig_v = list(line.get_xdata())
        orig_c = list(line.get_ydata())
        # 连续两次变换后仍可一键还原到最初数据
        self.assertTrue(self.graph.transform_latest(lambda v, c: (v, sg_smooth(c))))
        self.assertTrue(self.graph.transform_latest(lambda v, c: (v, c[::-1])))
        self.assertNotEqual(list(line.get_ydata()), orig_c)
        self.assertTrue(self.graph.restore_latest())
        self.assertEqual(list(line.get_xdata()), orig_v)
        self.assertEqual(list(line.get_ydata()), orig_c)
        # 再次还原：没有备份了
        self.assertFalse(self.graph.restore_latest())

    def test_metadata_and_csv_roundtrip(self):
        """get_metadata 生成参数头；保存后 open_data 能跳过 '#' 行读回数据。"""
        import csv
        import io
        self._load_curve()
        # 构造一个带 master 的 CVFrame 骨架，只测 get_metadata
        frame = CVFrame.__new__(CVFrame)
        frame.master = mock.Mock()
        frame.master.device_params = DeviceParameters()
        meta = frame.get_metadata()
        self.assertEqual(meta["experiment"], "CV")
        self.assertIn("sweep_rate_V/s", meta)
        # ASV 覆盖
        asv_frame = ASVFrame.__new__(ASVFrame)
        asv_frame.master = frame.master
        meta_asv = asv_frame.get_metadata()
        self.assertEqual(meta_asv["experiment"], "ASV")
        self.assertIn("stirring_enabled", meta_asv)
        self.assertIn("rest_time_s", meta_asv)
        # 写入带 metadata 的 CSV
        buf = io.StringIO()
        self.graph.data.save_all_data(buf, "Converted", meta_asv)
        text = buf.getvalue()
        self.assertTrue(text.startswith("# experiment: ASV"))
        # 用 load_csv_file 读回（与 main.open_data 同一入口）
        import os
        import tempfile
        from utils import load_csv_file
        with tempfile.NamedTemporaryFile('w', suffix='.csv', delete=False,
                                         newline='', encoding='utf-8') as f:
            f.write(text)
            tmp = f.name
        try:
            header, data_rows = load_csv_file(tmp)
        finally:
            os.unlink(tmp)
        self.assertEqual(header[0], "voltage")
        # 数据行数与图形数据一致（notes 行已被跳过）
        self.assertEqual(len(data_rows), len(self.graph.data.voltage_data[0]))
        float(data_rows[0][0]); float(data_rows[0][1])

    def test_load_csv_file_formats(self):
        """load_csv_file 兼容本程序格式与通用两列格式；垃圾文件返回 None。"""
        import os
        import tempfile
        from utils import load_csv_file

        def _write(content):
            f = tempfile.NamedTemporaryFile('w', suffix='.csv', delete=False,
                                            newline='', encoding='utf-8')
            f.write(content)
            f.close()
            return f.name

        # 通用两列格式（合成测试数据样式：label 行 + voltage_mV 表头）
        path = _write("label,LS-ASV Pb 50ppb (合成数据)\n"
                      "voltage_mV,current_uA\n-1500,4.6\n-1400,5.1\n")
        try:
            header, rows = load_csv_file(path)
        finally:
            os.unlink(path)
        self.assertEqual(header, ["voltage_mV", "current_uA"])
        self.assertEqual(rows, [["-1500", "4.6"], ["-1400", "5.1"]])

        # 本程序格式：'#' 元数据 + voltage 表头 + 备注行 + 数据
        path = _write("# experiment: ASV\n"
                      "voltage,current_1\nnotes: 测试\n-1500,4.6\n-1400,5.1\n")
        try:
            header, rows = load_csv_file(path)
        finally:
            os.unlink(path)
        self.assertEqual(header[0], "voltage")
        self.assertEqual(len(rows), 2)

        # 无法识别的文件 -> None
        path = _write("hello,world\n1,2\n")
        try:
            self.assertIsNone(load_csv_file(path))
        finally:
            os.unlink(path)


# ===== 删除数据清理（峰标注 + 图例随曲线一起消失） =====
class TestDeleteCleanup(unittest.TestCase):
    def setUp(self):
        self.root = tk.Tk()
        self.root.withdraw()
        from config import GraphProps
        from plotting import PyplotData
        fake_frame = tk.Frame(self.root)
        fake_frame.data = PyplotData()
        self.graph = PyplotEmbed(self.root, GraphProps().cv_plot,
                                 fake_frame, 50, -1500, 500)
        self.graph.user_sets_labels_after_run = False

    def tearDown(self):
        _safe_destroy(self.root)
        import matplotlib.pyplot as plt
        plt.close('all')

    @staticmethod
    def _make_peak_curve(center=-550.0, height=20.0):
        """生成一条带高斯峰的合成溶出曲线（v, c）。"""
        import math
        v = [-1500 + i * 10 for i in range(200)]  # -1500 ~ 490 mV
        c = [2.0 + height * math.exp(-((x - center) / 60.0) ** 2) for x in v]
        return v, c

    def test_delete_removes_annotations_and_legend(self):
        from algorithms import analyze_stripping_peak
        # 两条曲线：生成的峰形数据
        v1, c1 = self._make_peak_curve(-550.0, 20.0)
        v2, c2 = self._make_peak_curve(-700.0, 12.0)
        self.graph.update_data(v1, c1, label="Pb")
        self.graph.update_data(v2, c2, label="Cd")
        self.assertIsNotNone(self.graph.graph_area.axis.get_legend())
        # 寻峰并标注（图上出现红色标记）
        line = self.graph.get_latest_line()
        peaks, _ = analyze_stripping_peak(list(line.get_xdata()),
                                          list(line.get_ydata()))
        self.assertTrue(peaks)
        self.graph.annotate_peaks(peaks)
        self.assertTrue(self.graph._peak_annotations)
        # 删除一条曲线：峰标注必须一起消失，图例仍在（还剩一条）
        self.graph.delete_a_line(1)
        self.assertEqual(self.graph._peak_annotations, [])
        self.assertIsNotNone(self.graph.graph_area.axis.get_legend())
        # 删除全部：图例也消失
        self.graph.delete_all_lines()
        self.assertIsNone(self.graph.graph_area.axis.get_legend())


# ===== 真实计时窗 + 假设备全链路（复现 2026-08-25 真机卡死） =====
class TestAsvRealTimerWindow(unittest.TestCase):
    """不用 Mock 替换 TimerToplevel：真实弹窗 + 真实 tk 事件循环 + 假设备，
    验证 ASV 全流程中窗口能正确切换扫描阶段并最终关闭。"""

    def setUp(self):
        self.root = tk.Tk()
        self.root.withdraw()
        self.root.device_params = DeviceParameters()
        self.root.data_save_type = "Converted"

    def tearDown(self):
        _safe_destroy(self.root)

    def _pump(self, seconds):
        end = time.time() + seconds
        while time.time() < end:
            self.root.update()
            time.sleep(0.01)

    def test_stale_tick_cannot_overwrite_scan_phase(self):
        """show_scan 之后残留的定时回调不得把文字改回"静置剩余 1.0"。"""
        from dialogs import TimerToplevel
        from i18n import get_text
        dlg = TimerToplevel(self.root, 0, 1, 1)
        self.root.update()
        dlg.show_scan(5)
        dlg.run()  # 模拟 show_scan 之前已排进事件队列的残留回调
        self.assertEqual(dlg.stage, 'scan')
        self.assertEqual(dlg.toplabel.cget('text'),
                         get_text('scan_progress_left').format(5))
        dlg.close()

    def test_scan_phase_counts_down(self):
        """扫描阶段是会走的倒数：每秒减一，进度条按比例前进，归零显示处理中。"""
        from dialogs import TimerToplevel
        from i18n import get_text
        dlg = TimerToplevel(self.root, 0, 1, 1)
        self.root.update()
        dlg.show_scan(3)
        dlg._scan_tick()
        self.assertEqual(dlg.toplabel.cget('text'),
                         get_text('scan_progress_left').format(2))
        self.assertEqual(dlg._progress_bar['value'], 1)
        dlg._scan_tick()
        dlg._scan_tick()
        self.assertEqual(dlg.toplabel.cget('text'), get_text('scan_finishing'))
        dlg.close()
        self.assertFalse(dlg.winfo_exists())

    def test_full_asv_chain_real_window_fake_device(self):
        """富集0s/静置0s 全链真跑：窗口切扫描→数据回读→画图→窗口自动关闭。"""
        from fake_device import FakeSerialComm, make_fake_ampusb
        from i18n import get_text
        settings = self.root.device_params.asv_settings
        settings.update_settings(settings.clean_volt, 0, settings.plate_volt, 0,
                                 -1180, settings.sweep_rate, sweep_type=1,
                                 pulse_height=50, pulse_inc=16, pulse_width=10,
                                 rest_time=0, clean_enabled=False)
        fake = FakeSerialComm()
        usb = make_fake_ampusb(self.root, fake)
        graph = mock.Mock()
        handler = ASVFrame.USBHandler(graph, usb, self.root, None)
        handler.asv_run(graph, mock.Mock())
        dlg = handler.timer_window
        self.assertIsNotNone(dlg)
        # 扫描阶段（delay ≈ 500+10*20 = 700ms）：窗口应已切到扫描显示
        self._pump(0.3)
        self.assertEqual(dlg.stage, 'scan')
        self.assertEqual(dlg.toplabel.cget('text'),
                         get_text('scan_progress_left').format(
                             max(1, int(round(handler._estimate_scan_seconds())))))
        # 扫描完成后：数据画图 + 窗口自动销毁 + 引用清空
        self._pump(2.0)
        graph.update_data.assert_called_once()
        self.assertFalse(dlg.winfo_exists())
        self.assertIsNone(handler.timer_window)
        self.assertTrue(any(cmd.startswith('P|') for cmd in fake.received))


# ===== DPV-ASV 修复（x 轴 / packet_count / 参数校验） =====
class TestDpvXLineAndValidation(unittest.TestCase):
    def test_make_dpv_x_line(self):
        from utils import make_dpv_x_line
        # 上行
        x = make_dpv_x_line(-1500, -1100, 100)
        self.assertEqual(x, [-1500, -1400, -1300, -1200, -1100])
        # 下行
        x = make_dpv_x_line(500, 100, 100)
        self.assertEqual(x, [500, 400, 300, 200, 100])
        # 不整除时按整数步数截断（与固件 LUT 一致）
        x = make_dpv_x_line(-1500, -1180, 100)
        self.assertEqual(len(x), 320 // 100 + 1)
        # 非法步进
        with self.assertRaises(ValueError):
            make_dpv_x_line(-1500, 500, 0)

    def test_validate_dpv_params(self):
        from utils import validate_dpv_params
        self.assertEqual(validate_dpv_params(-1500, 500, 0, 10, 100),
                         "err_pulse_height")
        self.assertEqual(validate_dpv_params(-1500, 500, 50, 0, 100),
                         "err_pulse_inc")
        self.assertEqual(validate_dpv_params(-1500, 500, 50, 10, 5),
                         "err_pulse_width")
        self.assertEqual(validate_dpv_params(-1500, -1490, 50, 20, 100),
                         "err_scan_range")
        self.assertIsNone(validate_dpv_params(-1500, 500, 50, 10, 100))


class TestDpvAsvEndToEnd(unittest.TestCase):
    """DPV 模式全流程：P 命令（真 DPV 固件） -> 差分数据 -> x 轴点数与数据一一对应。
    用同步 after 的 Mock master 驱动时序链（避免多套 tk root 竞争崩溃）。"""

    @mock.patch('dialogs.TimerToplevel')
    def test_dpv_run_with_fake_device(self, _mock_timer):
        from fake_device import FakeSerialComm, make_fake_ampusb
        master = mock.Mock()
        master.device_params = DeviceParameters()
        master.data_save_type = "Converted"
        # after 立即同步执行回调，整条 清洗->富集->静置->溶出 链一次走完
        master.after.side_effect = lambda _delay, cb: cb()
        settings = master.device_params.asv_settings
        # DPV：脉冲增量 16 mV（= 1 个 8-bit DAC 计数），终点 -1180 mV -> 20 步
        settings.update_settings(settings.clean_volt, settings.clean_time,
                                 settings.plate_volt, settings.plate_time,
                                 -1180, settings.sweep_rate, sweep_type=1,
                                 pulse_height=50, pulse_inc=16, pulse_width=10)
        self.assertEqual(settings.sweep_type, "DPV")
        fake = FakeSerialComm()
        usb = make_fake_ampusb(master, fake)
        handler = ASVFrame.USBHandler(mock.Mock(), usb, master, None)
        handler.asv_run(handler.graph, mock.Mock())
        graph = handler.graph
        graph.update_data.assert_called_once()
        x, y, _raw = graph.update_data.call_args.args
        # 21 步，x 轴与差分后数据等长
        self.assertEqual(len(x), 21)
        self.assertEqual(len(x), len(y))
        self.assertEqual(x[0], settings.low_voltage)
        self.assertEqual(x[-1], -1180)
        # 发的是 P 命令（真 DPV 固件补丁）
        self.assertTrue(any(cmd.startswith('P|') for cmd in fake.received))
        # packet_count 与固件发送点数一致：2*21 点 / 32 点每包 -> 2 包
        self.assertEqual(handler.usb_packet_count, 2)
        # 差分电流应在峰位附近出现明显峰（合成峰高约 400 计数 -> 0.4 µA）
        self.assertGreater(max(y), 0.2)


class TestDpvDialogValidation(unittest.TestCase):
    """ASV 设置对话框：DPV 非法参数弹错并拒绝保存，合法参数正常保存。
    整个类共用一个 tk root，避免反复建销毁解释器。"""

    @classmethod
    def setUpClass(cls):
        cls.root = tk.Tk()
        cls.root.withdraw()
        cls.root.device_params = DeviceParameters()
        cls.root.update_current_range = mock.Mock()

    @classmethod
    def tearDownClass(cls):
        _safe_destroy(cls.root)

    def _make_dialog(self):
        from dialogs import ASVSettingChanges
        return ASVSettingChanges(mock.Mock(), self.root, mock.Mock(), mock.Mock())

    def test_invalid_pulse_inc_rejected(self):
        dialog = self._make_dialog()
        dialog.sweep_type.set(1)       # DPV
        dialog.pulse_inc.set(0)        # 非法
        with mock.patch('dialogs.messagebox.showerror') as err_box:
            dialog.save()
        err_box.assert_called_once()
        # 参数未被保存
        self.assertEqual(self.root.device_params.asv_settings.sweep_type, "LS")
        dialog.destroy()

    def test_valid_dpv_saved(self):
        dialog = self._make_dialog()
        dialog.sweep_type.set(1)
        dialog.pulse_height.set(50)
        dialog.pulse_inc.set(10)
        dialog.pulse_width.set(100)
        with mock.patch('dialogs.messagebox.showerror') as err_box:
            dialog.save()
        err_box.assert_not_called()
        self.assertEqual(self.root.device_params.asv_settings.sweep_type, "DPV")
        # 恢复默认，避免影响其他测试
        self.root.device_params.asv_settings.sweep_type = "LS"


class TestSwvAsvEndToEnd(unittest.TestCase):
    """SWV 溶出全流程：G 命令须符合固件 user_lookup_table_maker_swv 的字段格式。"""

    @mock.patch('dialogs.TimerToplevel')
    def test_swv_run_with_fake_device(self, _mock_timer):
        from fake_device import FakeSerialComm, make_fake_ampusb
        master = mock.Mock()
        master.device_params = DeviceParameters()
        master.data_save_type = "Converted"
        master.after.side_effect = lambda _delay, cb: cb()
        settings = master.device_params.asv_settings
        # SWV：步进 16 mV（=1 个 8-bit DAC 计数），终点 -1180 mV -> 21 步
        settings.update_settings(settings.clean_volt, settings.clean_time,
                                 settings.plate_volt, settings.plate_time,
                                 -1180, settings.sweep_rate, sweep_type=2,
                                 pulse_height=50, pulse_inc=16, pulse_width=20)
        self.assertEqual(settings.sweep_type, "SWV")
        fake = FakeSerialComm()
        usb = make_fake_ampusb(master, fake)
        handler = ASVFrame.USBHandler(mock.Mock(), usb, master, None)
        handler.asv_run(handler.graph, mock.Mock())
        # G 命令格式: G|XXXX|YYYY|IIII|HHHH|ZZZZZ|AB（7 段，末段扫描类型 'LS'）
        g_cmds = [c for c in fake.received if c.startswith('G|')]
        self.assertEqual(len(g_cmds), 1)
        parts = g_cmds[0].split('|')
        self.assertEqual(len(parts), 7)
        step = master.device_params.dac.voltage_step_size
        self.assertEqual(parts[3], "{0:04d}".format(int(16 / step)))   # 步进计数
        self.assertEqual(parts[4], "{0:04d}".format(int(50 / step)))   # 幅值计数
        self.assertEqual(parts[6], "LS")
        # 数据：21 步差分后 21 点，x 轴等长
        handler.graph.update_data.assert_called_once()
        x, y, _raw = handler.graph.update_data.call_args.args
        self.assertEqual(len(x), 21)
        self.assertEqual(len(x), len(y))
        self.assertEqual(x[-1], -1180)
        # packet_count：2*21 点 / 32 每包 -> 2 包
        self.assertEqual(handler.usb_packet_count, 2)

    def test_swv_delay_time(self):
        """SWV 每步一个方波周期：delay = 500 + 周期ms × 步数。"""
        settings = DeviceParameters().asv_settings
        settings.update_settings(-1500, 60, -1500, 300, 500, 0.5, sweep_type=2,
                                 pulse_height=50, pulse_inc=10, pulse_width=100)
        self.assertEqual(settings.delay_time, 500 + 100 * (2000 / 10))


class TestSwvDialogValidation(unittest.TestCase):
    """SWV 单选项同样走参数校验。"""

    @classmethod
    def setUpClass(cls):
        cls.root = tk.Tk()
        cls.root.withdraw()
        cls.root.device_params = DeviceParameters()
        cls.root.update_current_range = mock.Mock()

    @classmethod
    def tearDownClass(cls):
        _safe_destroy(cls.root)

    def test_swv_invalid_and_valid(self):
        from dialogs import ASVSettingChanges
        dialog = ASVSettingChanges(mock.Mock(), self.root, mock.Mock(), mock.Mock())
        dialog.sweep_type.set(2)       # SWV
        dialog.pulse_inc.set(0)        # 非法
        with mock.patch('dialogs.messagebox.showerror') as err_box:
            dialog.save()
        err_box.assert_called_once()
        self.assertNotEqual(self.root.device_params.asv_settings.sweep_type, "SWV")
        dialog.destroy()
        # 合法保存
        dialog = ASVSettingChanges(mock.Mock(), self.root, mock.Mock(), mock.Mock())
        dialog.sweep_type.set(2)
        dialog.pulse_height.set(50)
        dialog.pulse_inc.set(10)
        dialog.pulse_width.set(100)
        with mock.patch('dialogs.messagebox.showerror') as err_box:
            dialog.save()
        err_box.assert_not_called()
        self.assertEqual(self.root.device_params.asv_settings.sweep_type, "SWV")
        self.root.device_params.asv_settings.sweep_type = "LS"  # 还原


# ===== 扫描进度弹窗（模态、禁止操作其它按钮） =====
class TestScanProgressDialog(unittest.TestCase):
    def setUp(self):
        self.root = tk.Tk()
        self.root.withdraw()

    def tearDown(self):
        _safe_destroy(self.root)

    def test_modal_grab_and_close(self):
        """弹窗期间持有 grab（主窗口点不动），close 后释放。"""
        from dialogs import ScanProgress
        from i18n import get_text
        dlg = ScanProgress(self.root, 5)
        self.root.update_idletasks()
        self.assertEqual(dlg.title(), get_text("scan_progress_title"))
        self.assertIs(self.root.grab_current(), dlg)  # 模态生效
        dlg.close()
        self.assertIsNone(self.root.grab_current())   # 关闭后释放

    def test_estimate_scan_seconds(self):
        """估算耗时：CV 往返两段、LS 一段、SWV 步数×周期。"""
        from experiments import CVFrame
        master = mock.Mock()
        master.device_params = DeviceParameters()
        handler = CVFrame.USBHandler(mock.Mock(), mock.Mock(), master, mock.Mock())
        s = master.device_params.cv_settings
        s.start_voltage, s.end_voltage = -500, 500
        s.delay_time = 0
        s.use_swv = False
        s.sweep_type = 'CV'
        s.sweep_rate = 0.1  # V/s -> 2 段 × 1V / 0.1 = 20 s
        self.assertAlmostEqual(handler._estimate_scan_seconds(), 20.0)
        s.sweep_type = 'LS'
        self.assertAlmostEqual(handler._estimate_scan_seconds(), 10.0)
        s.use_swv = True
        s.swv_inc, s.swv_period = 4, 20
        # SWV 独立页：固件对 'L' 型扫描只扫单段 start→end，
        # 250 步 × 20ms + 1s 余量 = 6 s（delay_time 不得重复计入）
        s.sweep_start_type = 'Start'
        self.assertAlmostEqual(handler._estimate_scan_seconds(), 6.0)

    def test_timer_window_merges_scan_phase(self):
        """计时窗倒计时结束后原地切换为扫描进度，close 后销毁。"""
        from dialogs import TimerToplevel
        dlg = TimerToplevel(self.root, 0, 1, 0)
        self.root.update_idletasks()
        dlg.show_scan(5)
        self.assertEqual(dlg.stage, 'scan')
        self.assertIsNotNone(dlg._progress_bar)
        dlg.close()
        self.assertFalse(dlg.winfo_exists())

    def test_asv_scan_reuses_timer_window(self):
        """溶出扫描开始时优先复用计时窗（show_scan），不再弹第二个进度窗。"""
        from experiments import ASVFrame
        master = mock.Mock()
        master.device_params = DeviceParameters()
        device = mock.Mock()
        device.connected = True
        handler = ASVFrame.USBHandler(mock.Mock(), device, master, None)
        handler.run_button = mock.Mock()
        timer = mock.Mock()
        handler.timer_window = timer
        handler._progress = None
        handler.run_scan(100)
        timer.show_scan.assert_called_once()      # 计时窗原地切换
        self.assertIsNone(handler._progress)      # 未创建独立进度窗

    def test_run_scan_failure_closes_progress(self):
        """扫描重试耗尽时弹窗必须关闭、运行按钮恢复，否则界面卡死。"""
        from experiments import CVFrame
        device = mock.Mock()
        device.usb_read_data.return_value = "not complete"
        master = mock.Mock()
        master.device_params = DeviceParameters()
        handler = CVFrame.USBHandler(mock.Mock(), device, master, mock.Mock())
        handler.run_button = mock.Mock()
        handler.is_running = True  # 停止/超时守卫：未在运行则直接返回
        tw = mock.Mock()
        handler.timer_window = tw
        handler.run_scan_continue(mock.Mock(), fail_count=999)  # 超过阈值
        tw.close.assert_called_once()
        self.assertIsNone(handler.timer_window)
        self.assertFalse(handler.is_running)


# ===== 标定异常保护（2026-08-25 真机 ZeroDivisionError 启动崩溃） =====
class TestCalibrationGuard(unittest.TestCase):
    GOOD = [200, 100, 0, 100, 200, 491, 245, -3, -247, -491]

    def _bare_usb(self, readings):
        from comm import AmpUsb
        usb = AmpUsb.__new__(AmpUsb)
        usb.device_params = DeviceParameters()
        usb.usb_read_data = mock.Mock(side_effect=readings)
        usb.usb_write = mock.Mock()
        return usb

    def test_zero_divisor_rejected(self):
        """data[5]==data[7] 的无效标定数据必须抛错而不是除零崩溃。"""
        adc = DeviceParameters().adc_tia
        with self.assertRaises(ValueError):
            adc.calibrate([0] * 10)

    def test_retry_recovers(self):
        """第一次数据无效时复位设备重试，第二次成功则正常标定。"""
        usb = self._bare_usb([[0] * 10, list(self.GOOD)])
        usb._calibrate_data()
        self.assertFalse(usb.device_params.adc_tia.calibrate_failed)

    def test_retry_wakes_hardware_without_reset(self):
        """标定重试绝不许用 'X' 复位（X 让固件硬件 Sleep 且断电前不恢复，
        'H' 唤不醒，X 后重试必再失败——真机两次实测实锤）；只能 H 唤醒后重试。"""
        usb = self._bare_usb([[0] * 10, list(self.GOOD)])
        usb._calibrate_data()
        calls = [c.args[0] for c in usb.usb_write.call_args_list]
        self.assertNotIn('X', calls)                 # 重试路径禁止 X
        self.assertEqual(calls, ['H', 'B'])          # 唤醒后重试 B

    def test_calibrate_wakes_hardware_first(self):
        """calibrate() 标定前先 'H' 唤醒：设备可能处于上次会话 X 留下
        的 Sleep 状态（断电前不恢复），直接标定必失败。"""
        usb = self._bare_usb([list(self.GOOD)])
        usb.connected = True
        usb.calibrate()
        calls = [c.args[0] for c in usb.usb_write.call_args_list]
        self.assertLess(calls.index('H'), calls.index('B'))

    def test_fallback_after_two_failures(self):
        """两次都失败：不崩溃，标记 calibrate_failed，沿用理论系数。"""
        usb = self._bare_usb([[0] * 10, [0] * 10])
        usb._calibrate_data()
        self.assertTrue(usb.device_params.adc_tia.calibrate_failed)


# ===== 扫描数据自动备份 =====
class TestAutosave(unittest.TestCase):
    def test_autosave_roundtrip(self):
        """备份文件能被 文件->打开数据 重新载入，且元数据记录实验类型。"""
        import csv
        import tempfile
        from utils import load_csv_file
        frame = CVFrame.__new__(CVFrame)
        frame.mode = 'LS'
        frame.master = mock.Mock()
        frame.master.device_params = DeviceParameters()
        with tempfile.TemporaryDirectory() as tmpdir:
            path = frame.autosave_scan([0, 100, 200], [1.5, 2.5, 3.5],
                                       backup_dir=tmpdir)
            self.assertIsNotNone(path)
            self.assertTrue(os.path.exists(path))
            self.assertIn('LS', os.path.basename(path))
            with open(path, encoding='utf-8') as f:
                content = f.read()
            self.assertIn('# experiment: LS', content)  # 元数据可追溯
            header, data_rows = load_csv_file(path)
            self.assertEqual(header[0], 'voltage')
            self.assertEqual(len(data_rows), 3)
            self.assertAlmostEqual(float(data_rows[1][1]), 2.5)

    def test_autosave_failure_does_not_raise(self):
        """备份失败（目录不可写等）只记日志，不影响扫描主流程。"""
        frame = CVFrame.__new__(CVFrame)
        frame.mode = 'CV'
        frame.master = mock.Mock()
        frame.master.device_params = DeviceParameters()
        # 传一个非法路径（文件而非目录）触发异常
        import tempfile
        with tempfile.NamedTemporaryFile() as bad:
            path = frame.autosave_scan([0], [1.0],
                                       backup_dir=os.path.join(bad.name, 'x'))
        self.assertIsNone(path)


# ===== 只改量程也要刷新显示 =====
class TestCurrentRangeRefresh(unittest.TestCase):
    def setUp(self):
        self.root = tk.Tk()
        self.root.withdraw()
        self.root.device_params = DeviceParameters()
        self.root.update_current_range = mock.Mock()

    def tearDown(self):
        _safe_destroy(self.root)

    def test_save_only_range_change_still_refreshes(self):
        """扫描参数不变、只改电流量程时，保存后仍调用 update_current_range。"""
        idx = self.root.device_params.adc_tia.current_option_index
        dlg = CVSettingChanges(mock.Mock(), self.root, mock.Mock(), mock.Mock(),
                               mode='CV')
        dlg.save_cv_changes(CURRENT_OPTION_LIST[idx], self.root,
                            mock.Mock(), mock.Mock())
        self.root.update_current_range.assert_called_once()
        args = self.root.update_current_range.call_args.args
        self.assertEqual(args[0], CURRENT_OPTION_LIST[idx])
        # 换到另一个量程再保存，同样要刷新
        self.root.update_current_range.reset_mock()
        other = (idx + 1) % len(CURRENT_OPTION_LIST)
        dlg = CVSettingChanges(mock.Mock(), self.root, mock.Mock(), mock.Mock(),
                               mode='CV')
        dlg.save_cv_changes(CURRENT_OPTION_LIST[other], self.root,
                            mock.Mock(), mock.Mock())
        self.root.update_current_range.assert_called_once()
        self.assertEqual(self.root.update_current_range.call_args.args[0],
                         CURRENT_OPTION_LIST[other])


class TestRangeRefreshEndToEnd(unittest.TestCase):
    """真实 GUI 实例验证量程刷新：标签格式化必须用数值，传字符串不能崩。

    回归历史 bug：update_current_range 把 '±12.5 µA' 字符串传给
    {0:.1f} 格式化 → ValueError → tk 回调静默吞掉 → 保存设置看似失效。
    """

    @classmethod
    def setUpClass(cls):
        with mock.patch('main.AmpUsb') as mock_usb:
            mock_usb.return_value.connected = False
            import main as main_mod
            cls.app = main_mod.ElectroChemGUI()
            cls.app.update_idletasks()

    @classmethod
    def tearDownClass(cls):
        _safe_destroy(cls.app)

    def test_update_range_with_string_label_does_not_crash(self):
        app = self.app
        app.update_current_range(CURRENT_OPTION_LIST[4], 12.5)
        app.update_idletasks()
        text = app.cv.cv_settings_frame.current_var_str.get()
        self.assertIn('12.5', text)
        # 五个页面的标签都应刷新
        self.assertIn('12.5', app.ls.cv_settings_frame.current_var_str.get())
        self.assertIn('12.5', app.swv.cv_settings_frame.current_var_str.get())
        self.assertIn('12.5', app.amp.settings_frame.current_var_str.get())
        self.assertIn('12.5', app.asv.cv_settings_frame.current_var_str.get())

    def test_save_dialog_end_to_end(self):
        """完整路径：打开 CV 设置窗口改参数再保存，窗口正常关闭、参数生效。"""
        app = self.app
        dlg = CVSettingChanges(app.cv.cv_settings_frame, app, app.cv.graph,
                               app.cv.device, mode='CV')
        app.update_idletasks()
        dlg.start_volt.set(-500)
        dlg.save_cv_changes(dlg.current_options.get(), app, app.cv.graph,
                            app.cv.cv_settings_frame)
        self.assertFalse(dlg.winfo_exists())  # 保存后窗口必须关闭
        self.assertEqual(app.device_params.cv_settings.start_voltage, -500)
        app.device_params.cv_settings.start_voltage = -900  # 还原


# ===== 回归：每个页面的「运行」按钮必须真正进入对应实验流程 =====
class TestRunButtonWiring(unittest.TestCase):
    """点击真实按钮并断言效果，守护"按钮 → 正确流程"这条线。

    回归历史 bug（2026-10-12 真机排查）：ASV 页按钮继承了
    CVFrame._run_scan → device.run_scan(canvas, button)，而
    ASVFrame.USBHandler.run_scan(delay) 签名不同 → TypeError 被
    Tk 回调吞掉 → 表现为"点运行没反应"。既有测试全部直接调
    handler.asv_run(...)（绕过按钮），语言残留测试只查按钮文字
    不查 command，所以全绿。注意：.invoke() 同样会吞回调异常，
    断言必须落在"流程确实被触发"（mock 被调 / 指令发出）上。
    """

    @classmethod
    def setUpClass(cls):
        with mock.patch('main.AmpUsb') as mock_usb:
            mock_usb.return_value.connected = False
            import main as main_mod
            cls.app = main_mod.ElectroChemGUI()
            cls.app.update_idletasks()

    @classmethod
    def tearDownClass(cls):
        _safe_destroy(cls.app)

    def test_asv_frame_overrides_run_scan(self):
        # ASV 处理器的 run_scan(delay) 与基类 run_scan(canvas, button)
        # 签名不同；ASVFrame 必须覆盖 _run_scan 走 asv_run，
        # 否则按钮会落到基类路径并 TypeError
        self.assertIsNot(ASVFrame._run_scan, CVFrame._run_scan)

    def test_asv_run_button_invokes_asv_flow(self):
        app = self.app
        app.asv.device.asv_run = mock.Mock()
        app.asv.run_button.invoke()
        app.asv.device.asv_run.assert_called_once_with(
            app.asv.graph, app.asv.run_button)

    def test_amp_run_button_invokes_amp_run(self):
        app = self.app
        app.amp.device.amp_run = mock.Mock()
        app.amp.run_button.invoke()
        app.amp.device.amp_run.assert_called_once_with(
            app.amp.graph, app.amp)

    def _cv_family_button_starts_scan(self, tab):
        # CV/LS/SWV/DPV：点击后必须发出扫描启动命令 'R'
        # （设备未连接时走恢复分支，但启动指令已发出）
        dev = tab.device.device  # 被 mock 的 comm 对象
        dev.reset_mock()
        tab.run_button.invoke()
        writes = [c.args[0] for c in dev.usb_write.call_args_list
                  if c.args and isinstance(c.args[0], str)]
        self.assertIn('R', writes, f"{tab.mode} 页点击运行未发出 'R'")

    def test_cv_run_button_starts_scan(self):
        self._cv_family_button_starts_scan(self.app.cv)

    def test_ls_run_button_starts_scan(self):
        self._cv_family_button_starts_scan(self.app.ls)

    def test_swv_run_button_starts_scan(self):
        self._cv_family_button_starts_scan(self.app.swv)

    def test_dpv_run_button_starts_scan(self):
        self._cv_family_button_starts_scan(self.app.dpv)

    def test_cv_scan_stop_label_is_generic(self):
        # 回归：CV 家族扫描中的按钮曾误用 asv_stop 文案，显示"停止 ASV"
        from i18n import get_text
        tab = self.app.cv
        tab.device._enter_scan_state()
        try:
            self.assertEqual(tab.run_button.cget('text'), get_text("stop"))
        finally:
            tab.device._exit_scan_state()




# ===== SWV 独立页端到端（假设备按固件分段结构生成数据） =====
class TestSwvStandaloneEndToEnd(unittest.TestCase):
    """SWV 独立页全流程：固件分段结构下 X 轴与数据等长、只画扫描段。"""

    def _run_page(self, start_type, start_mv, end_mv, inc_mv=16):
        from fake_device import FakeSerialComm, make_fake_ampusb
        master = mock.Mock()
        master.device_params = DeviceParameters()
        master.data_save_type = "Converted"
        master.after.side_effect = lambda _delay, cb: cb()
        s = master.device_params.cv_settings
        s.sweep_start_type = start_type
        s.start_voltage = start_mv
        s.end_voltage = end_mv
        s.swv_inc = inc_mv
        s.swv_height = 50
        s.swv_period = 20
        s.sweep_type, s.use_swv = 'LS', True
        fake = FakeSerialComm()
        usb = make_fake_ampusb(master, fake)
        usb.last_experiment = 'CV'  # 强制重发 SWV 参数
        handler = CVFrame.USBHandler(mock.Mock(), usb, master, None, mode='SWV')
        handler.settings = s
        handler.run_scan(handler.graph, mock.Mock())
        handler.graph.update_data.assert_called_once()
        x, y, _raw = handler.graph.update_data.call_args.args
        return x, y, fake, handler

    def test_swv_page_start_type_draws_scan_segment(self):
        """Start 起始（默认）：固件扫 start→end→start，页面只画扫描段。"""
        x, y, fake, handler = self._run_page('Start', 0, 320)
        n_expected = 320 // 16 + 1
        self.assertEqual(len(x), n_expected)
        self.assertEqual(len(x), len(y))
        self.assertEqual(x[0], 0)
        self.assertEqual(x[-1], 320)
        # G 命令确实发出，后缀 LS
        g_cmds = [c for c in fake.received if c.startswith('G|')]
        self.assertEqual(len(g_cmds), 1)
        self.assertTrue(g_cmds[0].endswith('|LS'))
        # 峰在扫描段内：数据应含明显峰形（最大值远大于基线）
        self.assertGreater(max(y) - min(y), 1.0)

    def test_swv_page_zero_start_still_single_segment(self):
        """Zero 起始：固件对 'L' 型仍只扫单段（分段只对 'C' 型生效），
        页面画出完整 start→end 扫描段。"""
        x, y, fake, handler = self._run_page('Zero', 160, 480)
        n_expected = (480 - 160) // 16 + 1
        self.assertEqual(len(x), n_expected)
        self.assertEqual(len(x), len(y))
        self.assertEqual(x[0], 160)
        self.assertEqual(x[-1], 480)
        g_cmds = [c for c in fake.received if c.startswith('G|')]
        self.assertTrue(g_cmds[0].endswith('|LZ'))

    def test_swv_page_estimate_matches_firmware_structure(self):
        """时间估算 = 分段总步数 × 每步周期，不得重复计入 delay_time。"""
        master = mock.Mock()
        master.device_params = DeviceParameters()
        s = master.device_params.cv_settings
        s.sweep_start_type = 'Start'
        s.start_voltage = 0
        s.end_voltage = 320
        s.swv_inc = 16
        s.swv_period = 20
        s.sweep_type, s.use_swv = 'LS', True
        handler = CVFrame.USBHandler.__new__(CVFrame.USBHandler)
        handler.settings = s
        est = handler._estimate_scan_seconds()
        # 固件 'L' 型单段：320/16=20 步 × 20ms + 1s 余量（估算值，允许近似）
        self.assertAlmostEqual(est, 20 * 20 / 1000.0 + 1.0, places=3)


# ===== 统一弹窗规则：CV/LS 页端到端 + 扫描中停止 =====
class TestUnifiedScanWindow(unittest.TestCase):
    """所有页面同一套弹窗规则：合一窗实时倒数、扫描中可停止、出错弹窗。"""

    def _make_page(self, mode, start_mv=0, end_mv=320):
        from fake_device import FakeSerialComm, make_fake_ampusb
        root = tk.Tk(); root.withdraw()
        root.device_params = DeviceParameters()
        root.data_save_type = "Converted"
        s = root.device_params.cv_settings
        s.sweep_start_type = 'Start'
        s.start_voltage = start_mv
        s.end_voltage = end_mv
        s.sweep_rate = 0.5
        s.swv_inc, s.swv_height, s.swv_period = 16, 50, 20
        s.sweep_type, s.use_swv = CVFrame.MODE_SETTINGS[mode]
        s.quiet_time_s = 0.0  # 本族测试验证绘图链路本身，跳过预处理静置
        fake = FakeSerialComm()
        usb = make_fake_ampusb(root, fake)
        usb.last_experiment = 'force-resend'
        graph = mock.Mock()
        handler = CVFrame.USBHandler(graph, usb, root, None, mode=mode)
        handler.settings = s
        button = tb.Button(root, text="run")
        return root, handler, fake, graph, button

    def _pump(self, root, ms=50):
        end = time.time() + ms / 1000.0
        while time.time() < end:
            root.update()

    def test_cv_end_to_end_draws_and_restores(self):
        """CV 页全链：合一窗出现 -> 数据画图 -> 窗口关闭 -> 按钮恢复原命令。"""
        root, handler, fake, graph, button = self._make_page('CV')
        orig_cmd = button.cget('command')
        handler.run_scan(graph, button, _delay=1)
        self.assertTrue(handler.is_running)
        # 扫描中按钮显示通用「停止」（曾误用 asv_stop 显示"停止 ASV"）
        self.assertEqual(str(button.cget('text')), get_text("stop"))
        self.assertIsNotNone(handler.timer_window)  # 合一窗已弹出
        self._pump(root, 300)  # 让轮询回调跑完
        graph.update_data.assert_called_once()
        x, y, _raw = graph.update_data.call_args.args
        self.assertEqual(len(x), len(y))
        self.assertGreater(len(x), 10)
        self.assertFalse(handler.is_running)
        self.assertIsNone(handler.timer_window)     # 扫完窗口关闭
        self.assertEqual(button.cget('command'), orig_cmd)  # 按钮命令恢复
        root.destroy()

    def test_stop_during_scan_resets_everything(self):
        """扫描中点停止：发 X 复位、取消轮询、关窗、按钮恢复；迟到回调不再画图。"""
        root, handler, fake, graph, button = self._make_page('CV')
        handler.run_scan(graph, button, _delay=60000)  # 长时间不触发，模拟扫描中
        self.assertTrue(handler.is_running)
        handler.stop()
        self.assertIn('X', fake.received)           # 设备收到复位
        self.assertFalse(handler.is_running)
        self.assertIsNone(handler.timer_window)     # 窗口关闭
        self.assertIsNone(handler._poll_after_id)   # 轮询已取消
        handler.run_scan_continue(graph)             # 迟到的回调必须直接返回
        graph.update_data.assert_not_called()
        root.destroy()

    def test_ls_end_to_end_draws(self):
        """LS 页同样走统一链路。"""
        root, handler, fake, graph, button = self._make_page('LS')
        handler.run_scan(graph, button, _delay=1)
        self._pump(root, 300)
        graph.update_data.assert_called_once()
        self.assertFalse(handler.is_running)
        root.destroy()

    def test_scan_window_is_timer_toplevel_in_scan_stage(self):
        """CV 页弹出的就是合一窗，且直接进入扫描倒计时状态。"""
        root, handler, fake, graph, button = self._make_page('CV')
        handler.run_scan(graph, button, _delay=60000)
        from dialogs import TimerToplevel
        self.assertIsInstance(handler.timer_window, TimerToplevel)
        self.assertEqual(handler.timer_window.stage, 'scan')
        handler.stop()
        root.destroy()


# ===== 菜单选中标记（选项 + 开发者） =====
class TestMenuIndicators(unittest.TestCase):
    """多选菜单项带选中标记，初值与真实状态一致，点击联动。"""

    def _build(self):
        import main as main_mod
        root = tk.Tk(); root.withdraw()
        class FakeGraph: user_sets_labels_after_run = True
        class FakeCV:
            graph = FakeGraph()
            def save_all_data(self): pass
        class FakeDevice:
            samples_to_smooth = 2
            def set_electrode_config(self, n): root.num_electrodes = n
            def select_voltage_source(self, v):
                root.voltage_source_key = "vsource_vdac" if v == "8-bit DAC" else "vsource_dvdac"
            def get_look_up_table(self): pass
            def get_export_channel(self, c): root.exported = c
        root.cv = FakeCV(); root.device = FakeDevice()
        root.device_params = DeviceParameters()
        root.num_electrodes = 3
        root.voltage_source_key = "vsource_vdac"
        root.data_save_type = "Raw Counts"
        root.open_data = lambda: None
        root.save_current_page_data = lambda: None
        root.delete_all_data_user_prompt = lambda: None
        root.set_adc_channel = lambda i: setattr(
            root.device_params.adc_tia, 'adc_channel', i)
        root.set_data_type = lambda t: setattr(root, 'data_save_type', t)
        main_mod.OptionMenu(root)
        menubar = root.nametowidget(root.cget("menu"))
        return root, menubar

    def _find(self, menu, label_part):
        for i in range(menu.index("end") + 1):
            try:
                if label_part in menu.entrycget(i, "label"):
                    return i
            except tk.TclError:
                continue
        return None

    def _selected(self, menu):
        out = []
        for i in range(menu.index("end") + 1):
            if menu.type(i) == "radiobutton":
                var = menu.tk.call(menu._w, "entrycget", i, "-variable")
                val = menu.tk.call(menu._w, "entrycget", i, "-value")
                if str(menu.tk.globalgetvar(var)) == str(val):
                    out.append(menu.entrycget(i, "label"))
        return out

    def _cascade(self, menu, label_part):
        idx = self._find(menu, label_part)
        self.assertIsNotNone(idx, "未找到菜单项: " + label_part)
        return menu.nametowidget(menu.entrycget(idx, "menu"))

    def test_developer_menus_marked(self):
        """开发者菜单：导出通道与数据导出两组带当前状态标记。"""
        root, menubar = self._build()
        dev = self._cascade(menubar, get_text("menu_developers"))
        chan = self._cascade(dev, get_text("dev_choose_channel"))
        self.assertEqual(self._selected(chan), ["0"])  # 默认通道 0
        dtype = self._cascade(dev, get_text("dev_choose_data"))
        self.assertEqual(self._selected(dtype), [get_text("dev_raw_data")])
        # 点击联动：选通道 2，标记跟随且状态更新
        chan.invoke(2)
        self.assertEqual(root.device_params.adc_tia.adc_channel, 2)
        self.assertEqual(self._selected(chan), ["2"])
        root.destroy()

    def test_option_menus_marked(self):
        """选项菜单四组标记与状态一致。"""
        root, menubar = self._build()
        opts = self._cascade(menubar, get_text("menu_options"))
        ele = self._cascade(opts, get_text("opt_electrode_config"))
        self.assertEqual(self._selected(ele), [get_text("opt_3electrode")])
        vs = self._cascade(opts, get_text("opt_voltage_source"))
        self.assertEqual(self._selected(vs), [get_text("opt_vdac")])
        sm = self._cascade(opts, get_text("opt_smooth_data"))
        self.assertEqual(self._selected(sm), [get_text("opt_values").format(2)])
        root.destroy()


import ttkbootstrap as tb
from i18n import get_text


class TestDeadlinePolling(unittest.TestCase):
    """设备慢时轮询按截止时间坚持，不再固定重试 2 次就放弃（SWV 无曲线的根因修复）。"""

    class _SlowDevice:
        """像真机但永远不回 Done：轮询只能等到截止时间。"""
        def __init__(self):
            self.read_calls = 0
            self.last_experiment = 'CV'
            self.connected = True
        def set_last_run(self, mode):
            self.last_experiment = mode
        def usb_write(self, msg, *a, **k):
            return True
        def usb_read_data(self, *a, **k):
            self.read_calls += 1
            return None

    def _make_handler(self, estimate_s=0.0):
        root = tk.Tk(); root.withdraw()
        root.device_params = DeviceParameters()
        root.data_save_type = "Converted"
        s = root.device_params.cv_settings
        s.start_voltage, s.end_voltage, s.sweep_rate = 0, 320, 0.5
        s.quiet_time_s = 0.0  # 本测试只验证轮询重试，跳过预处理静置
        device = self._SlowDevice()
        handler = CVFrame.USBHandler(mock.Mock(), device, root, None, mode='CV')
        handler.settings = s
        handler._estimate_scan_seconds = lambda: estimate_s
        handler._show_progress = lambda *a, **k: None
        handler._close_progress = lambda: None
        button = tb.Button(root, text="run")
        return root, handler, device, button

    def _pump(self, root, seconds):
        end = time.time() + seconds
        while time.time() < end:
            root.update()

    def test_polling_retries_until_deadline(self):
        """截止前持续重试：重试次数远超旧的 2 次上限。"""
        root, handler, device, button = self._make_handler()
        try:
            handler.run_scan(mock.Mock(), button, _delay=1)
            self._pump(root, 2.5)
            self.assertGreater(device.read_calls, 2, '重试次数应超过旧的 2 次上限')
            handler.stop()
        finally:
            root.destroy()

    def test_poll_stops_after_deadline(self):
        """超过截止时间后停止轮询、恢复按钮，不再死等。"""
        root, handler, device, button = self._make_handler(estimate_s=-100)
        try:
            handler.run_scan(mock.Mock(), button, _delay=1)
            self._pump(root, 0.8)
            count = device.read_calls
            self._pump(root, 1.5)
            self.assertEqual(device.read_calls, count, '超时后不应继续轮询')
            self.assertFalse(handler.is_running)
            self.assertIsNone(handler._poll_after_id)
        finally:
            root.destroy()


class TestLegendLanguageRefresh(unittest.TestCase):
    def test_default_labels_follow_language(self):
        from plotting import PyplotData
        import i18n
        d = PyplotData()
        d.add_data([0, 1], [1, 2])
        i18n.set_language('en')
        d.refresh_default_labels()
        self.assertEqual(d.label, ['data 1'])
        i18n.set_language('zh')
        d.refresh_default_labels()
        self.assertEqual(d.label, ['数据 1'])
        i18n.set_language('en')

    def test_user_named_labels_not_overwritten(self):
        from plotting import PyplotData
        import i18n
        d = PyplotData()
        d.add_data([0, 1], [1, 2])
        d.add_data([0, 1], [3, 4])
        d.change_label('MyRun', 1)
        d.refresh_default_labels()
        self.assertEqual(d.label[1], 'MyRun')

    def test_label_removed_with_data(self):
        from plotting import PyplotData
        d = PyplotData()
        d.add_data([0, 1], [1, 2])
        d.add_data([0, 1], [3, 4])
        d.colors.extend(['#111', '#222'])  # 模拟绘图后写入的颜色记录
        d.remove_data(0)
        self.assertEqual(len(d.label), 1)


class TestDialogCenteredOnMaster(unittest.TestCase):
    def test_timer_centers_on_master(self):
        from dialogs import TimerToplevel
        root = tk.Tk()
        try:
            root.geometry('400x300+50+60')
            root.update()
            timer = TimerToplevel(root, 0, 0, 0)
            timer.update()
            mx = root.winfo_rootx() + root.winfo_width() // 2
            my = root.winfo_rooty() + root.winfo_height() // 2
            tx = timer.winfo_rootx() + timer.winfo_width() // 2
            ty = timer.winfo_rooty() + timer.winfo_height() // 2
            # 容差 100px：居中代码用 winfo_reqwidth（请求尺寸），这里用
            # winfo_width（实际尺寸），Windows 下 DPI 缩放（125%/150%）+
            # 标题栏边框会让两者差出 30px 以上（真机踩坑：Win 下必挂）
            self.assertLess(abs(tx - mx), 100, '弹窗水平中心应贴近主窗口中心')
            self.assertLess(abs(ty - my), 100, '弹窗垂直中心应贴近主窗口中心')
            timer.destroy()
        finally:
            root.destroy()

    def test_timer_fallback_when_master_unmapped(self):
        from dialogs import TimerToplevel
        root = tk.Tk()
        try:
            root.withdraw()
            timer = TimerToplevel(root, 0, 0, 0)  # 不应抛异常
            timer.destroy()
        finally:
            root.destroy()


class TestASVDeadlinePolling(unittest.TestCase):
    """ASV 页与 CV 页同一截止时间轮询规则（修复 LS 跑完没线）。"""

    class _SlowDevice:
        def __init__(self):
            self.read_calls = 0
            self.connected = True
            self.last_experiment = 'ASV'
        def usb_write(self, *a, **k):
            return True
        def usb_read_message(self, *a, **k):
            self.read_calls += 1
            return None
        def reset(self):
            pass

    def _make_handler(self, estimate_s=0.0):
        root = tk.Tk(); root.withdraw()
        root.device_params = DeviceParameters()
        root.data_save_type = "Converted"
        device = self._SlowDevice()
        handler = ASVFrame.USBHandler(mock.Mock(), device, root, None)
        handler.run_button = tb.Button(root, text="run")
        handler.is_running = True
        handler._estimate_scan_seconds = lambda: estimate_s
        handler._show_progress = lambda *a, **k: None
        handler._close_progress = lambda: None
        return root, handler, device

    def _pump(self, root, seconds):
        end = time.time() + seconds
        while time.time() < end:
            root.update()

    def test_asv_polls_until_deadline(self):
        root, handler, device = self._make_handler()
        try:
            handler.run_scan(1)
            self._pump(root, 2.5)
            self.assertGreater(device.read_calls, 2, 'ASV 轮询不应只有旧的 2 次重试')
            handler.stop()
        finally:
            root.destroy()

    def test_asv_timeout_shows_error_and_recovers(self):
        root, handler, device = self._make_handler(estimate_s=-100)
        try:
            with mock.patch('experiments.messagebox.showerror') as err:
                handler.run_scan(1)
                self._pump(root, 0.8)
            err.assert_called_once()  # 超时要弹错误提示，不再静默
            self.assertFalse(handler.is_running)
            self.assertIsNone(handler._poll_after_id)
            self.assertEqual(str(handler.run_button.cget('text')), get_text('asv_run'))
        finally:
            root.destroy()

    def test_asv_stop_cancels_polling(self):
        root, handler, device = self._make_handler()
        try:
            handler.run_scan(60000)  # 长延迟模拟扫描中
            self.assertIsNotNone(handler._poll_after_id)
            with mock.patch.object(handler.device, 'reset', create=True):
                handler.stop()
            self.assertIsNone(handler._poll_after_id)
            count = device.read_calls
            handler.run_scan_continue()  # 迟到回调直接返回
            self.assertEqual(device.read_calls, count)
        finally:
            root.destroy()


class TestChronoDataTry(unittest.TestCase):
    """计时电流：按真实包数读全一段、读失败不死循环。"""

    def _make_handler(self, chunks):
        root = tk.Tk(); root.withdraw()
        root.device_params = DeviceParameters()
        device = mock.Mock()
        device.get_data.side_effect = chunks
        device.process_data.side_effect = lambda raw, *a, **k: raw  # 直通
        handler = AmpFrame.USBHandler(mock.Mock(), device, root)
        handler.t_ptr = -handler.time_step
        handler.data, handler.time = [], []
        return root, handler

    def test_reads_full_buffer_with_packet_count(self):
        root, handler = self._make_handler([[10, 11, 12]])
        try:
            self.assertTrue(handler.data_try())
            # 必须传包数：默认包数来自从未赋值的 usb_count(=0)，
            # 只读 1 个包会让残余数据污染下一条消息（真机没线的根因）
            handler.device.get_data.assert_called_with(handler.number_packets)
            self.assertEqual(handler.data, [10, 11, 12])  # 首段不丢点
            self.assertEqual(len(handler.time), 3)
        finally:
            root.destroy()

    def test_read_failure_returns_not_hangs(self):
        root, handler = self._make_handler([RuntimeError("usb timeout")])
        try:
            self.assertFalse(handler.data_try())  # 异常时直接返回，不死循环
        finally:
            root.destroy()

    def test_empty_chunk_returns(self):
        root, handler = self._make_handler([[]])
        try:
            self.assertFalse(handler.data_try())  # 空数据立即返回
        finally:
            root.destroy()


class TestChronoEndToEnd(unittest.TestCase):
    """计时电流全链：假设备流式推 Done0 -> F0 -> 数据，曲线应实时增长。"""

    def test_streaming_data_plots(self):
        from fake_device import FakeSerialComm, make_fake_ampusb
        root = tk.Tk(); root.withdraw()
        root.device_params = DeviceParameters()
        root.data_save_type = "Converted"
        fake = FakeSerialComm()
        usb = make_fake_ampusb(root, fake)
        graph = mock.Mock()
        handler = AmpFrame.USBHandler(graph, usb, root)
        handler.amp_run(graph, None)
        try:
            end = time.time() + 2.0
            while time.time() < end and not graph.update_amp_data.called:
                root.update()
            graph.update_amp_data.assert_called()
            pts = root.device_params.amp_settings.sampling_rate >= 1000 and 200 or 50
            self.assertGreaterEqual(len(handler.data), 1)
            self.assertEqual(len(handler.data), len(handler.time))
            # 首段点数 = 采样率/5（>=1000Hz 分支），一个点都不许丢
            expected = int(root.device_params.amp_settings.sampling_rate / 5.0) \
                if root.device_params.amp_settings.sampling_rate >= 1000 else \
                int(root.device_params.amp_settings.sampling_rate / 2.0)
            self.assertEqual(len(handler.data), expected)
        finally:
            handler.cancel_run()
            root.destroy()

    def test_garbage_message_ignored(self):
        """残留/乱码消息不能被当 Done0 解析（通道字符必须是数字）。"""
        root = tk.Tk(); root.withdraw()
        root.device_params = DeviceParameters()
        device = mock.Mock()
        device.usb_read_message.return_value = '\x00\xd0\x04d\x00'  # 错位二进制
        handler = AmpFrame.USBHandler(mock.Mock(), device, root)
        handler.running = True
        handler.master = root
        handler.data_try = mock.Mock()
        handler.running_read()
        handler.data_try.assert_not_called()
        handler.running = False
        root.destroy()


class TestLegendNoTitle(unittest.TestCase):
    def test_legend_has_no_title(self):
        pe = PyplotEmbed.__new__(PyplotEmbed)
        pe.data = mock.Mock()
        pe.data.label = ['data 1']
        pe.graph_area = mock.Mock()
        pe.graph_area.axis.get_legend_handles_labels.return_value = (['h'], ['data 1'])
        pe.graph_area.axis.get_legend.return_value = None
        pe.update_legend()
        kwargs = pe.graph_area.axis.legend.call_args.kwargs
        self.assertNotIn('title', kwargs, '图例不应再带“数据系列”标题')


class TestLegacyPyusbEraBugs(unittest.TestCase):
    """同类问题回归守护：不能再有对 SerialComm 下标/endpoint 的访问。"""

    def test_amp_run_does_not_subscript_device(self):
        """amp_run 不得访问 device.device[...]（kit-059 是 SerialComm，不可下标）。"""
        from fake_device import FakeSerialComm, make_fake_ampusb
        root = tk.Tk(); root.withdraw()
        root.device_params = DeviceParameters()
        root.data_save_type = "Converted"
        usb = make_fake_ampusb(root, FakeSerialComm())
        graph = mock.Mock()
        handler = AmpFrame.USBHandler(graph, usb, root)
        # SerialComm/FakeSerialComm 均不可下标：若 amp_run 里再出现
        # device.device[...] 访问，这里会直接抛 TypeError
        handler.amp_run(graph, None)
        handler.cancel_run()
        root.destroy()

    def test_restart_dialog_survives_without_destroy(self):
        """重启对话框在设备对象没有 destroy/close 时也必须能重启流程。"""
        import inspect
        import dialogs
        src = inspect.getsource(dialogs)
        self.assertNotIn('master.device.destroy()\n        os.execl', src,
                         '不能再不加保护地直接调用 master.device.destroy()')

    def test_amp_smoothing_uses_correct_attribute(self):
        """计时电流的平滑必须写 samples_to_smooth（不是拼错的 samples_smooth）。"""
        import inspect
        import experiments
        src = inspect.getsource(experiments)
        self.assertNotIn('device.samples_smooth =', src)


class TestAmpChannelFilterAndNonblocking(unittest.TestCase):
    """计时电流只画选定通道；消息读取非阻塞（全页面通用）。"""

    def _make_handler(self, message):
        root = tk.Tk(); root.withdraw()
        root.device_params = DeviceParameters()
        device = mock.Mock()
        device.usb_read_message.return_value = message
        handler = AmpFrame.USBHandler(mock.Mock(), device, root)
        handler.running = True
        handler.master = root
        handler.data_try = mock.Mock(return_value=True)
        return root, handler, device

    def test_selected_channel_accepted(self):
        ch = None
        root, handler, device = self._make_handler(None)
        try:
            ch = str(root.device_params.adc_tia.adc_channel)
            device.usb_read_message.return_value = 'Done' + ch + '\x00'
            handler.running_read()
            handler.data_try.assert_called_once()
            device.usb_write.assert_called_with('F' + ch)
        finally:
            handler.running = False
            root.destroy()

    def test_other_channels_ignored(self):
        root, handler, device = self._make_handler(None)
        try:
            selected = root.device_params.adc_tia.adc_channel
            other = (selected + 1) % 4
            device.usb_read_message.return_value = 'Done%d\x00' % other
            handler.running_read()
            handler.data_try.assert_not_called()   # 非选定通道不取数
            # 也不应发送 F 命令
            self.assertFalse(any(str(c.args[0]).startswith('F')
                                 for c in device.usb_write.call_args_list))
        finally:
            handler.running = False
            root.destroy()

    def test_time_axis_has_real_gaps(self):
        """相邻两段的时间间隔 = 4×段长（固件轮采 4 通道），不压缩。"""
        root = tk.Tk(); root.withdraw()
        root.device_params = DeviceParameters()
        device = mock.Mock()
        device.get_data.side_effect = [[1, 2, 3], [4, 5, 6]]
        device.process_data.side_effect = lambda raw, *a, **k: raw
        handler = AmpFrame.USBHandler(mock.Mock(), device, root)
        handler.data, handler.time = [], []
        try:
            handler.data_try()
            handler.data_try()
            seg1_end = handler.time[2]
            seg2_start = handler.time[3]
            gap = seg2_start - seg1_end
            expected = (4 - 1) * 3 * handler.time_step + handler.time_step
            self.assertAlmostEqual(gap, expected, places=9)
        finally:
            root.destroy()

    def test_message_read_nonblocking(self):
        """缓冲无字节时消息读取立即返回 None，不调用阻塞 read。"""
        from comm import AmpUsb
        usb = AmpUsb.__new__(AmpUsb)
        usb.connected = True
        serial_dev = mock.Mock()
        serial_dev.bytes_waiting.return_value = 0
        usb.device = serial_dev
        self.assertIsNone(usb.usb_read_data(encoding='str'))
        serial_dev.read_data.assert_not_called()  # 没有进入阻塞读
        # 有字节时只读实际存在的数量
        serial_dev.bytes_waiting.return_value = 6
        serial_dev.read_data.return_value = 'Done0\x00'
        self.assertEqual(usb.usb_read_data(encoding='str'), 'Done0\x00')
        serial_dev.read_data.assert_called_with(6, encoding='str')


class TestGetDataTermination(unittest.TestCase):
    """终止码落在块中间时，必须在其位置截断（真机计时电流垃圾尾的根因）。"""

    def _make_usb(self, byte_stream):
        from comm import AmpUsb
        usb = AmpUsb.__new__(AmpUsb)
        usb.connected = True
        usb.samples_to_smooth = 1
        usb.master = mock.Mock()
        usb.device_params = mock.Mock()
        dev = mock.Mock()
        # 模拟串口：按请求的 64 字节切块返回（无包边界）
        buf = bytearray(byte_stream)
        def read_data(n, encoding=None):
            chunk = bytes(buf[:n]); del buf[:n]
            if encoding == 'int16':
                return list(struct.unpack(f"{len(chunk)//2}h", chunk))
            return chunk.decode('utf-8', errors='replace')
        dev.read_data = read_data
        usb.device = dev
        return usb

    def test_termination_mid_chunk_truncates_exactly(self):
        from comm import TERMINATION_CODE
        import struct as st
        payload = list(range(100, 300)) + [TERMINATION_CODE]  # 200 点 + 终止码
        # 终止码后面紧跟下一条 "Done1" 消息的字节（模拟阻塞等待期间到达）
        stream = st.pack(f"{len(payload)}h", *payload) + b'Done1\x00' + b'\x01' * 40
        usb = self._make_usb(stream)
        data = usb.get_data(7)
        self.assertEqual(len(data), 200)          # 200 个有效点，一个不多
        self.assertEqual(data[:3], [100, 101, 102])
        self.assertEqual(data[-1], 299)
        self.assertNotIn(TERMINATION_CODE, data)  # 终止码不得留在数据里

    def test_termination_at_chunk_end_still_works(self):
        from comm import TERMINATION_CODE
        import struct as st
        payload = [5] * 63 + [TERMINATION_CODE]  # 恰好 64 个 int16，终止码在块尾
        stream = st.pack(f"{len(payload)}h", *payload)
        usb = self._make_usb(stream)
        data = usb.get_data(2)
        self.assertEqual(data, [5] * 63)

class TestPortBusyResilience(unittest.TestCase):
    """端口被占用时不得崩溃：跳过该端口，全部失败则以未连接状态启动。"""

    def _fake_port(self, name='COM8'):
        port = mock.Mock()
        port.vid = comm_module.USB_VENDOR_ID
        port.pid = comm_module.USB_PRODUCT_ID
        port.device = name
        return port

    def test_busy_port_skipped_not_crash(self):
        with mock.patch.object(comm_module.serial.tools.list_ports, 'comports',
                               return_value=[self._fake_port()]), \
             mock.patch.object(comm_module.serial, 'Serial',
                               side_effect=comm_module.serial.SerialException(
                                   "could not open port")):
            sc = comm_module.SerialComm()
        self.assertTrue(sc.found)          # 端口是看到了的
        self.assertFalse(sc.connected)     # 但没连上
        self.assertIsNone(sc.device)       # 不崩溃，返回 None

    def test_busy_first_port_falls_through_to_second(self):
        good = mock.Mock()
        good.readline.return_value = b"Naresuan Potentiostat\r\n"
        serial_effects = [comm_module.serial.SerialException("busy"), good]
        with mock.patch.object(comm_module.serial.tools.list_ports, 'comports',
                               return_value=[self._fake_port('COM8'),
                                             self._fake_port('COM9')]), \
             mock.patch.object(comm_module.serial, 'Serial',
                               side_effect=serial_effects):
            sc = comm_module.SerialComm()
        self.assertTrue(sc.connected)
        self.assertIs(sc.device, good)
        good.close.assert_not_called()

    def test_handshake_failure_closes_handle(self):
        bad = mock.Mock()
        bad.readline.return_value = b""  # 不应答
        with mock.patch.object(comm_module.serial.tools.list_ports, 'comports',
                               return_value=[self._fake_port()]), \
             mock.patch.object(comm_module.serial, 'Serial', return_value=bad):
            sc = comm_module.SerialComm()
        self.assertFalse(sc.connected)
        bad.close.assert_called_once()  # 握手失败必须释放句柄，否则自己占着端口


# ===== Test Stirring Pin Reset =====
class TestStirringPinReset(unittest.TestCase):
    """P2.0 残留高电平修复：连接成功归零 + 关窗归零（附录 D.5）。

    ZK-TD2 用 P13/P04 都需要干净的低→高变化才触发；上次会话异常退出
    会把 P2.0 卡在高电平，导致新会话的 O|1 没有上升沿、继电器不动作。
    """

    def test_connect_sends_stirring_off(self):
        """连接成功（AmpUsb 初始化）时发一次 O|0 归零 P2.0。"""
        from fake_device import FakeSerialComm
        fake = FakeSerialComm()
        with mock.patch.object(comm_module, 'SerialComm', return_value=fake), \
             mock.patch.object(comm_module.AmpUsb, 'find_voltage_source'), \
             mock.patch.object(comm_module.AmpUsb, 'calibrate'):
            usb = comm_module.AmpUsb(mock.Mock(), DeviceParameters())
        self.assertTrue(usb.connected)
        self.assertIn('off', fake.stirring_log)

    def test_destroyer_sends_stirring_off(self):
        """关窗（destroyer）时尽力发一次 O|0。"""
        import main as main_module
        fake_device_obj = mock.Mock()
        fake_device_obj.connected = True
        fake_app = mock.Mock()
        fake_app.device = fake_device_obj
        had_app = hasattr(main_module, 'app')
        old_app = getattr(main_module, 'app', None)
        main_module.app = fake_app
        try:
            with mock.patch.object(main_module.sys, 'exit', side_effect=SystemExit):
                self.assertRaises(SystemExit, main_module.destroyer)
        finally:
            if had_app:
                main_module.app = old_app
            else:
                del main_module.app
        fake_device_obj.set_stirring.assert_called_once_with(False)
        fake_app.destroy.assert_called_once()

    def test_destroyer_survives_disconnected_device(self):
        """设备未连接/已断开时关窗不抛异常。"""
        import main as main_module
        fake_device_obj = mock.Mock()
        fake_device_obj.connected = False
        fake_app = mock.Mock()
        fake_app.device = fake_device_obj
        had_app = hasattr(main_module, 'app')
        old_app = getattr(main_module, 'app', None)
        main_module.app = fake_app
        try:
            with mock.patch.object(main_module.sys, 'exit', side_effect=SystemExit):
                self.assertRaises(SystemExit, main_module.destroyer)
        finally:
            if had_app:
                main_module.app = old_app
            else:
                del main_module.app
        fake_device_obj.set_stirring.assert_not_called()
        fake_app.destroy.assert_called_once()


# ===== Test LUT 弹窗与保存当前页 =====
class TestShowLookupTable(unittest.TestCase):
    """导出 LUT 改为弹窗显示（原来是 print 到控制台，pythonw 下不可见）。"""

    def setUp(self):
        self.root = tk.Tk()
        self.root.withdraw()

    def tearDown(self):
        _safe_destroy(self.root)

    def test_popup_shows_lut_values(self):
        from dialogs import ShowLookupTable
        self.root.device = mock.Mock()
        self.root.device.connected = True
        self.root.device.get_look_up_table.return_value = list(range(16))
        dlg = ShowLookupTable(self.root)
        try:
            content = dlg.children['!text'].get('1.0', 'end')
            self.assertIn('0', content)
            self.assertIn('15', content)
            self.assertIn('8:', content)  # 第二行起始索引
        finally:
            dlg.destroy()

    def test_popup_handles_no_data(self):
        from dialogs import ShowLookupTable
        self.root.device = mock.Mock()
        self.root.device.connected = False  # 未连接：不炸，显示提示
        dlg = ShowLookupTable(self.root)
        try:
            content = dlg.children['!text'].get('1.0', 'end')
            self.assertNotEqual(content.strip(), '')
        finally:
            dlg.destroy()


class TestSaveCurrentPageData(unittest.TestCase):
    """保存菜单路由到当前标签页：CV/LS/SWV/ASV 走 save_all_data，CA 走 amp.save_data。"""

    def _make_gui(self, current_frame):
        from main import ElectroChemGUI
        gui = mock.Mock()
        gui.notebook.select.return_value = 'frame_path'
        gui.nametowidget.return_value = current_frame
        gui.amp = mock.Mock()
        return gui

    def test_saves_scan_frame(self):
        from main import ElectroChemGUI
        frame = mock.Mock()
        gui = self._make_gui(frame)
        ElectroChemGUI.save_current_page_data(gui)
        frame.save_all_data.assert_called_once()
        gui.amp.save_data.assert_not_called()

    def test_saves_amp_frame(self):
        from main import ElectroChemGUI
        gui = self._make_gui(None)
        gui.nametowidget.return_value = gui.amp
        ElectroChemGUI.save_current_page_data(gui)
        # CA 数据在页面的 USBHandler（amp.device）上，不是 master.device
        gui.amp.save_data.assert_called_once_with(gui.amp.device)

    def test_no_tab_selected_is_noop(self):
        from main import ElectroChemGUI
        gui = self._make_gui(None)
        gui.notebook.select.return_value = ''
        ElectroChemGUI.save_current_page_data(gui)
        gui.nametowidget.assert_not_called()


# ===== Test DPV 独立页 =====
class TestDPVStandaloneEndToEnd(unittest.TestCase):
    """DPV 独立页全流程：发 'P' 命令，数据按 SWV 同款差分规则处理。"""

    def _run_page(self, start_type, start_mv, end_mv, inc_mv=16):
        from fake_device import FakeSerialComm, make_fake_ampusb
        master = mock.Mock()
        master.device_params = DeviceParameters()
        master.data_save_type = "Converted"
        master.after.side_effect = lambda _delay, cb: cb()
        s = master.device_params.cv_settings
        s.sweep_start_type = start_type
        s.start_voltage = start_mv
        s.end_voltage = end_mv
        s.swv_inc = inc_mv
        s.swv_height = 50
        s.swv_period = 20
        s.sweep_type, s.use_swv = 'LS', True
        fake = FakeSerialComm()
        usb = make_fake_ampusb(master, fake)
        usb.last_experiment = 'CV'  # 强制重发参数
        handler = CVFrame.USBHandler(mock.Mock(), usb, master, None, mode='DPV')
        handler.settings = s
        handler.run_scan(handler.graph, mock.Mock())
        handler.graph.update_data.assert_called_once()
        x, y, _raw = handler.graph.update_data.call_args.args
        return x, y, fake, handler

    def test_dpv_page_sends_p_command(self):
        """DPV 页发 'P' 命令（不是 'G'），字段布局与 'G' 一致，后缀 LS。"""
        x, y, fake, handler = self._run_page('Start', 0, 320)
        p_cmds = [c for c in fake.received if c.startswith('P|')]
        g_cmds = [c for c in fake.received if c.startswith('G|')]
        self.assertEqual(len(p_cmds), 1)
        self.assertEqual(len(g_cmds), 0)
        self.assertTrue(p_cmds[0].endswith('|LS'))
        # 6 个字段：P|start|end|步进|幅值|周期|类型
        self.assertEqual(len(p_cmds[0].split('|')), 7)

    def test_dpv_page_data_shape(self):
        """差分后每步 1 点，x 轴是阶梯基底电位，x 与 y 等长。"""
        x, y, fake, handler = self._run_page('Start', 0, 320)
        n_expected = 320 // 16 + 1
        self.assertEqual(len(x), n_expected)
        self.assertEqual(len(x), len(y))
        self.assertEqual(x[0], 0)
        self.assertEqual(x[-1], 320)

    def test_dpv_page_in_mode_settings(self):
        """MODE_SETTINGS / TITLE_KEYS / 运行按钮文案都有 DPV 项。"""
        from experiments import CVFrame
        self.assertEqual(CVFrame.MODE_SETTINGS['DPV'], ('LS', True))
        self.assertIn('DPV', CVFrame.CVSettingDisplay.TITLE_KEYS)
        from i18n import get_text
        for key in ('tab_dpv', 'dpv_title', 'dpv_run', 'dpv_settings_title'):
            self.assertTrue(get_text(key))  # 缺 key 会返回空或抛错


# ===== Test 删除当前页数据 =====
class TestDeleteCurrentPageData(unittest.TestCase):
    """删除菜单改为按当前标签页删除（与保存对称）；CA 页支持清空。"""

    def test_routes_to_current_frame(self):
        from main import ElectroChemGUI
        gui = mock.Mock()
        frame = mock.Mock()
        gui.notebook.select.return_value = 'path'
        gui.nametowidget.return_value = frame
        ElectroChemGUI.delete_current_page_data(gui)
        frame.delete_all_data.assert_called_once()

    def test_no_tab_selected_is_noop(self):
        from main import ElectroChemGUI
        gui = mock.Mock()
        gui.notebook.select.return_value = ''
        ElectroChemGUI.delete_current_page_data(gui)
        gui.nametowidget.assert_not_called()

    def test_amp_delete_clears_data(self):
        """AmpFrame.delete_all_data 清图线 + USBHandler 的 time/data。"""
        amp = AmpFrame.__new__(AmpFrame)
        amp.graph = mock.Mock()
        amp.device = mock.Mock()
        amp.device.time = [0.1, 0.2]
        amp.device.data = [1.0, 2.0]
        AmpFrame.delete_all_data(amp)
        amp.graph.delete_all_lines.assert_called_once()
        self.assertEqual(amp.device.time, [])
        self.assertEqual(amp.device.data, [])

    def test_delete_all_covers_all_pages(self):
        """delete_all_data（兼容保留）覆盖 6 个页面，包括 amp/asv/dpv。"""
        from main import ElectroChemGUI
        gui = mock.Mock()
        frames = [mock.Mock() for _ in range(6)]
        (gui.cv, gui.ls, gui.swv, gui.dpv, gui.amp, gui.asv) = frames
        ElectroChemGUI.delete_all_data(gui)
        for f in frames:
            f.delete_all_data.assert_called_once()

    def test_save_works_after_delete_and_rescan(self):
        """真机 bug 回归：删除当前页→再扫→保存报 No data to save。
        根因是 delete_all_data 换新 PyplotData 断开了 graph 的引用链；
        修复后必须原地清空，删-扫-存全流程通畅。"""
        from plotting import PyplotData
        frame = CVFrame.__new__(CVFrame)
        frame.data = PyplotData()
        frame.graph = mock.Mock()
        frame.graph.data = frame.data          # PyplotEmbed 的引用绑定
        frame.master = mock.Mock()
        frame.master.data_save_type = "Converted"
        # 第一次扫描 + 删除
        frame.graph.data.add_data([0, 1], [0.1, 0.2])
        CVFrame.delete_all_data(frame)
        # 关键断言 1：删完后 graph 和 frame 仍指向同一对象（引用未断）
        self.assertIs(frame.graph.data, frame.data)
        self.assertEqual(frame.data.index, 0)
        # 关键断言 2：再扫一次（数据经 graph 写入），保存不再被判为空
        frame.graph.data.add_data([0, 1], [0.3, 0.4])
        with mock.patch('experiments.open_file', return_value=None) as m_open:
            CVFrame.save_all_data(frame)       # 不应提前 return
            m_open.assert_called_once()        # 到了开文件对话框这一步
        self.assertEqual(frame.data.index, 1)
        self.assertEqual(frame.data.label[0], get_text("data_label").format(1))

    def test_reset_clears_all_fields(self):
        from plotting import PyplotData
        d = PyplotData()
        d.add_data([0], [1.0])
        d.reset()
        self.assertEqual(d.index, 0)
        self.assertEqual(d.name_index, 0)
        self.assertEqual(d.voltage_data, [])
        self.assertEqual(d.current_data, [])
        self.assertEqual(d.label, [])


# ===== Test 打开数据自动路由到对应页 =====
class TestOpenDataRouting(unittest.TestCase):
    """保存的 CSV 重新打开：按 experiment 元数据跳到对应页载入；
    老文件无元数据按表头猜（time→计时电流页，voltage→CV 页）。"""

    def _write_csv(self, content):
        import tempfile
        fd, path = tempfile.mkstemp(suffix='.csv')
        with os.fdopen(fd, 'w', newline='') as f:
            f.write(content)
        self.addCleanup(os.remove, path)
        return path

    def _make_gui(self):
        from main import ElectroChemGUI
        gui = mock.Mock()
        for name in ('cv', 'ls', 'swv', 'dpv', 'asv', 'amp'):
            setattr(gui, name, mock.Mock())
        return gui

    def _open(self, gui, path):
        from main import ElectroChemGUI
        with mock.patch('main.open_file', return_value=path):
            ElectroChemGUI.open_data(gui)

    def test_routes_by_metadata(self):
        cases = {'CV': 'cv', 'LS': 'ls', 'SWV': 'swv', 'DPV': 'dpv', 'ASV': 'asv'}
        for tag, attr in cases.items():
            gui = self._make_gui()
            path = self._write_csv(
                "# experiment: {0}\nvoltage,数据 1\n ,\n0,0.1\n100,0.2\n".format(tag))
            self._open(gui, path)
            frame = getattr(gui, attr)
            frame.open_data.assert_called_once()
            gui.notebook.select.assert_called_once_with(frame)

    def test_routes_amp_by_metadata(self):
        gui = self._make_gui()
        path = self._write_csv(
            "# experiment: AMP\n# sampling_rate_Hz: 1000\ntime,current\n0.001, -0.1\n0.002, -0.1\n")
        self._open(gui, path)
        gui.amp.open_data.assert_called_once()
        gui.notebook.select.assert_called_once_with(gui.amp)

    def test_legacy_files_guess_by_header(self):
        # 老计时电流文件（无元数据）→ amp 页
        gui = self._make_gui()
        path = self._write_csv("time,current\n0.001, -0.1\n")
        self._open(gui, path)
        gui.amp.open_data.assert_called_once()
        # 老伏安文件（无元数据）→ cv 页
        gui = self._make_gui()
        path = self._write_csv("voltage,数据 1\n ,\n0,0.1\n")
        self._open(gui, path)
        gui.cv.open_data.assert_called_once()

    def test_unknown_experiment_falls_back_to_cv(self):
        gui = self._make_gui()
        path = self._write_csv(
            "# experiment: EIS\nvoltage,数据 1\n ,\n0,0.1\n")
        self._open(gui, path)
        gui.cv.open_data.assert_called_once()

    def test_unreadable_file_warns(self):
        gui = self._make_gui()
        path = self._write_csv("garbage\n1,2,3\n")
        with mock.patch('main.open_file', return_value=path), \
             mock.patch('main.messagebox.showwarning') as warn:
            from main import ElectroChemGUI
            ElectroChemGUI.open_data(gui)
        warn.assert_called_once()
        gui.cv.open_data.assert_not_called()


class TestAmpOpenData(unittest.TestCase):
    """计时电流页 open_data：载入 time/current 并画图；保存带元数据头。"""

    def test_open_data_plots_and_stores(self):
        amp = AmpFrame.__new__(AmpFrame)
        amp.graph = mock.Mock()
        amp.graph.l = None
        amp.device = mock.Mock()
        amp.open_data(["time", "current"],
                      [['0.001', ' -0.1'], ['0.002', ' -0.2'], ['0.003', ' -0.15']])
        self.assertEqual(amp.device.time, [0.001, 0.002, 0.003])
        self.assertEqual(len(amp.device.data), 3)
        amp.graph.update_amp_data.assert_called_once()
        t, y, window = amp.graph.update_amp_data.call_args.args
        self.assertEqual(t[0], 0.001)
        self.assertGreaterEqual(window, t[-1] - t[0])  # 窗口覆盖全程

    def test_open_data_replaces_stale_line(self):
        """旧线引用还在时先删再画（否则数据写到已删除的 Line2D 上）。"""
        amp = AmpFrame.__new__(AmpFrame)
        amp.graph = mock.Mock()
        old_line = mock.Mock()
        amp.graph.l = old_line
        amp.device = mock.Mock()
        amp.open_data(["time", "current"], [['0.001', ' -0.1']])
        old_line.remove.assert_called_once()
        self.assertIsNone(amp.graph.l)

    def test_save_writes_metadata(self):
        import tempfile
        path = tempfile.mktemp(suffix='.csv')
        self.addCleanup(os.remove, path)
        device = mock.Mock()
        device.data = [1.0, 2.0]
        device.time = [0.001, 0.002]
        device.settings.sampling_rate = 1000
        device.settings.voltage = 500
        with mock.patch('experiments.open_file', return_value=path):
            AmpFrame.save_data(device)
        from utils import load_csv_file_full
        metadata, header, data_rows = load_csv_file_full(path)
        self.assertEqual(metadata.get('experiment'), 'AMP')
        self.assertEqual(header[0], 'time')
        self.assertEqual(len(data_rows), 2)


# ===== Test 真窗口全页面 保存/删除/打开 回环 =====
class TestFullGuiRoundTrip(unittest.TestCase):
    """用真实 ElectroChemGUI + 假设备做全页面数据操作回环。

    用户真机踩坑（2026-08-26）：CA 页保存/删除失效、打开文件只有 AMP 正常。
    mock 拼装的测试看不出这些问题，必须用真窗口真控件。
    """

    @classmethod
    def setUpClass(cls):
        import main as main_mod
        import comm as comm_module
        from fake_device import FakeSerialComm
        cls.main_mod = main_mod
        cls.fake = FakeSerialComm()
        with mock.patch.object(comm_module, 'SerialComm', return_value=cls.fake), \
             mock.patch.object(comm_module.AmpUsb, 'calibrate'):
            cls.app = main_mod.ElectroChemGUI()
        cls.app.withdraw()
        cls.app.update()

    @classmethod
    def tearDownClass(cls):
        try:
            cls.app.destroy()
        except tk.TclError:
            pass

    def _save_page(self, frame, path):
        # open_file('saveas') 返回的是文件句柄不是路径
        fh = open(path, 'w', newline='')
        try:
            with mock.patch('experiments.open_file', return_value=fh):
                frame.save_all_data()
        finally:
            fh.close()

    def _temp_path(self):
        import tempfile
        path = tempfile.mktemp(suffix='.csv')
        self.addCleanup(os.remove, path)
        return path

    def test_scan_pages_save_delete_open_roundtrip(self):
        """CV/LS/SWV/DPV/ASV：注入曲线→保存→删除当前页→重新打开→曲线回来。"""
        app = self.app
        pages = {'CV': app.cv, 'LS': app.ls, 'SWV': app.swv,
                 'DPV': app.dpv, 'ASV': app.asv}
        for tag, frame in pages.items():
            with self.subTest(page=tag):
                frame.graph.update_data([0.0, 100.0, 200.0], [1.0, 2.0, 3.0],
                                        label='roundtrip')
                app.update()
                path = self._temp_path()
                self._save_page(frame, path)
                self.assertTrue(os.path.exists(path))
                # 删除当前页
                app.notebook.select(frame)
                app.delete_current_page_data()
                app.update()
                self.assertEqual(frame.data.index, 0,
                                 f'{tag} 页删除后 data 应清空')
                # 重新打开：应自动跳到该页且曲线回来
                with mock.patch('main.open_file', return_value=path):
                    app.open_data()
                app.update()
                self.assertIs(app.nametowidget(app.notebook.select()), frame,
                              f'打开 {tag} 文件应跳到 {tag} 页')
                self.assertGreaterEqual(len(frame.graph.plotted_lines), 1,
                                        f'{tag} 页打开后应有曲线')

    def test_amp_save_delete_open_roundtrip(self):
        """CA 页：注入数据→保存当前页（菜单路径）→删除→打开→曲线回来。"""
        app = self.app
        handler = app.amp.device  # USBHandler 持有 time/data
        handler.time = [0.001, 0.002, 0.003]
        handler.data = [-0.1, -0.2, -0.15]
        app.notebook.select(app.amp)
        path = self._temp_path()
        with mock.patch('experiments.open_file', return_value=path):
            app.save_current_page_data()  # 菜单路径：保存当前页
        self.assertTrue(os.path.exists(path))
        with open(path, encoding='utf-8') as f:
            self.assertIn('# experiment: AMP', f.read())
        # 删除当前页
        app.delete_current_page_data()
        self.assertEqual(handler.time, [])
        self.assertEqual(handler.data, [])
        # 重新打开：跳到 CA 页且曲线画出来
        with mock.patch('main.open_file', return_value=path):
            app.open_data()
        app.update()
        self.assertIs(app.nametowidget(app.notebook.select()), app.amp)
        self.assertIsNotNone(app.amp.graph.l, 'CA 页打开后应有曲线')
        self.assertEqual(len(handler.time), 3)
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
