LLLIO400/PSoC-Potentiostat/experiments.py

# Copyright (c) 2015-2023 Kyle Lopin (Naresuan University) <kylel@nu.ac.th>
# Licensed under the Creative Commons Attribution-ShareAlike 3.0 (CC BY-SA 3.0 US) License
# Modified by Zhijian Yi (Guangdong, China), 2026 — PSoC-Potentiostat-YI-1.0

"""Experiment frames: CV, Amperometry and ASV panels with their USB handlers."""

import csv
import logging
import math
import os
import time
import tkinter as tk
from datetime import datetime
from tkinter import messagebox, ttk

import ttkbootstrap as tb

from config import ADC_SATURATION_COUNTS, max_cv_cycles
from comm import (USB_IN_BYTE_SIZE, COMPLETE_MESSAGE,
                  FAILURE_DELAY)
from i18n import get_text
from plotting import PyplotData, PyplotEmbed
from utils import (make_voltage_profile, make_dpv_x_line, make_cv_x_line,
                   cv_lut_length, open_file, check_display_type)

# 固件 ADC_CHANNELS（globals.h）：计时电流 ISR 攒满一段后在 4 个
# 通道间轮切，Done0..Done3 循环发送；只有选定通道是真实电流
AMP_FW_CHANNELS = 4


def _grid_param_rows(frame, rows):
    """在 frame 上按 (名称key, 值var) 列表铺两列参数行：
    名称左对齐灰色小字，值右对齐加粗。返回名称标签列表（随语言刷新）。"""
    name_labels = []
    for i, (key, var) in enumerate(rows):
        name = tb.Label(frame, text=get_text(key), bootstyle='secondary',
                        anchor='w', font=('', 9))
        name.grid(row=i, column=0, sticky='ew', padx=(0, 8), pady=3)
        value = tb.Label(frame, textvariable=var, anchor='e',
                         font=('', 10, 'bold'))
        value.grid(row=i, column=1, sticky='ew', pady=3)
        name_labels.append(name)
    frame.columnconfigure(0, weight=3)
    frame.columnconfigure(1, weight=2)
    return name_labels


class CVFrame(tb.Frame):
    # 各页面共用的扫描方式映射：页面 -> (sweep_type, use_swv)
    # DPV 数据处理与 SWV 相同（每步 2 个交错采样点、差分），故 use_swv=True；
    # 发参数时按 self.mode 区分 'G'(SWV) / 'P'(DPV) 命令
    MODE_SETTINGS = {'CV': ('CV', False), 'LS': ('LS', False),
                     'SWV': ('LS', True), 'DPV': ('LS', True)}

    def __init__(self, master, parent_notebook, graph_properties,
                 initialize=True, mode='CV'):
        tb.Frame.__init__(self, parent_notebook)
        self.master = master
        self.mode = mode  # 'CV' / 'LS' / 'SWV'
        self.settings = master.device_params.cv_settings
        self._apply_mode()
        print(f"settings: {self.settings}")
        self.data = PyplotData()
        self.columnconfigure(0, weight=1)
        # 右侧参数栏保留最小宽度，窗口偏窄时压缩图区而不是挤掉参数
        self.columnconfigure(1, minsize=250)
        self.rowconfigure(3, weight=1)
        # 布局参考主流电化学工作站（CHI/Autolab/PSTrace）：
        # 顶部命令丝带 → 分隔线 → 左图区（卡片化）/右参数面板。
        # PyplotEmbed 的 master 必须是页面本身（数据/图例回调挂在页面上），
        # 用 grid(in_=) 把它放进图区卡片，不改控件父子关系
        self.command_bar = tb.Frame(self, padding=(10, 6, 10, 2))
        self.command_bar.grid(row=0, column=0, columnspan=2, sticky='ew')
        ttk.Separator(self, orient='horizontal').grid(row=1, column=0,
                                                      columnspan=2, sticky='ew')
        # matplotlib 工具栏独立行：小窗口下也不会被丝带按钮挤没；
        # 默认隐藏（grid_remove 记住位置），点"添加工具栏"时显示
        self.toolbar_row = tb.Frame(self, padding=(10, 0, 10, 0))
        self.toolbar_row.grid(row=2, column=0, columnspan=2, sticky='ew')
        self.toolbar_row.grid_remove()
        self.plot_card = tb.Labelframe(self, text=get_text(self._caption_key()),
                                       bootstyle='info', padding=(4, 2, 4, 4))
        self.plot_card.grid(row=3, column=0, sticky='nsew', padx=(10, 4),
                            pady=(6, 8))
        # 卡片内部网格必须配重，否则图组件停在初始 5 英寸宽度不随卡片拉伸
        self.plot_card.rowconfigure(0, weight=1)
        self.plot_card.columnconfigure(0, weight=1)
        options_frame = tb.Frame(self)
        options_frame.grid(row=3, column=1, sticky='nsew', padx=(4, 10),
                           pady=(6, 8))
        self.graph = self.make_graph_area(master, graph_properties)
        self.graph.grid(in_=self.plot_card, row=0, column=0, sticky='nsew')
        self.device = self.USBHandler(self.graph, master.device, master, self.data,
                                      mode=self.mode)
        self.params_group = tb.Labelframe(options_frame, text=get_text("grp_params"),
                                          bootstyle='info', padding=10)
        self.params_group.pack(side="top", fill=tk.X)
        self.cv_settings_frame = self.CVSettingDisplay(master, self.params_group,
                                                       self.graph, master.device_params,
                                                       self.device, mode=self.mode)
        self.cv_settings_frame.pack(side="top", fill=tk.X)
        if initialize:
            time.sleep(0.4)
            self.device.send_cv_parameters()
            time.sleep(0.1)
            master.device.usb_write("L|3")
            time.sleep(0.1)
        self.make_cv_buttons(self.command_bar, self.graph)

    def _caption_key(self):
        # 图区卡片标题复用页签文案
        return {'CV': 'tab_cv', 'LS': 'tab_ls', 'SWV': 'tab_swv',
                'DPV': 'tab_dpv'}[self.mode]

    def _apply_mode(self):
        """把本页面对应的扫描方式写入共享设置（运行/发参数前调用）。"""
        self.settings.sweep_type, self.settings.use_swv = \
            self.MODE_SETTINGS[self.mode]

    def _run_scan(self):
        self._apply_mode()  # 每个页面固定跑自己的技术，与全局设置无关
        self.device.run_scan(self.graph, self.run_button)

    def make_graph_area(self, master, graph_props):
        if check_display_type() == 'matplotlib':
            current_lim = master.device_params.adc_tia.current_lims
            low_voltage = self.settings.low_voltage
            high_voltage = self.settings.high_voltage
            graph = PyplotEmbed(self.toolbar_row, graph_props.cv_plot, self,
                                current_lim, low_voltage, high_voltage)
            # 三个页面共用 cv_plot，标题无法区分且页签已标明技术，直接去掉图标题
            graph.graph_area.axis.set_title('')
            graph.text_keys = {'title': None,
                               'xlabel': 'axis_voltage',
                               'ylabel': 'axis_current'}
        else:
            raise NotImplementedError
        return graph

    def make_cv_buttons(self, bar, cv_graph):
        # 顶部命令丝带：运行(实心) | 保存/删除(描边) | 数据分析组(描边)
        # ...右侧: 样式/工具栏。matplotlib 工具栏切换显示在本丝带内
        self.run_button = tb.Button(bar, text=self._get_run_button_text(),
                                    bootstyle="success", width=14,
                                    command=self._run_scan)
        self.run_button.pack(side='left', padx=(0, 10))
        self.save_button = tb.Button(bar, text=get_text("cv_save"),
                                     bootstyle="success-outline", width=7,
                                     command=self.save_all_data)
        self.save_button.pack(side='left', padx=3)
        self.delete_button = tb.Button(bar, text=get_text("cv_delete"),
                                       bootstyle="danger-outline", width=7,
                                       command=self.user_select_delete_some_data)
        self.delete_button.pack(side='left', padx=3)
        ttk.Separator(bar, orient='vertical').pack(side='left', fill='y',
                                                   padx=8, pady=2)
        # 数据分析按钮（作用于图上最新一条曲线），按使用流程排列
        self.region_button = tb.Button(bar, text=get_text("btn_select_region"),
                                       bootstyle="secondary-outline", width=9,
                                       command=self.toggle_region_select)
        self.region_button.pack(side='left', padx=3)
        self.smooth_button = tb.Button(bar, text=get_text("btn_smooth"),
                                       bootstyle="secondary-outline", width=7,
                                       command=self.apply_smooth)
        self.smooth_button.pack(side='left', padx=3)
        self.baseline_button = tb.Button(bar, text=get_text("btn_baseline"),
                                         bootstyle="secondary-outline", width=7,
                                         command=self.apply_baseline)
        self.baseline_button.pack(side='left', padx=3)
        self.peaks_button = tb.Button(bar, text=get_text("btn_find_peaks"),
                                      bootstyle="secondary-outline", width=7,
                                      command=self.find_peaks_now)
        self.peaks_button.pack(side='left', padx=3)
        self.restore_button = tb.Button(bar, text=get_text("btn_restore"),
                                        bootstyle="secondary-outline", width=7,
                                        command=self.restore_original)
        self.restore_button.pack(side='left', padx=3)
        # 右侧：打开数据（原先只能从文件菜单进）+ 视图类按钮
        self.toolbar_button = tb.Button(bar, text=get_text("cv_add_toolbar"),
                                        bootstyle="secondary-outline",
                                        command=cv_graph.toolbar_toggle)
        self.toolbar_button.pack(side='right', padx=3)
        self.style_button = tb.Button(bar, text=get_text("cv_change_style"),
                                      bootstyle="secondary-outline",
                                      command=self.change_data_labels)
        self.style_button.pack(side='right', padx=3)
        self.open_button = tb.Button(bar, text=get_text("ribbon_open"),
                                     bootstyle="secondary-outline",
                                     command=self.open_data)
        self.open_button.pack(side='right', padx=3)
        self._region_hint_shown = False

    def restore_original(self):
        """还原最新曲线为平滑/基线扣除之前的原始数据。"""
        from tkinter import messagebox
        if self.graph.restore_latest():
            messagebox.showinfo(get_text("title_peak_analysis"),
                                get_text("restore_done"))
        else:
            messagebox.showinfo(get_text("title_peak_analysis"),
                                get_text("restore_none"))

    def toggle_region_select(self):
        """切换峰区域框选模式（在图上拖选 mV 区间，供基线扣除/寻峰使用）。"""
        active = self.graph.toggle_region_selector()
        self.region_button.config(bootstyle="info" if active else "secondary")
        if active and not self._region_hint_shown:
            self._region_hint_shown = True
            messagebox.showinfo(get_text("region_hint_title"),
                                get_text("region_hint"))

    def apply_smooth(self):
        """Savitzky-Golay 平滑最新曲线。"""
        from algorithms import sg_smooth
        if not self.graph.transform_latest(lambda v, c: (v, sg_smooth(c))):
            logging.info("No curve to smooth")

    def apply_baseline(self):
        """对最新曲线做基线扣除；若已框选峰区域则只用区域外数据拟合基线。"""
        from algorithms import subtract_baseline
        region = self.graph.peak_region

        def _subtract(v, c):
            # subtract_baseline 只返回扣除后的电流
            return v, subtract_baseline(v, c, peak_region=region)
        if not self.graph.transform_latest(_subtract):
            logging.info("No curve for baseline subtraction")

    def get_sweep_rate(self):
        """本页技术的扫速 (V/s)，用于电量换算（ASV 页覆盖）。"""
        return self.settings.sweep_rate

    def find_peaks_now(self):
        """自动寻峰：平滑 + 基线扣除 + 峰检测（含面积/电量），标注并弹窗。"""
        from tkinter import messagebox
        from algorithms import analyze_stripping_peak
        line = self.graph.get_latest_line()
        if line is None:
            messagebox.showinfo(get_text("title_peak_analysis"),
                                get_text("no_peak_found"))
            return
        v, c = line.get_xdata(), line.get_ydata()
        peaks, _ = analyze_stripping_peak(v, c,
                                          peak_region=self.graph.peak_region,
                                          sweep_rate=self.get_sweep_rate())
        self.graph.annotate_peaks(peaks)
        if not peaks:
            messagebox.showinfo(get_text("title_peak_analysis"),
                                get_text("no_peak_found"))
            return
        lines = [get_text("peak_result_full").format(
            i, p['voltage'], p['height'], p['half_width'],
            p.get('area', 0.0), p.get('charge', 0.0))
            for i, p in enumerate(peaks, 1)]
        messagebox.showinfo(get_text("title_peak_analysis"), "\n".join(lines))

    def curve_math(self):
        """多曲线运算（相减/平均/归一化），结果加入当前页。"""
        from dialogs import CurveMathDialog
        CurveMathDialog(self)

    def export_peaks(self):
        """把最新曲线的寻峰结果导出为 CSV（峰电位/峰电流/半峰宽）。"""
        from algorithms import analyze_stripping_peak
        from tkinter import messagebox as _mb
        line = self.graph.get_latest_line()
        if line is None:
            _mb.showinfo(get_text("export_peaks"),
                         get_text("export_peaks_none"))
            return
        v, c = line.get_xdata(), line.get_ydata()
        peaks, _processed = analyze_stripping_peak(
            v, c, peak_region=self.graph.peak_region,
            sweep_rate=self.get_sweep_rate())
        if not peaks:
            _mb.showinfo(get_text("export_peaks"),
                         get_text("no_peak_found"))
            return
        _file = open_file('saveas', return_filename=True)
        if not _file:
            return
        try:
            with open(_file, 'w', newline='', encoding='utf-8-sig') as f:
                writer = csv.writer(f, lineterminator='\n')
                writer.writerow([get_text("export_peaks")])
                writer.writerow(["#", get_text("axis_voltage") + " (mV)",
                                 get_text("axis_current") + " (µA)",
                                 get_text("peak_half_width") + " (mV)",
                                 "面积 (µA·mV)", "电量 (µC)"])
                for i, p in enumerate(peaks, 1):
                    writer.writerow([i, round(p['voltage'], 2),
                                     round(p['height'], 4),
                                     round(p['half_width'], 2),
                                     round(p.get('area', 0.0), 4),
                                     round(p.get('charge', 0.0), 6)])
            logging.info("peaks exported: %s", _file)
        except Exception:
            logging.exception("peak export failed")
            _mb.showerror(get_text("save_error_title"), "export failed")

    def get_metadata(self):
        """生成保存到 CSV 头部的参数信息（ASV 页覆盖此方法）。"""
        s = self.master.device_params.cv_settings
        return {
            "experiment": getattr(self, 'mode', 'CV'),
            "start_voltage_mV": s.start_voltage,
            "end_voltage_mV": s.end_voltage,
            "sweep_rate_V/s": s.sweep_rate,
            "use_swv": s.use_swv,
            "swv_inc_mV": s.swv_inc,
            "swv_height_mV": s.swv_height,
            "swv_period_ms": s.swv_period,
            "current_range": self.master.device_params.adc_tia.current_lims,
        }

    def _get_run_button_text(self):
        return get_text({'CV': 'cv_run', 'LS': 'ls_run',
                         'SWV': 'swv_run', 'DPV': 'dpv_run'}[self.mode])

    def refresh_language(self):
        # Refresh all UI text on this panel when the language changes.
        if getattr(self.device, 'is_running', False):
            self.run_button.config(text=get_text("asv_stop"))
        else:
            self.run_button.config(text=self._get_run_button_text())
        self.save_button.config(text=get_text("cv_save"))
        self.style_button.config(text=get_text("cv_change_style"))
        self.delete_button.config(text=get_text("cv_delete"))
        self.open_button.config(text=get_text("ribbon_open"))
        self.toolbar_button.config(text=get_text("cv_add_toolbar"))
        self.region_button.config(text=get_text("btn_select_region"))
        self.smooth_button.config(text=get_text("btn_smooth"))
        self.baseline_button.config(text=get_text("btn_baseline"))
        self.peaks_button.config(text=get_text("btn_find_peaks"))
        self.restore_button.config(text=get_text("btn_restore"))
        if getattr(self, 'params_group', None) is not None:
            self.params_group.config(text=get_text("grp_params"))
        if getattr(self, 'plot_card', None) is not None:
            self.plot_card.config(text=get_text(self._caption_key()))
        self.cv_settings_frame.refresh_language()
        self.graph.refresh_language()

    def change_data_labels(self):
        from dialogs import ChangeDataLegend
        ChangeDataLegend(self, self.graph)

    def delete_some_data(self, list_of_index_to_delete):
        for index in reversed(list_of_index_to_delete):
            self.graph.delete_a_line(index)

    def save_all_data(self):
        logging.debug("saving all data")
        if self.data.index == 0:
            logging.info("No data to save")
            return
        _file = open_file('saveas')
        if _file:
            self.data.save_all_data(_file, self.master.data_save_type,
                                    self.get_metadata())

    def autosave_scan(self, x_line, currents, backup_dir=None):
        """每次扫描完成自动备份一份 CSV 到程序目录下的 autosave_backup/ 文件夹。

        文件格式与手动“保存数据”一致（元数据注释行 + voltage 表头 + 备注行），
        可直接用 文件->打开数据 重新载入；备份失败只记日志，不影响主流程。
        """
        try:
            if backup_dir is None:
                backup_dir = os.path.join(os.path.dirname(os.path.abspath(__file__)),
                                          "autosave_backup")
            os.makedirs(backup_dir, exist_ok=True)
            stamp = datetime.now().strftime("%Y%m%d_%H%M%S")
            metadata = self.get_metadata()
            experiment = str(metadata.get('experiment', getattr(self, 'mode', 'CV')))
            path = os.path.join(backup_dir, "{0}_{1}.csv".format(stamp, experiment))
            with open(path, 'w', newline='', encoding='utf-8-sig') as f:
                writer = csv.writer(f, lineterminator='\n')
                for key, value in metadata.items():
                    writer.writerow(["# {0}: {1}".format(key, value)])
                writer.writerow(["voltage", "{0}_{1}".format(experiment, stamp)])
                writer.writerow([" ", "autosave"])
                for volt, cur in zip(x_line, currents):
                    writer.writerow([volt, cur])
            logging.info("autosaved scan backup: %s", path)
            return path
        except Exception:
            logging.exception("autosave failed")
            return None

    def delete_all_data(self):
        self.graph.delete_all_lines()
        # 原地清空，不能换新对象：graph/device 都引用着同一个
        # PyplotData，换对象会断链（删后扫描能画但保存报无数据）
        self.data.reset()

    def user_select_delete_some_data(self):
        from dialogs import UserSelectDataDelete
        UserSelectDataDelete(self)

    def open_data(self, header, data_rows):
        """从 load_csv_file 返回的 (表头, 数据行) 载入曲线。"""
        logging.debug("opening data in cv frame")
        _data_hold = [[] for _ in range(len(header))]
        for row in data_rows:
            if len(row) < len(header):
                continue
            for i in range(len(header)):
                _data_hold[i].append(float(row[i]))
        if not _data_hold[0]:
            return
        for i in range(1, len(header)):
            self.graph.update_data(_data_hold[0], _data_hold[i], label=header[i])

    def set_tia_current_lim(self, _value, current_limit):
        self.cv_settings_frame.set_current_var_str(_value)
        self.graph.resize_y(current_limit)

    class USBHandler(object):
        def __init__(self, graph, device, master, data, mode='CV'):
            self.graph = graph
            self.device = device
            self.master = master
            self.data = data
            self.params = master.device_params
            self.mode = mode  # 'CV'/'LS'/'SWV'/'DPV'，决定是否需要重发扫描参数
            self.settings = master.device_params.cv_settings
            self.usb_packet_count = 0
            self.run_chrono = False
            self.run_button = None
            self._progress = None
            # 统一弹窗规则：与 ASV 页共用 TimerToplevel（计时/扫描合一窗）
            self.timer_window = None
            self._poll_after_id = None   # 轮询回调 id，停止时取消
            self.is_running = False
            self._saved_button_cmd = None

        def _estimate_scan_seconds(self):
            """估算扫描耗时（秒），仅用于进度弹窗提示，不保证精确。"""
            s = self.settings
            # CV 设置用 start/end_voltage（low/high 只是镜像缓存）；
            # ASV 设置是独立类，同样提供 start_voltage，
            # 但其真实扫描区间是 low_voltage(=富集电位)~high_voltage(=终止电位)，
            # start_voltage 已在 ASVSettings 中同步为 low_voltage
            if hasattr(s, 'start_voltage'):
                start, end = s.start_voltage, s.end_voltage
            else:
                start, end = s.low_voltage, s.high_voltage
            range_mv = abs(end - start)
            delay_s = getattr(s, 'delay_time', 0) / 1000.0
            sweep_type = getattr(s, 'sweep_type', 'CV')
            if getattr(s, 'use_swv', False) or sweep_type in ('SWV', 'DPV'):
                # 方波/差分脉冲：步数 × 每步周期
                if hasattr(s, 'plate_time'):
                    # ASV 设置是独立类（无 swv_inc/swv_period 字段），
                    # 必须用 pulse_inc/pulse_width，
                    # 否则会误读 swv_inc/swv_period 默认值导致估算翻倍
                    inc = getattr(s, 'pulse_inc', 1)
                    period_ms = getattr(s, 'pulse_width', 10)
                else:
                    inc = getattr(s, 'swv_inc', getattr(s, 'pulse_inc', 1))
                    period_ms = getattr(s, 'swv_period', getattr(s, 'pulse_width', 10))
                # 固件对 'L' 型扫描（本软件 SWV/DPV 均为此类）只扫单段
                # start→end，每步 1 个周期；delay_time 在 SWV 下本身就是
                # 全程扫描时间，不能再加一遍
                return (range_mv / max(float(inc), 0.001)) * period_ms / 1000.0 + 1.0
            rate = max(getattr(s, 'sweep_rate', 0.1), 1e-6)  # V/s
            one_way = (range_mv / 1000.0) / rate
            if sweep_type == 'CV':
                # CV 三角波往返 = 2×，再乘循环圈数
                cycles = max(1, int(getattr(s, 'cycles', 1)))
                return delay_s + cycles * 2 * one_way
            return delay_s + one_way

        def _cycle_scan_seconds(self):
            """GUI 逐圈调度时单圈耗时（固件多圈模式无需分圈）。"""
            total = self._estimate_scan_seconds()
            if self.mode == 'CV':
                cycles = max(1, int(getattr(self.settings, 'cycles', 1)))
                if cycles > 1:
                    return total / cycles
            return total

        def _show_progress(self, extra_seconds=0.0):
            """统一弹窗：所有页面共用 TimerToplevel（计时/扫描合一窗，屏幕居中）。
            CV/LS/SWV 无前置阶段，窗口直接以扫描倒计时状态出现。
            extra_seconds：扫描前静置时长，计入倒计时总数（否则静置期
            会先消耗倒计时，显示提前归零）。"""
            try:
                from dialogs import TimerToplevel
                est = max(1, int(round(self._estimate_scan_seconds()
                                       + float(extra_seconds))))
                self.timer_window = TimerToplevel(self.master, 0, 0, 0, scan_est=0)
                self.timer_window.show_scan(est)
            except Exception:
                logging.exception("failed to show unified scan window")
                self.timer_window = None

        def _close_progress(self):
            tw, self.timer_window = getattr(self, 'timer_window', None), None
            if tw is not None:
                try:
                    tw.close()
                except Exception:
                    pass

        def _enter_scan_state(self):
            """扫描期间：运行按钮变为「停止」，点击即中断（与 ASV 页同一规则）。"""
            self.is_running = True
            if self.run_button is None:
                return
            try:
                self._saved_button_cmd = self.run_button.cget('command')
            except Exception:
                self._saved_button_cmd = None
            try:
                self.run_button.state(['!disabled'])
                # CV/LS/SWV/DPV 扫描中统一显示通用「停止」；
                # asv_stop 是 ASV 页专属文案（曾误用导致 CV 扫描显示"停止 ASV"）
                self.run_button.config(text=get_text("stop"), command=self.stop,
                                       bootstyle="danger")
            except Exception:
                pass
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
