LLLIO400/PSoC-Potentiostat/(commit log)

2026-11-03 PSoC-Potentiostat-YI-1.0: 中文双语电化学工作站 GUI + 固件增强补丁
    基于 KyleLopin/PSoC-Potentiostat (PSoC 5LP / CY8CKIT-059) 的分支版本。
    - 上位机: CV/LSV/SWV/DPV/ASV/计时电流, 中英双语, 模拟模式, 80 类离线测试
    - 固件补丁: 搅拌控制 O / 真 DPV P / CV 多圈 S|...|N / X 复位不休眠
    - 实拍素材: 整机外观/装配内部照片与演示视频
    - 新增与修改部分沿用上游 CC BY-SA 3.0 许可证
    [AMP_cottrell_120s.csv, Bi1000ppb_验证_20261013_汇总.csv, Bi200ppb_ASV_20261013_210348.csv, Bi200ppb_验证_20261013_汇总.csv, CV_K3FeCN6_3cycles.csv, DPV_ferri_pulse.csv, LS-ASV_Pb_100ppb.csv, LS-ASV_Pb_20ppb.csv]
2026-11-03 实拍素材: 装配内部细节 x2 + 整机外观(3D打印外壳与电极支架) + 实机演示视频
2026-11-03 README: 中英双语首页(基于原作者分支), 链接完整说明文档与 Release v1.0
2026-11-03 README: 增加测试说明(离开实验室后完成的说明, 中英对照)
2026-11-03 README: 嵌入实机演示 GIF(早期装配版, 配最终版说明)
2026-11-03 README: 增加配套固件分支(YI-1.0-firmware)互链
2026-11-03 硬件: 3D打印外壳 STEP 模型(PETG) + SPE 电极 PCB 转接板打板文件, 各配说明
    [ep管支架.step, 恒电位仪上盖.step, 恒电位仪外壳.step, 恒电位仪电极转接板支架1.step, 恒电位仪电极转接板支架2.step]
2026-11-03 LICENSE: CC BY-SA 3.0 声明(上游 Kyle Lopin + 本分支 Zhijian Yi)
